Dodokamel2005/EPS-/bac-hardware/README.md

# bac-hardware

Hardware design and manufacturing files for the Build a CubeSat project. Includes ECAD files, BOMs, gerber files, notes and other relevant artifacts.
