Dodokamel2005/EPS-/bac-hardware/eps/DISCLAIMER.md

# Disclaimer

This project contains the design files for an EPS (Electrical Power System) PCB intended for use in a CubeSat. Please note that this hardware has not been tested and is provided "as is" without any guarantees or warranties. By using these files, you acknowledge and agree that:

1. The hardware design has not been tested or validated in any capacity.
2. Any use of this hardware design is at your own risk.
3. The authors and contributors to this project are not liable for any damages, losses, or issues that arise from the use of these design files.
4. You are responsible for thoroughly testing and validating the hardware design before any use in critical applications.

We strongly recommend that you perform extensive testing and validation before using this hardware in any real-world applications, particularly in mission-critical or safety-critical environments.
