Dodokamel2005/EPS-/bac-hardware/adcs/magnetorquer-placeholder-XY/1.5U/bac_Magnetorquer_XY_1.5U_v1r2_EdgeCuts.dxf

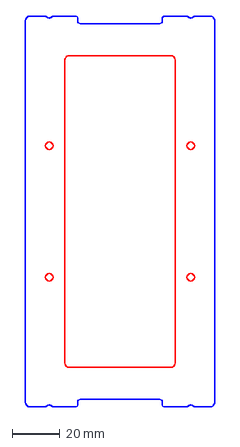
[picture p2: CAD file, 2025-06-12]
bac-hardware/adcs/magnetorquer-placeholder-XY/1.5U/bac_Magnetorquer_XY_1.5U_v1r2_EdgeCuts.dxf
79.2 x 163.4 mm
