Dodokamel2005/EPS-/bac-hardware/adcs/magnetorquer-placeholder-XY/1U/bac_Magnetorquer_XY_1U_v1r2_EdgeCuts.dxf

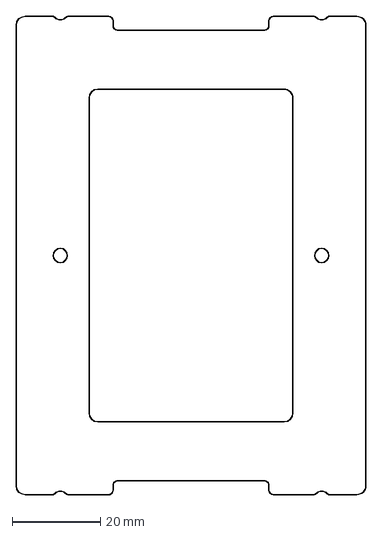
[picture p3: CAD file, 2025-06-12]
bac-hardware/adcs/magnetorquer-placeholder-XY/1U/bac_Magnetorquer_XY_1U_v1r2_EdgeCuts.dxf
79.2 x 108.4 mm
