Dodokamel2005/EPS-/bac-hardware/adcs/magnetorquer-placeholder-XY/2U/bac_Magnetorquer_XY_2U_v1r2_EdgeCuts.dxf

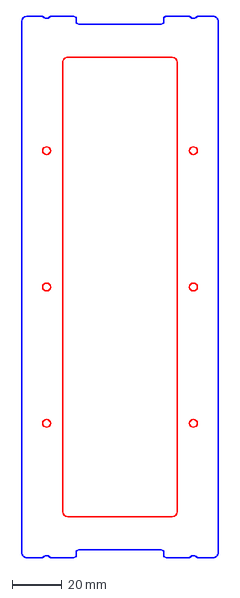
[picture p4: CAD file, 2025-06-12]
bac-hardware/adcs/magnetorquer-placeholder-XY/2U/bac_Magnetorquer_XY_2U_v1r2_EdgeCuts.dxf
79.2 x 218.4 mm
