Dodokamel2005/EPS-/bac-hardware/adcs/magnetorquer-placeholder-XY/3U/bac_Magnetorquer_XY_3U_v1r1_EdgeCuts.dxf

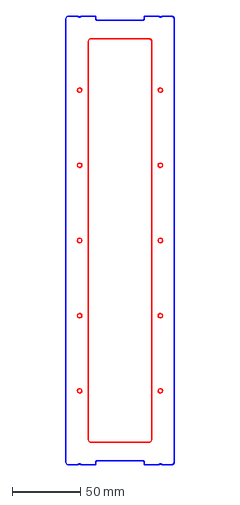
[picture p5: CAD file, 2025-06-12]
bac-hardware/adcs/magnetorquer-placeholder-XY/3U/bac_Magnetorquer_XY_3U_v1r1_EdgeCuts.dxf
79.2 x 328.4 mm
