Dodokamel2005/EPS-/bac-hardware/eps/battery-contact/18650-2s2p/graphics/bac_EPS_Bay_v1r1_Battery_Contact_EdgeCuts.dxf

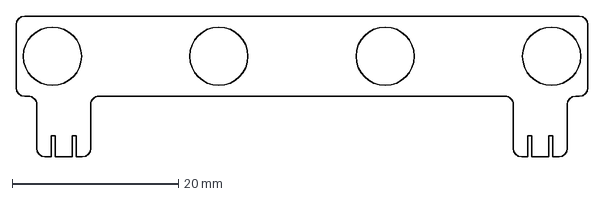
[picture p6: CAD file, 2025-06-12]
bac-hardware/eps/battery-contact/18650-2s2p/graphics/bac_EPS_Bay_v1r1_Battery_Contact_EdgeCuts.dxf
68.7 x 16.9 mm
