Dodokamel2005/EPS-/bac-hardware/eps/eps-main-board/full/design/bac_EPS_Bay_v1r1_EdgeCuts.dxf

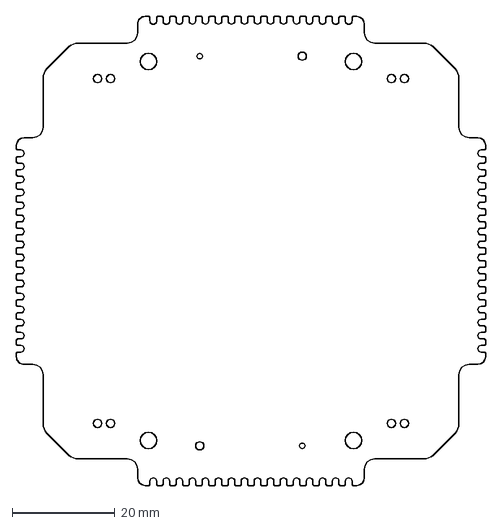
[picture p7: CAD file, 2025-06-12]
bac-hardware/eps/eps-main-board/full/design/bac_EPS_Bay_v1r1_EdgeCuts.dxf
91.5 x 91.5 mm
