Dodokamel2005/EPS-/bac-hardware/mcu/micromod-main-board/dual-function-single-bacbus/graphics/bac_PCB_Rail_Mount_v2r1_Pad_Keepouts.dxf

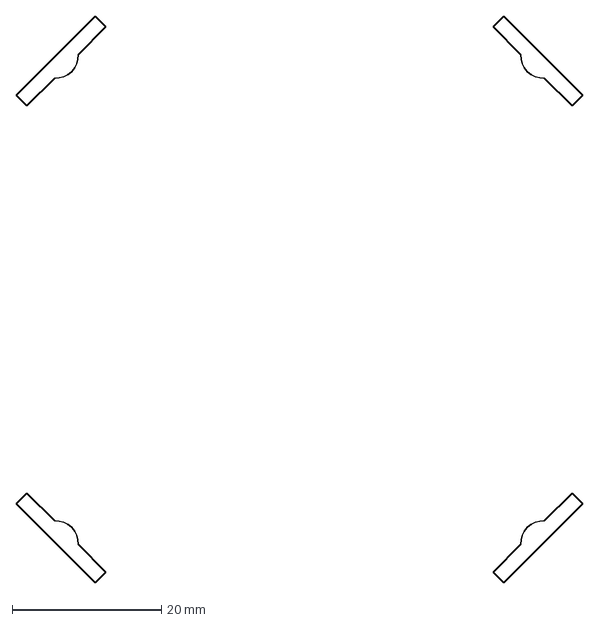
[picture p8: CAD file, 2025-06-12]
bac-hardware/mcu/micromod-main-board/dual-function-single-bacbus/graphics/bac_PCB_Rail_Mount_v2r1_Pad_Keepouts.dxf
76.0 x 76.0 mm
