Dodokamel2005/EPS-/bac-hardware/panel/hatch/design/bac_Panel_Hatch_v1r1_EdgeCuts.dxf

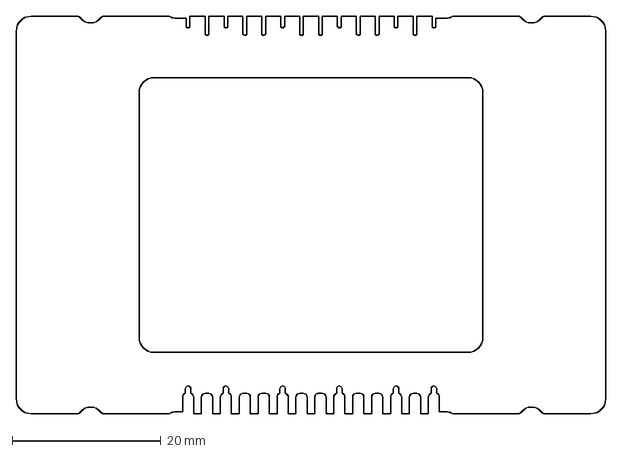
[picture p9: CAD file, 2025-06-12]
bac-hardware/panel/hatch/design/bac_Panel_Hatch_v1r1_EdgeCuts.dxf
79.2 x 53.4 mm
