Dodokamel2005/EPS-/bac-hardware/panel/pv/design/bac_Panel_PV_v1r1_EdgeCuts.dxf

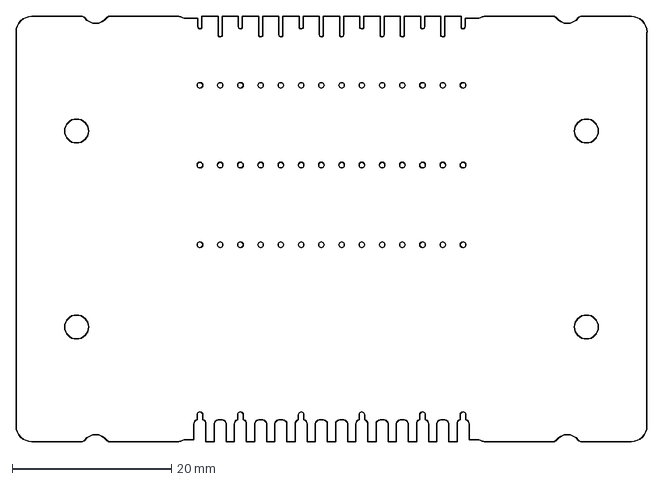
[picture p10: CAD file, 2025-06-12]
bac-hardware/panel/pv/design/bac_Panel_PV_v1r1_EdgeCuts.dxf
79.2 x 53.4 mm
