Dodokamel2005/EPS-/bac-hardware/resources/kicad-libraries/cm5-carrier-v1/3d/piecol-B3U-3000PM-B.step

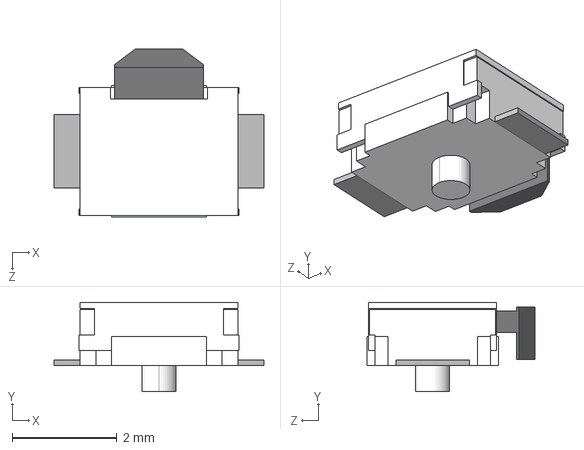
[picture p11: CAD file, 2025-06-12]
bac-hardware/resources/kicad-libraries/cm5-carrier-v1/3d/piecol-B3U-3000PM-B.step
4.00 x 1.70 x 3.20 mm
