Dodokamel2005/EPS-/bac-hardware/resources/kicad-libraries/eps-v1/3d/Cantherm-MF52A1103F3380.step

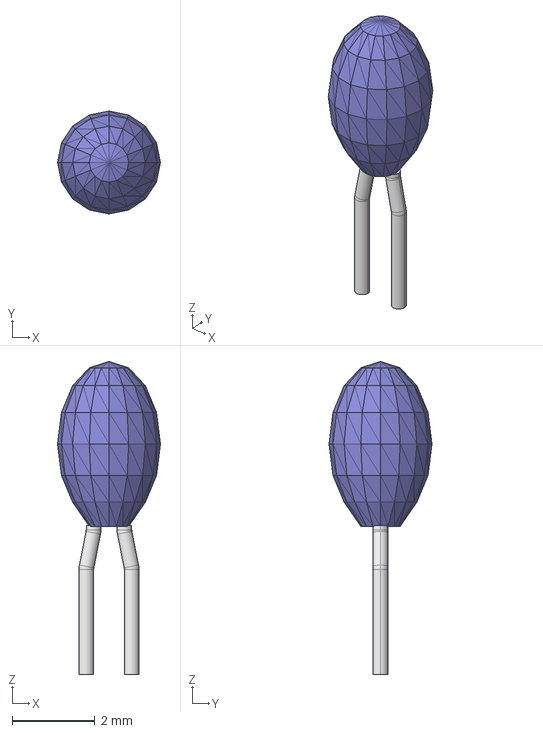
[picture p12: CAD file, 2025-06-12]
bac-hardware/resources/kicad-libraries/eps-v1/3d/Cantherm-MF52A1103F3380.step
2.49 x 2.49 x 7.57 mm
