Dodokamel2005/EPS-/bac-hardware/resources/kicad-libraries/micromod-mainboard-v1/3d/TI-PCA9545APWR.step

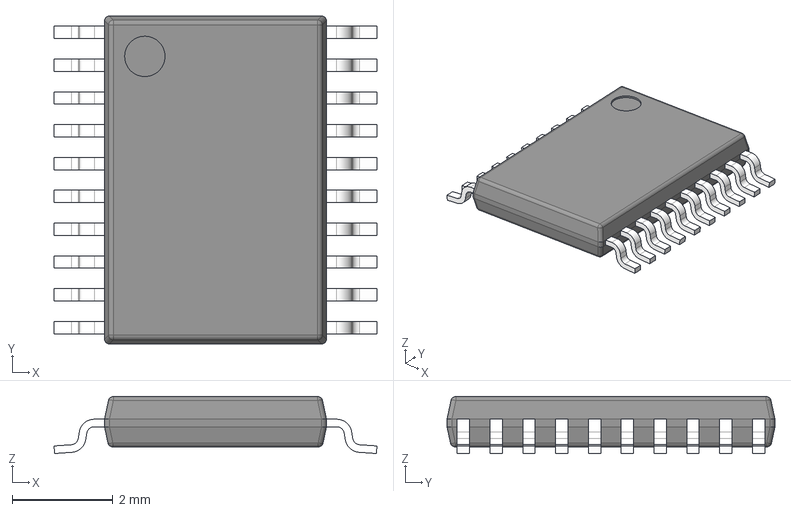
[picture p13: CAD file, 2025-06-12]
bac-hardware/resources/kicad-libraries/micromod-mainboard-v1/3d/TI-PCA9545APWR.step
6.40 x 6.50 x 1.13 mm
BODY-TSSOP
LEAD-TSSOP x 20
PIN1
