Dodokamel2005/EPS-/bac-hardware/resources/kicad-template/bac_PCB_Rail_Mount_v2r1_Outline.dxf

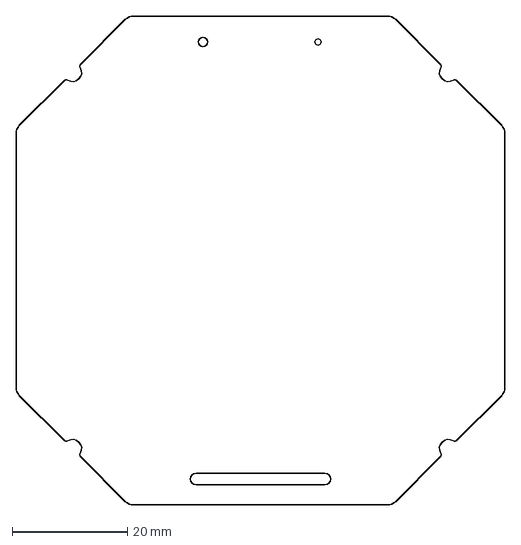
[picture p14: CAD file, 2025-06-12]
bac-hardware/resources/kicad-template/bac_PCB_Rail_Mount_v2r1_Outline.dxf
85.0 x 85.0 mm
