Dodokamel2005/EPS-/bac-hardware/panel/hatch/design/bac_Panel_PV_v1r1_EdgeCuts_pinslots_0.6mm.dxf

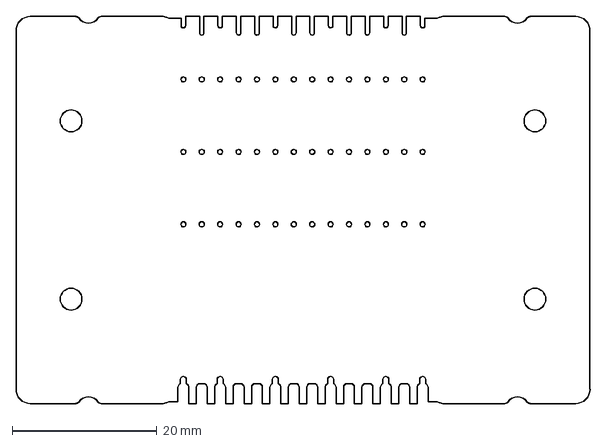
[picture p15: CAD file, 2025-06-12]
bac-hardware/panel/hatch/design/bac_Panel_PV_v1r1_EdgeCuts_pinslots_0.6mm.dxf
79.2 x 53.4 mm
