Dodokamel2005/EPS-/bac-hardware/resources/kicad-libraries/eps-v1/3d/C-2917-100uf-POL.STEP

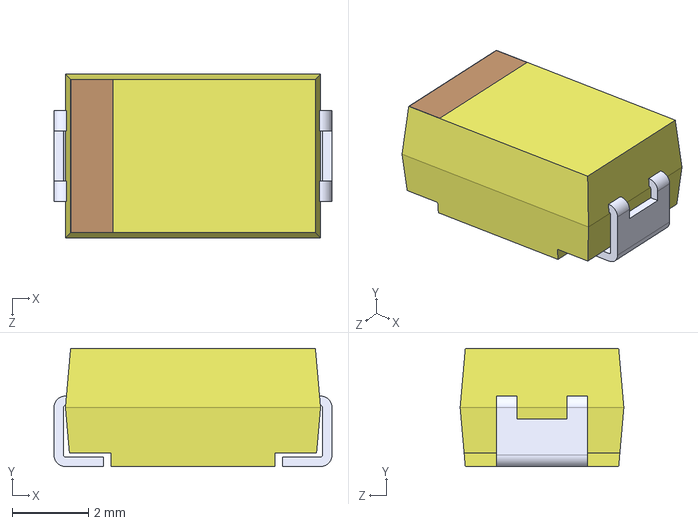
[picture p17: CAD file, 2025-06-12]
bac-hardware/resources/kicad-libraries/eps-v1/3d/C-2917-100uf-POL.STEP
7.30 x 3.10 x 4.30 mm
