Dodokamel2005/EPS-/bac-hardware/resources/kicad-libraries/micromod-mainboard-v1/3d/KEY-2899.step

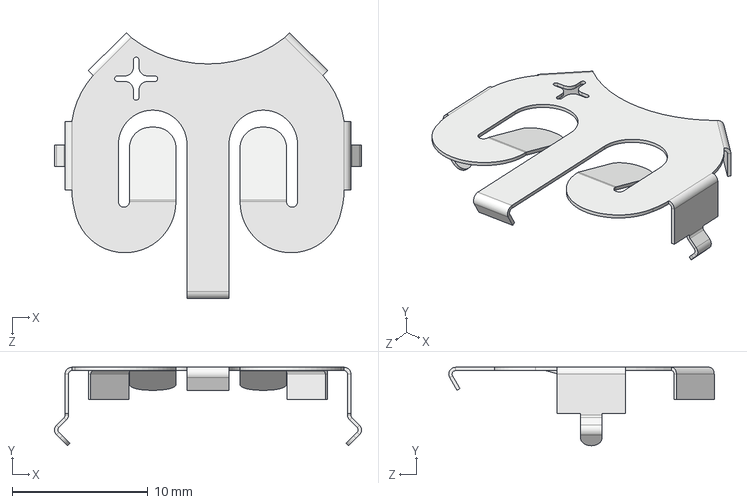
[picture p18: CAD file, 2025-06-12]
bac-hardware/resources/kicad-libraries/micromod-mainboard-v1/3d/KEY-2899.step
22.6 x 5.79 x 19.6 mm
