Dodokamel2005/EPS-/bac-hardware/resources/kicad-libraries/cm5-carrier-v1/3d/piecol-471511051.step

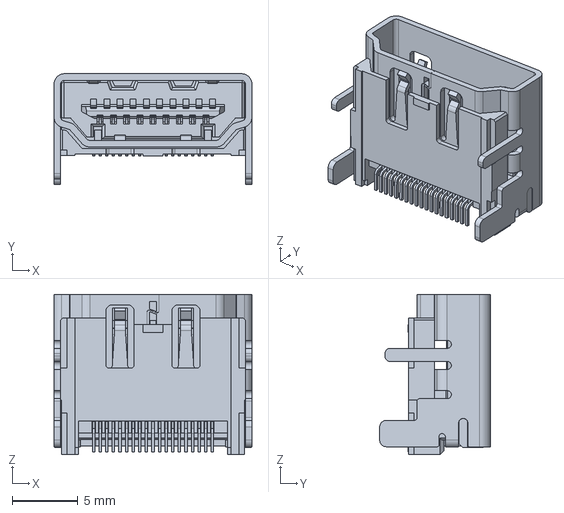
[picture p19: CAD file, 2025-06-12]
bac-hardware/resources/kicad-libraries/cm5-carrier-v1/3d/piecol-471511051.step
15.0 x 8.38 x 12.2 mm
