Dodokamel2005/EPS-/bac-hardware/resources/kicad-libraries/eps-v1/3d/VIS-SIPQ32434BDN-T1E3.step

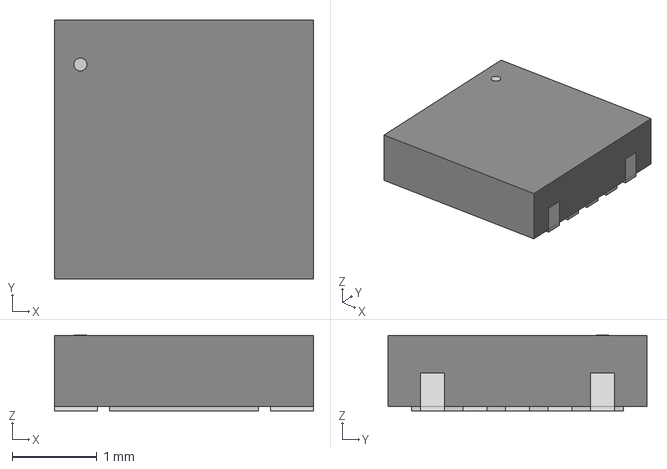
[picture p20: CAD file, 2025-06-12]
bac-hardware/resources/kicad-libraries/eps-v1/3d/VIS-SIPQ32434BDN-T1E3.step
3.05 x 3.05 x 0.892 mm
