Dodokamel2005/EPS-/bac-hardware/resources/kicad-libraries/micromod-mainboard-v1/3d/TI-TS5A3359DCUR.step

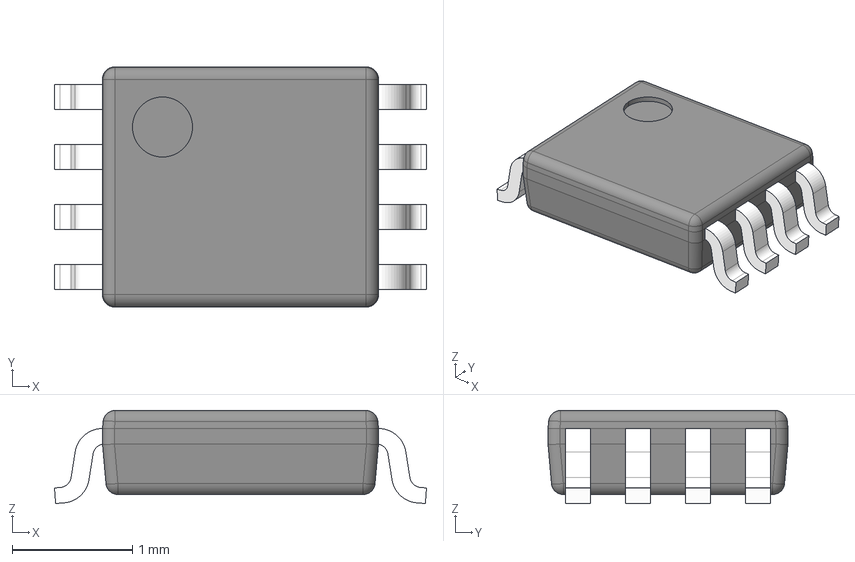
[picture p21: CAD file, 2025-06-12]
bac-hardware/resources/kicad-libraries/micromod-mainboard-v1/3d/TI-TS5A3359DCUR.step
3.10 x 2.00 x 0.775 mm
BODY-VSSOP
LEAD-VSSOP x 8
