Dodokamel2005/EPS-/bac-hardware/resources/kicad-libraries/cm5-carrier-v1/3d/piecol-BM04B-SRSS-TB.step

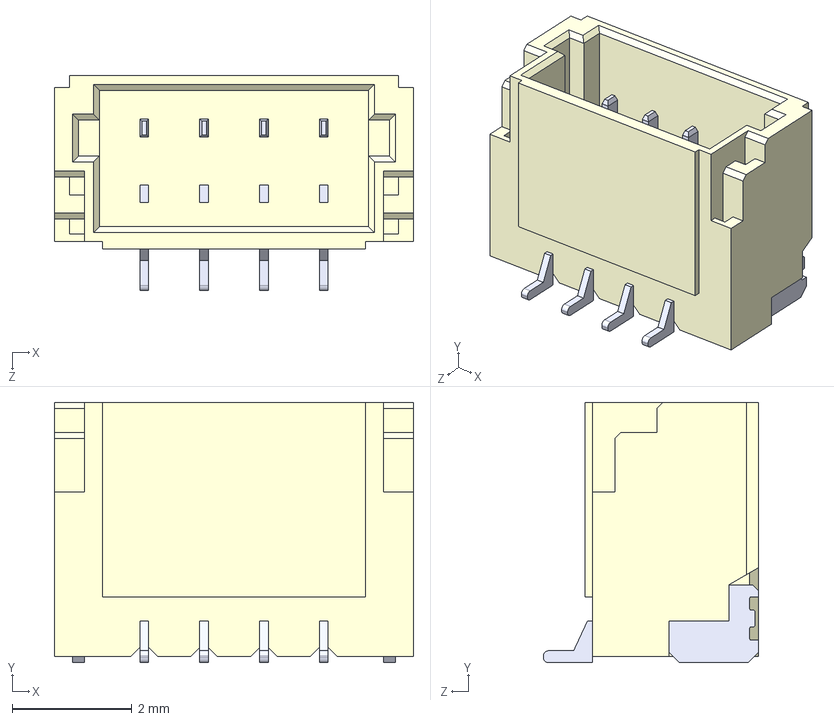
[picture p22: CAD file, 2025-06-12]
bac-hardware/resources/kicad-libraries/cm5-carrier-v1/3d/piecol-BM04B-SRSS-TB.step
6.00 x 4.35 x 3.60 mm
