Dodokamel2005/EPS-/bac-hardware/resources/kicad-libraries/eps-v1/3d/TI-ADS1015IRUGR.stp

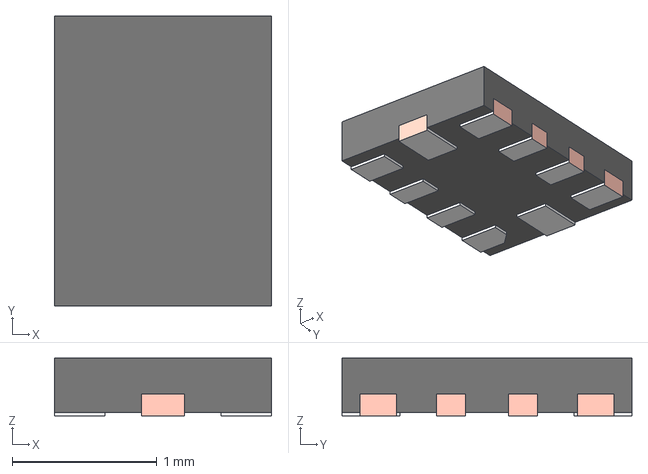
[picture p23: CAD file, 2025-06-12]
bac-hardware/resources/kicad-libraries/eps-v1/3d/TI-ADS1015IRUGR.stp
1.50 x 2.00 x 0.4 mm
FRAME_RUG0010A
BODY_RUG0010A
