Dodokamel2005/EPS-/bac-hardware/resources/kicad-libraries/micromod-mainboard-v1/3d/CEVA-BNO086.step

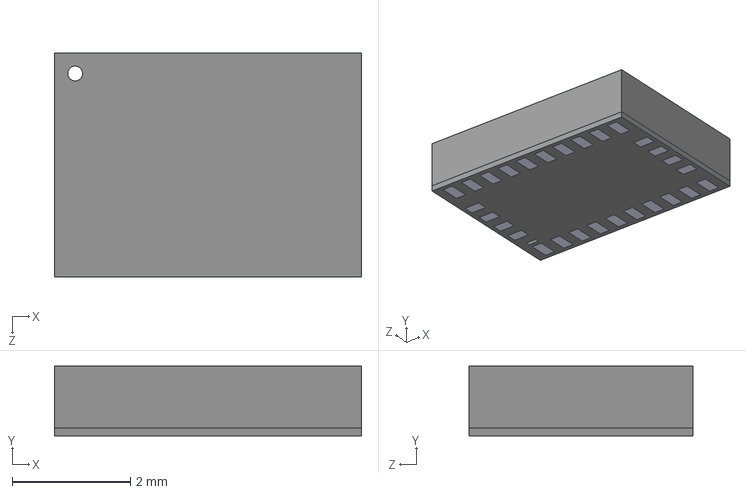
[picture p24: CAD file, 2025-06-12]
bac-hardware/resources/kicad-libraries/micromod-mainboard-v1/3d/CEVA-BNO086.step
5.20 x 1.18 x 3.80 mm
