Dodokamel2005/EPS-/bac-hardware/resources/kicad-libraries/cm5-carrier-v1/3d/piecol-TRJG0926HENL .step

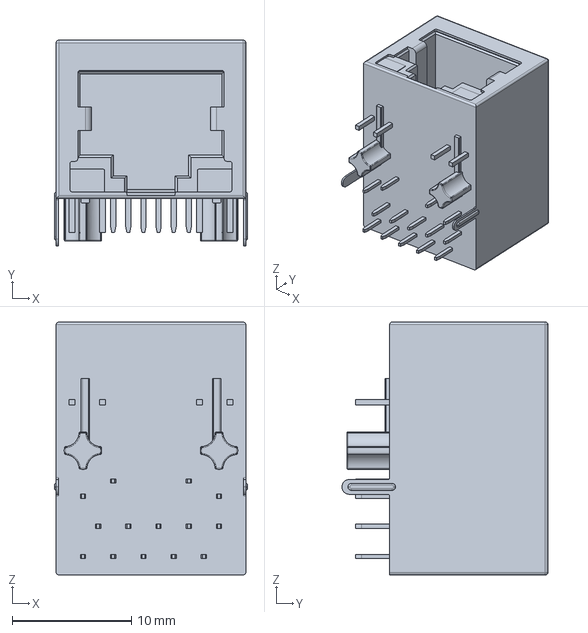
[picture p25: CAD file, 2025-06-12]
bac-hardware/resources/kicad-libraries/cm5-carrier-v1/3d/piecol-TRJG0926HENL .step
16.2 x 17.3 x 21.2 mm
