Dodokamel2005/EPS-/bac-hardware/resources/kicad-libraries/eps-v1/3d/TI-TPSM5D1806RDBR.step

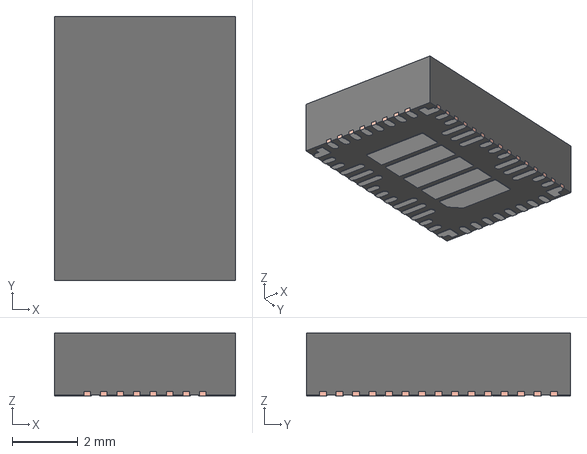
[picture p26: CAD file, 2025-06-12]
bac-hardware/resources/kicad-libraries/eps-v1/3d/TI-TPSM5D1806RDBR.step
5.50 x 8.00 x 1.90 mm
FRAME
MOLD
