Dodokamel2005/EPS-/bac-hardware/resources/kicad-libraries/micromod-mainboard-v1/3d/TI-TCAL9538PWR.step

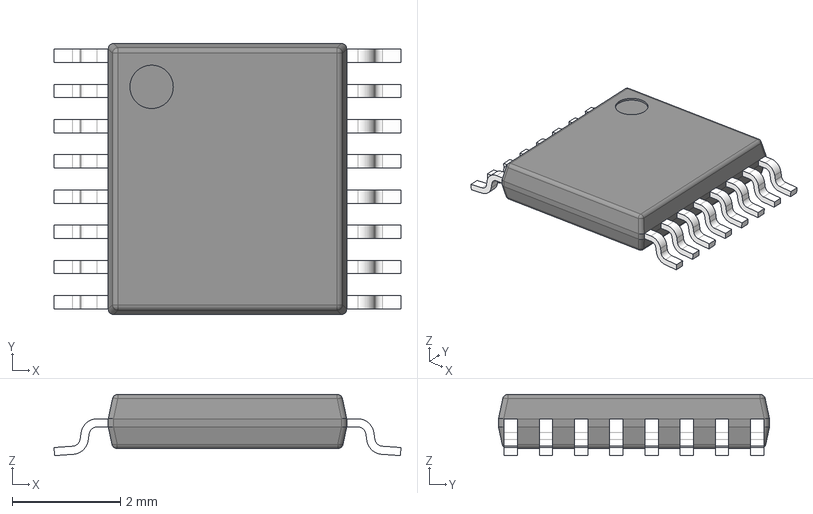
[picture p27: CAD file, 2025-06-12]
bac-hardware/resources/kicad-libraries/micromod-mainboard-v1/3d/TI-TCAL9538PWR.step
6.40 x 5.00 x 1.13 mm
BODY-TSSOP
LEAD-TSSOP x 16
PIN1
