Dodokamel2005/EPS-/bac-hardware/resources/kicad-libraries/cm5-carrier-v1/3d/piecol-WE-RJ45LAN-7498111120AR-(rev1).step

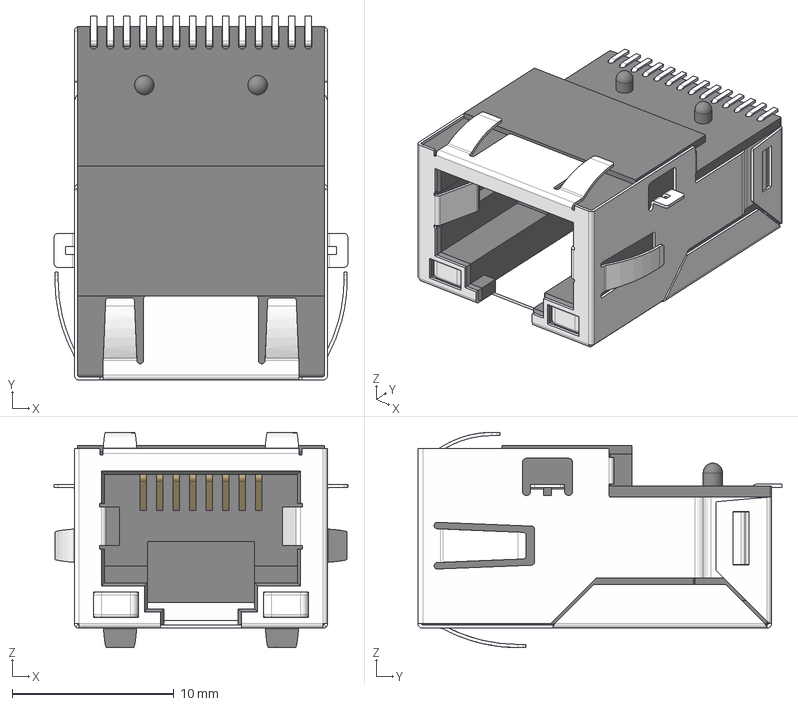
[picture p28: CAD file, 2025-06-12]
bac-hardware/resources/kicad-libraries/cm5-carrier-v1/3d/piecol-WE-RJ45LAN-7498111120AR-(rev1).step
18.1 x 22.5 x 13.3 mm
Shielding
Insulator x 3
