Dodokamel2005/EPS-/bac-hardware/resources/kicad-libraries/eps-v1/3d/TI-LM73100RPWR.stp

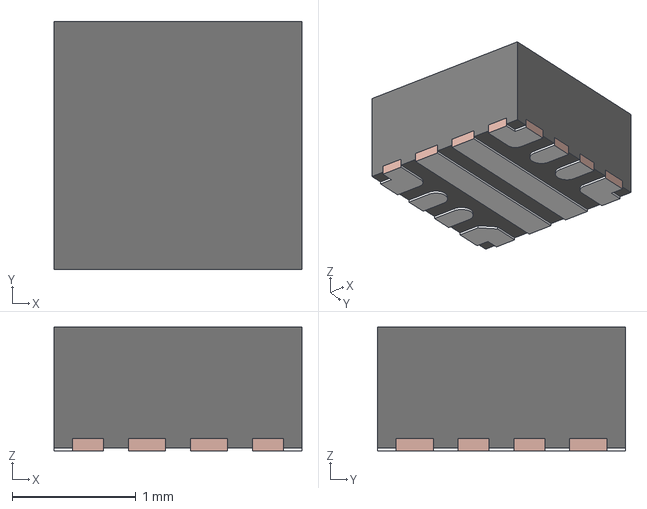
[picture p29: CAD file, 2025-06-12]
bac-hardware/resources/kicad-libraries/eps-v1/3d/TI-LM73100RPWR.stp
2.00 x 2.00 x 1.00 mm
FRAME
MOLD
