Dodokamel2005/EPS-/bac-hardware/resources/kicad-libraries/micromod-mainboard-v1/3d/WE-150080SG54050.step

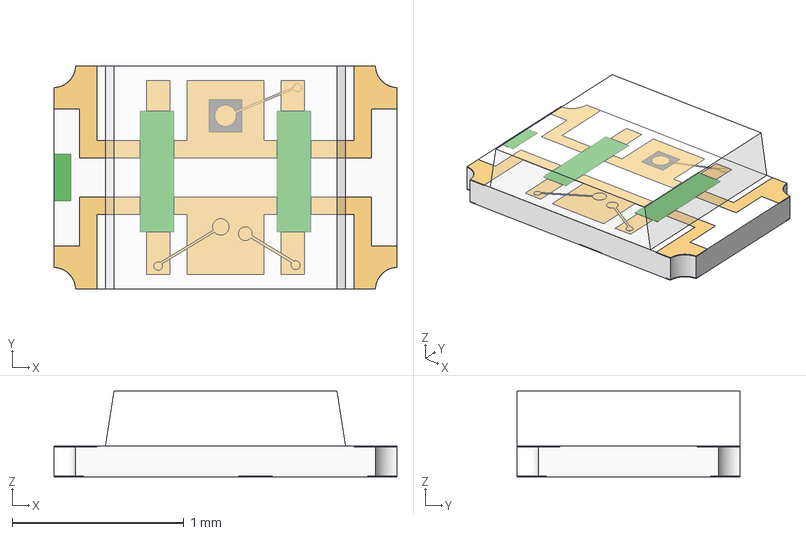
[picture p30: CAD file, 2025-06-12]
bac-hardware/resources/kicad-libraries/micromod-mainboard-v1/3d/WE-150080SG54050.step
2.00 x 1.30 x 0.501 mm
Pins
Dome
