Dodokamel2005/EPS-/bac-hardware/resources/kicad-libraries/cm5-carrier-v1/3d/piecol-3x4x2-tact-button.step

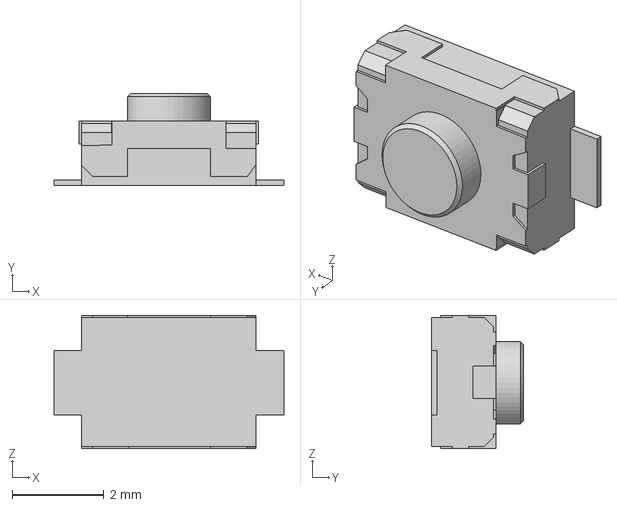
[picture p31: CAD file, 2025-06-12]
bac-hardware/resources/kicad-libraries/cm5-carrier-v1/3d/piecol-3x4x2-tact-button.step
5.00 x 2.00 x 2.90 mm
