Dodokamel2005/EPS-/bac-hardware/resources/kicad-libraries/eps-v1/3d/TI-TPS3842.step

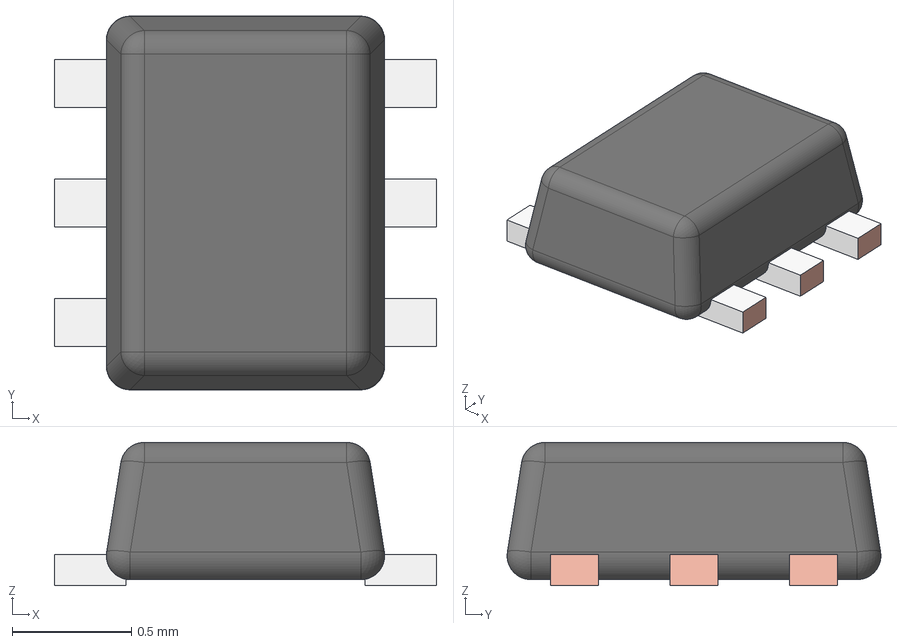
[picture p32: CAD file, 2025-06-12]
bac-hardware/resources/kicad-libraries/eps-v1/3d/TI-TPS3842.step
1.60 x 1.57 x 0.6 mm
FRAME-DRL0006A
BODY-SOT
PIN1-ID
