Dodokamel2005/EPS-/bac-hardware/resources/kicad-libraries/micromod-mainboard-v1/3d/ST-STG3856QTR.step

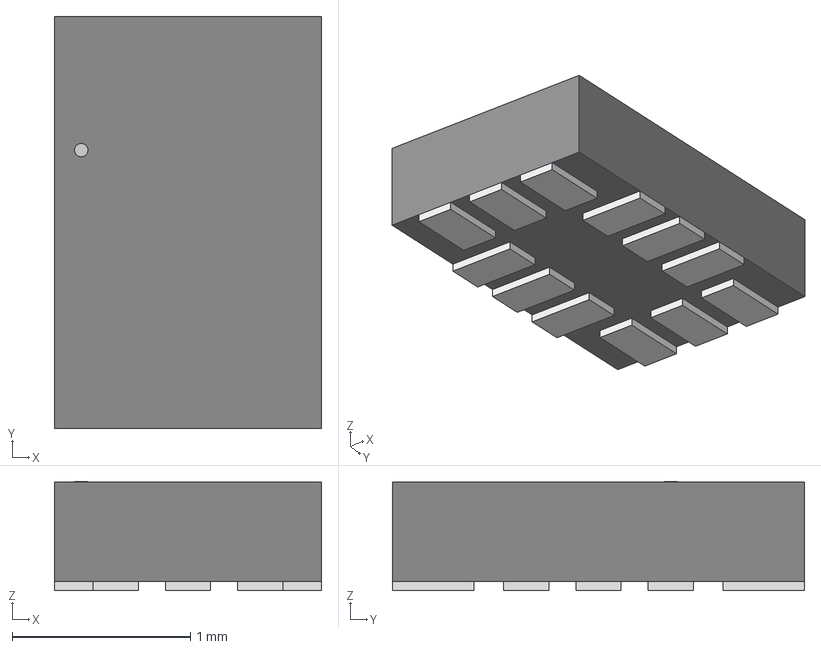
[picture p33: CAD file, 2025-06-12]
bac-hardware/resources/kicad-libraries/micromod-mainboard-v1/3d/ST-STG3856QTR.step
1.50 x 2.31 x 0.612 mm
