Dodokamel2005/EPS-/bac-hardware/resources/kicad-libraries/cm5-carrier-v1/3d/piecol-FH12-22S-0.5SH.step

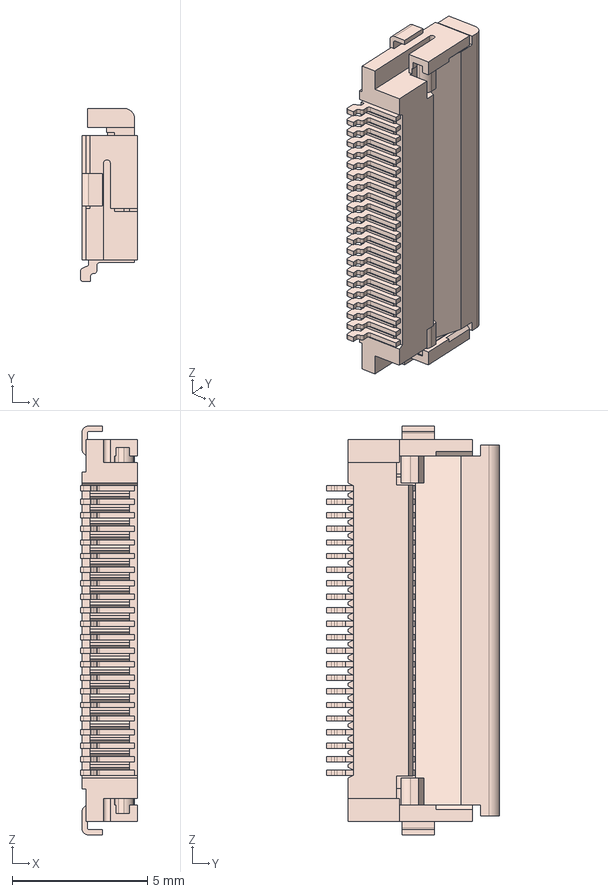
[picture p34: CAD file, 2025-06-12]
bac-hardware/resources/kicad-libraries/cm5-carrier-v1/3d/piecol-FH12-22S-0.5SH.step
2.10 x 6.40 x 15.1 mm
