Dodokamel2005/EPS-/bac-hardware/resources/kicad-libraries/eps-v1/3d/TI-TCAL9539RTWR.stp

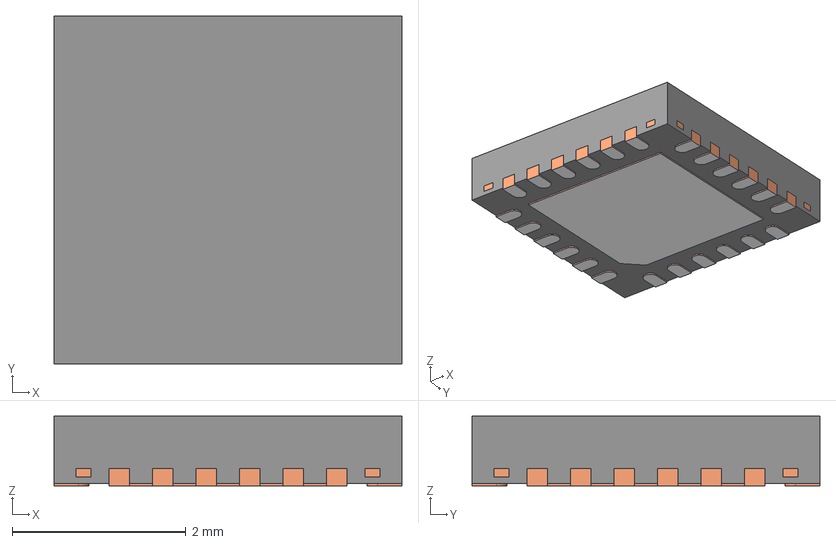
[picture p35: CAD file, 2025-06-12]
bac-hardware/resources/kicad-libraries/eps-v1/3d/TI-TCAL9539RTWR.stp
4.00 x 4.00 x 0.8 mm
BODY-QFN
FRAME-RTW0024H
PIN1-ID
