Dodokamel2005/EPS-/bac-hardware/resources/kicad-libraries/micromod-mainboard-v1/3d/SIT-SIT5000AI-2E-33N0.step

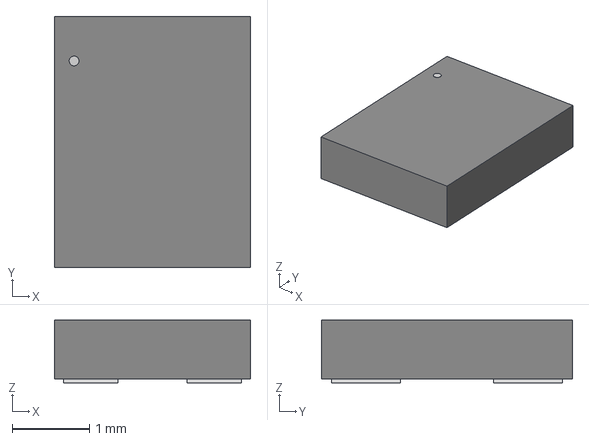
[picture p36: CAD file, 2025-06-12]
bac-hardware/resources/kicad-libraries/micromod-mainboard-v1/3d/SIT-SIT5000AI-2E-33N0.step
2.54 x 3.25 x 0.815 mm
