Dodokamel2005/EPS-/bac-hardware/resources/kicad-libraries/eps-v1/3d/NXP-PCT2075TP,147.step

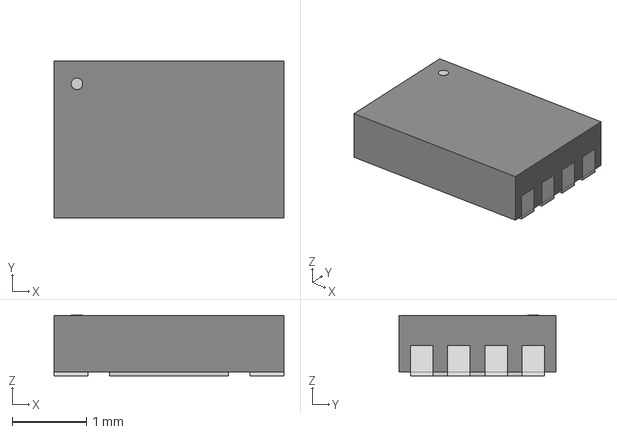
[picture p38: CAD file, 2025-06-12]
bac-hardware/resources/kicad-libraries/eps-v1/3d/NXP-PCT2075TP,147.step
3.10 x 2.11 x 0.815 mm
