Dodokamel2005/EPS-/bac-hardware/resources/kicad-libraries/micromod-mainboard-v1/3d/FU-MB85RS256B.step

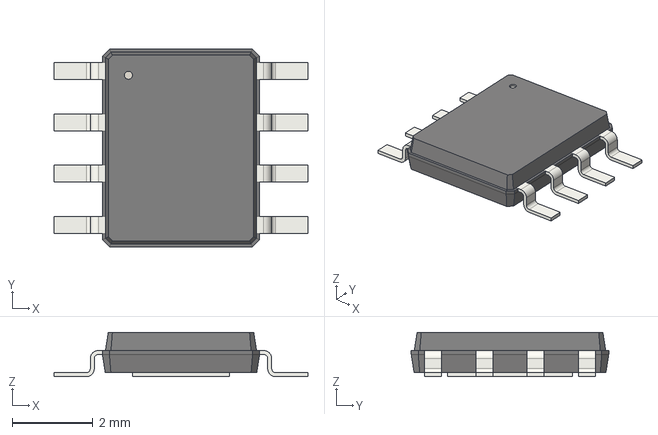
[picture p39: CAD file, 2025-06-12]
bac-hardware/resources/kicad-libraries/micromod-mainboard-v1/3d/FU-MB85RS256B.step
6.30 x 4.90 x 1.10 mm
