Dodokamel2005/EPS-/bac-hardware/resources/kicad-libraries/cm5-carrier-v1/3d/piecol-10164227-1001a1rlf.step

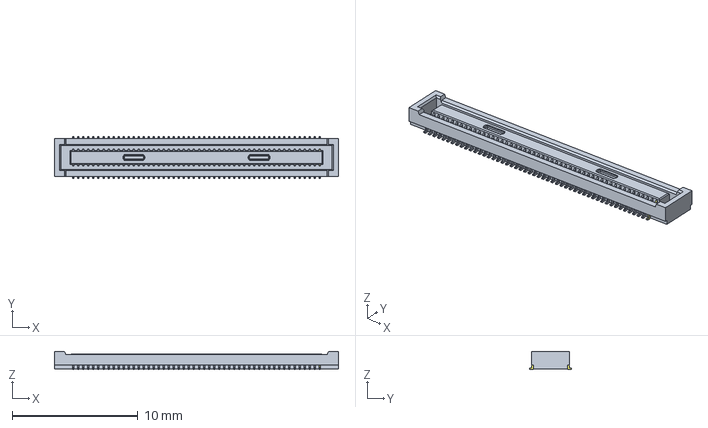
[picture p40: CAD file, 2025-06-12]
bac-hardware/resources/kicad-libraries/cm5-carrier-v1/3d/piecol-10164227-1001a1rlf.step
22.6 x 3.38 x 1.45 mm
