Dodokamel2005/EPS-/bac-hardware/resources/kicad-libraries/eps-v1/3d/TI-ADS7138QRTERQ1.stp

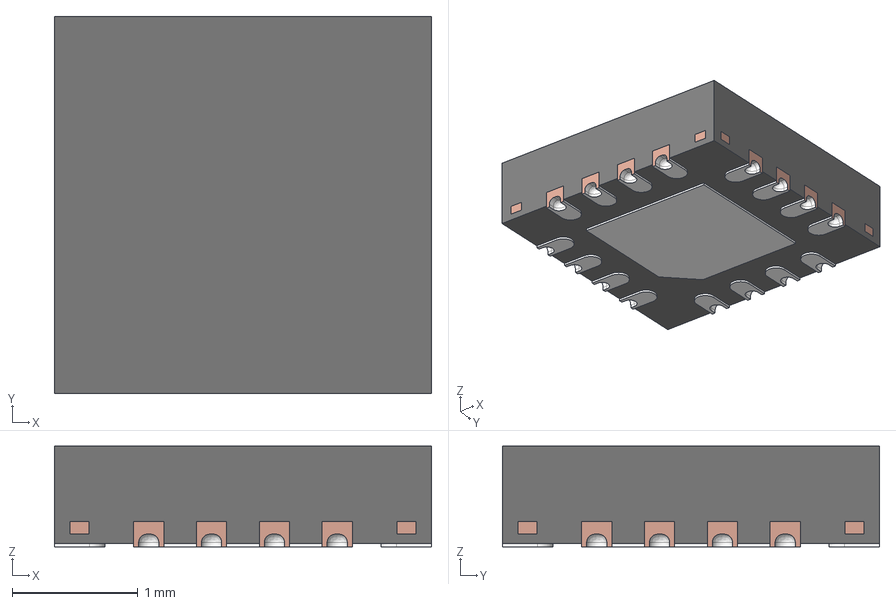
[picture p41: CAD file, 2025-06-12]
bac-hardware/resources/kicad-libraries/eps-v1/3d/TI-ADS7138QRTERQ1.stp
3.00 x 3.00 x 0.8 mm
BODY-QFN
FRAME-RTE0016K
PIN1-ID
