Dodokamel2005/EPS-/bac-hardware/resources/kicad-libraries/micromod-mainboard-v1/3d/MT-MCP251863T-H-SS.step

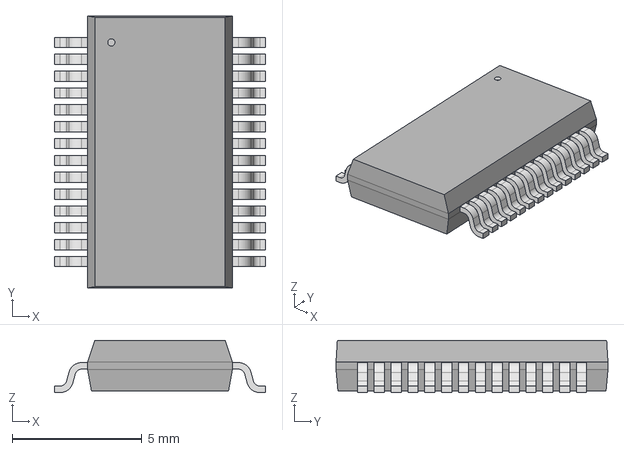
[picture p42: CAD file, 2025-06-12]
bac-hardware/resources/kicad-libraries/micromod-mainboard-v1/3d/MT-MCP251863T-H-SS.step
8.15 x 10.5 x 2.01 mm
