Dodokamel2005/EPS-/bac-hardware/resources/kicad-libraries/cm5-carrier-v1/3d/piecol-BM6B-SRSS-TB.step

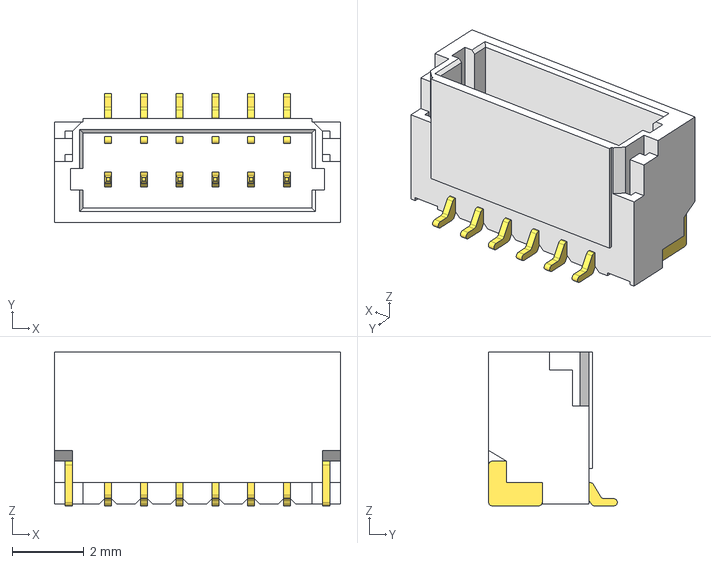
[picture p43: CAD file, 2025-06-12]
bac-hardware/resources/kicad-libraries/cm5-carrier-v1/3d/piecol-BM6B-SRSS-TB.step
8.00 x 3.60 x 4.30 mm
