Dodokamel2005/EPS-/bac-hardware/resources/kicad-libraries/eps-v1/3d/ADI-LTM4675IY.step

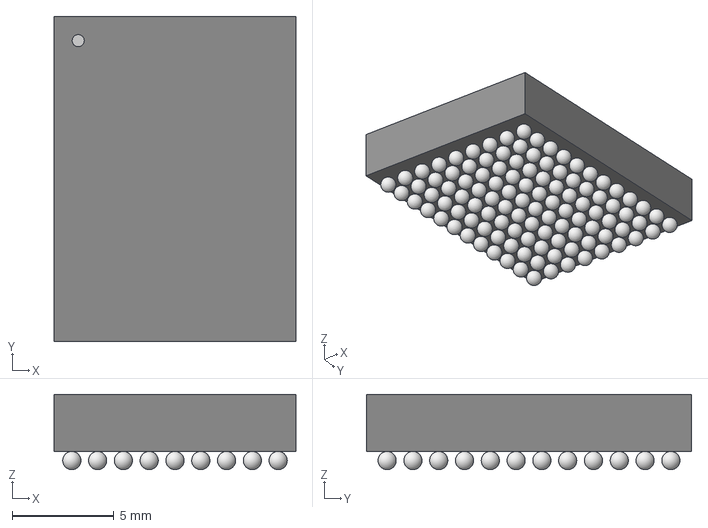
[picture p44: CAD file, 2025-06-12]
bac-hardware/resources/kicad-libraries/eps-v1/3d/ADI-LTM4675IY.step
11.9 x 16.0 x 3.71 mm
