Dodokamel2005/EPS-/bac-hardware/resources/kicad-libraries/micromod-mainboard-v1/3d/JAE-DX07S016JA1R1500.step

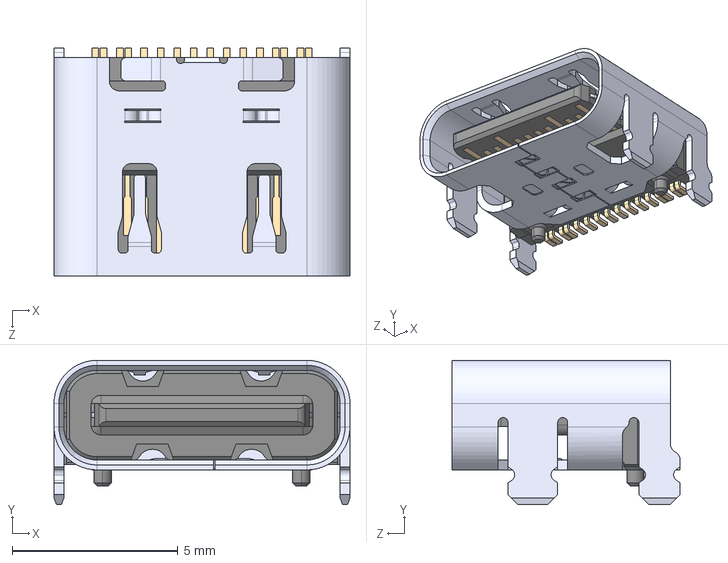
[picture p45: CAD file, 2025-06-12]
bac-hardware/resources/kicad-libraries/micromod-mainboard-v1/3d/JAE-DX07S016JA1R1500.step
8.94 x 4.36 x 6.90 mm
