Dodokamel2005/EPS-/bac-hardware/resources/kicad-libraries/cm5-carrier-v1/3d/piecol-SHTC3-TR-10KS.step

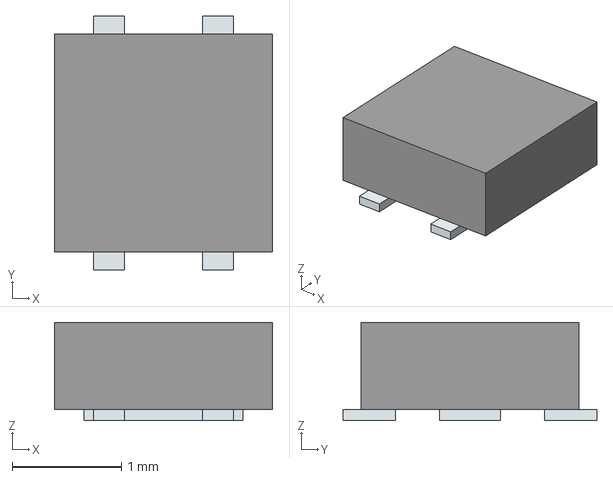
[picture p46: CAD file, 2025-06-12]
bac-hardware/resources/kicad-libraries/cm5-carrier-v1/3d/piecol-SHTC3-TR-10KS.step
2.00 x 2.33 x 0.9 mm
Pins
