Dodokamel2005/EPS-/bac-hardware/resources/kicad-libraries/eps-v1/3d/ADI-LT3045HMSE.step

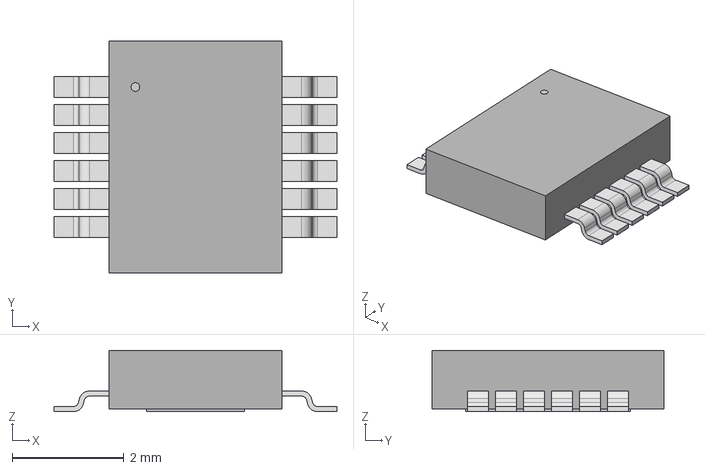
[picture p47: CAD file, 2025-06-12]
bac-hardware/resources/kicad-libraries/eps-v1/3d/ADI-LT3045HMSE.step
5.05 x 4.14 x 1.09 mm
