Dodokamel2005/EPS-/bac-hardware/resources/kicad-libraries/micromod-mainboard-v1/3d/TI-TPS2116DRL.stp

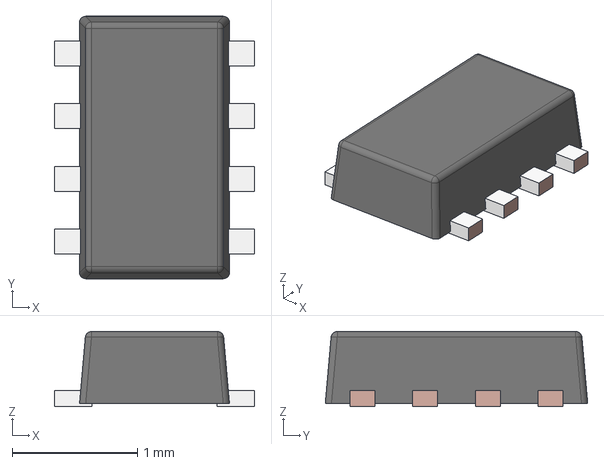
[picture p48: CAD file, 2025-06-12]
bac-hardware/resources/kicad-libraries/micromod-mainboard-v1/3d/TI-TPS2116DRL.stp
1.60 x 2.10 x 0.6 mm
FRAME-DRL0008A
BODY-SOT
