Dodokamel2005/EPS-/bac-hardware/resources/kicad-libraries/eps-v1/3d/TI-ADS1015IDGSR.step

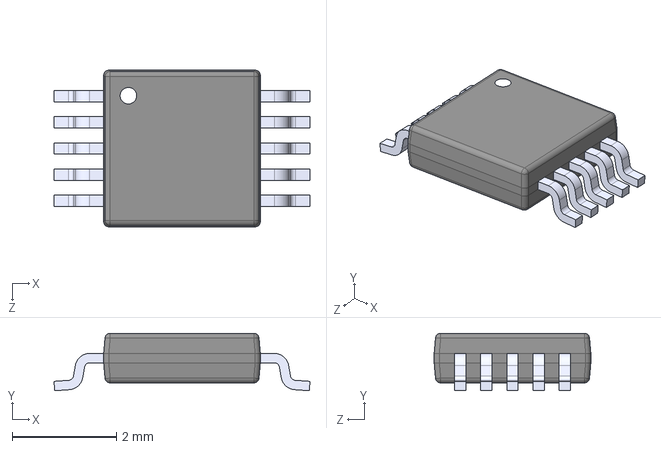
[picture p50: CAD file, 2025-06-12]
bac-hardware/resources/kicad-libraries/eps-v1/3d/TI-ADS1015IDGSR.step
4.90 x 1.10 x 3.00 mm
