Dodokamel2005/EPS-/bac-hardware/resources/kicad-libraries/micromod-mainboard-v1/3d/WE-9774025243R.step

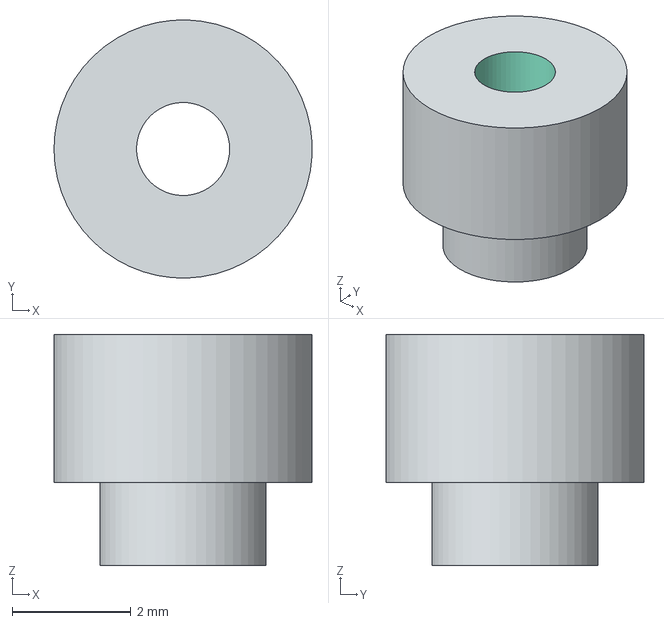
[picture p51: CAD file, 2025-06-12]
bac-hardware/resources/kicad-libraries/micromod-mainboard-v1/3d/WE-9774025243R.step
4.35 x 4.35 x 3.90 mm
