Dodokamel2005/EPS-/bac-hardware/resources/kicad-libraries/cm5-carrier-v1/3d/piecol-MTSSD03-67MSW337.step

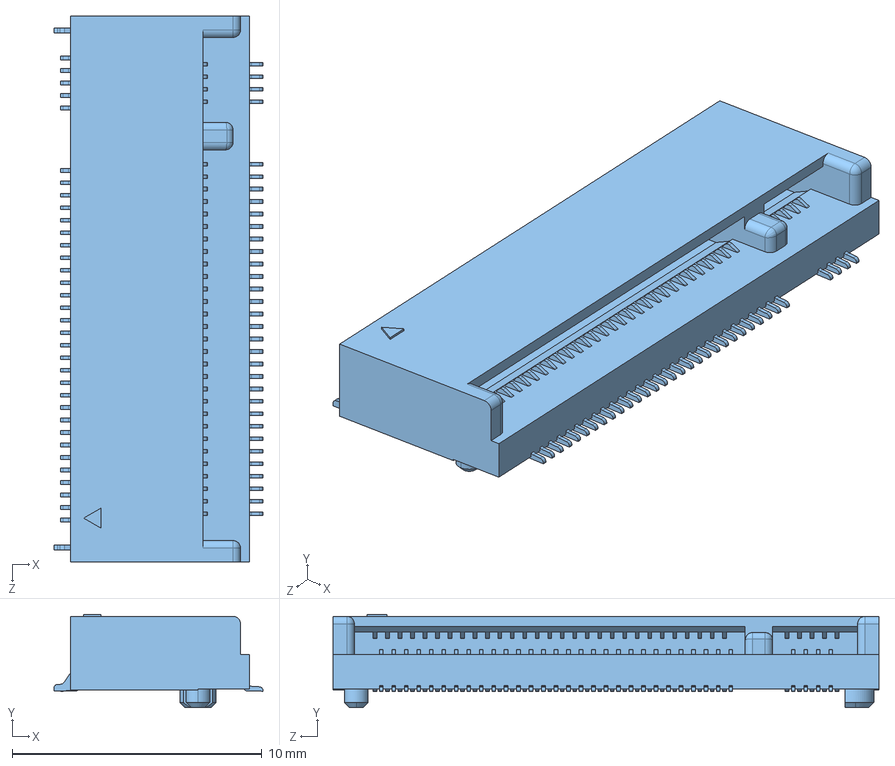
[picture p52: CAD file, 2025-06-12]
bac-hardware/resources/kicad-libraries/cm5-carrier-v1/3d/piecol-MTSSD03-67MSW337.step
8.37 x 3.73 x 21.9 mm
