Dodokamel2005/EPS-/bac-hardware/resources/kicad-libraries/eps-v1/3d/INF-BTS50005-1LUA.stp

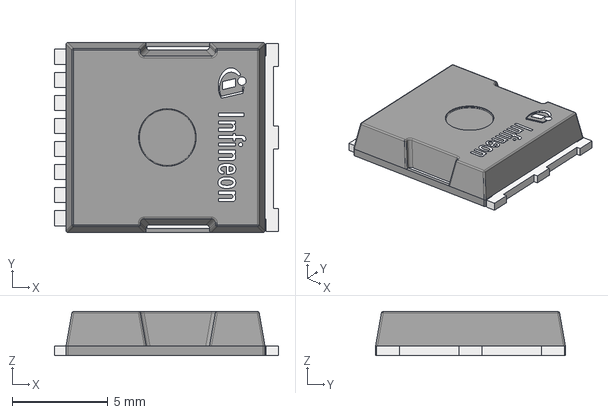
[picture p53: CAD file, 2025-06-12]
bac-hardware/resources/kicad-libraries/eps-v1/3d/INF-BTS50005-1LUA.stp
11.7 x 9.90 x 2.31 mm
