Dodokamel2005/EPS-/bac-hardware/resources/kicad-libraries/micromod-mainboard-v1/3d/TI-PCA9545ARGYR.step

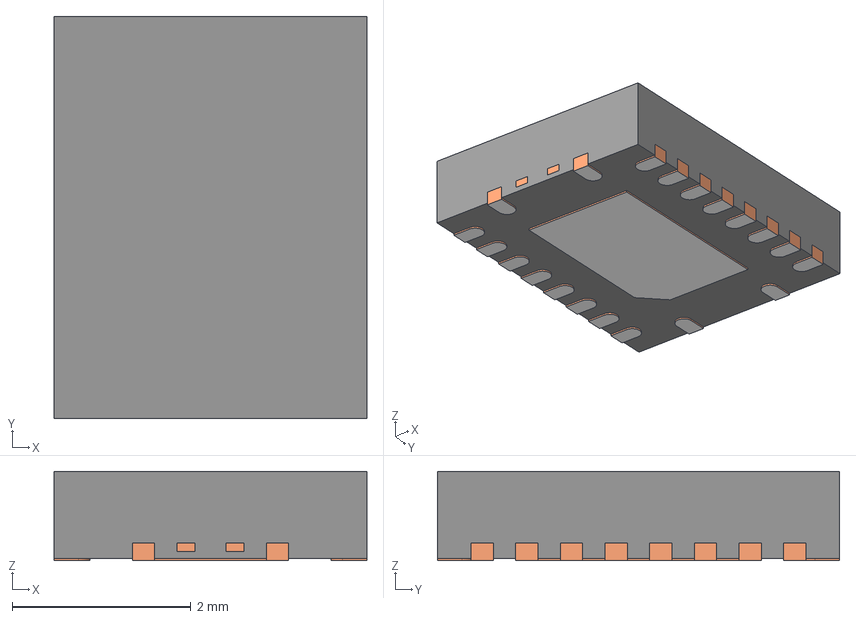
[picture p54: CAD file, 2025-06-12]
bac-hardware/resources/kicad-libraries/micromod-mainboard-v1/3d/TI-PCA9545ARGYR.step
3.50 x 4.50 x 1.00 mm
BODY-QFN
FRAME-RGY0020A
PIN1-ID
