Dodokamel2005/EPS-/bac-hardware/resources/kicad-libraries/cm5-carrier-v1/3d/Molex-0533984004.step

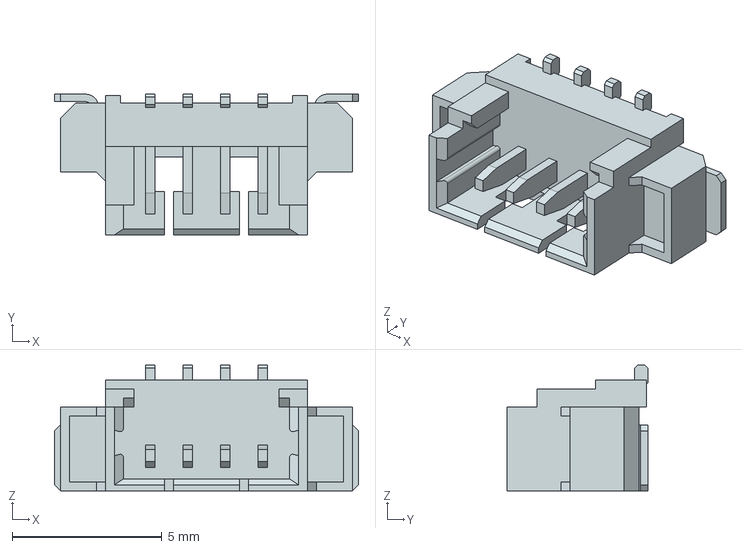
[picture p55: CAD file, 2025-06-12]
bac-hardware/resources/kicad-libraries/cm5-carrier-v1/3d/Molex-0533984004.step
10.2 x 4.70 x 4.20 mm
