Dodokamel2005/EPS-/bac-hardware/resources/kicad-libraries/eps-v1/3d/ADI-LTM8062AEV.STEP

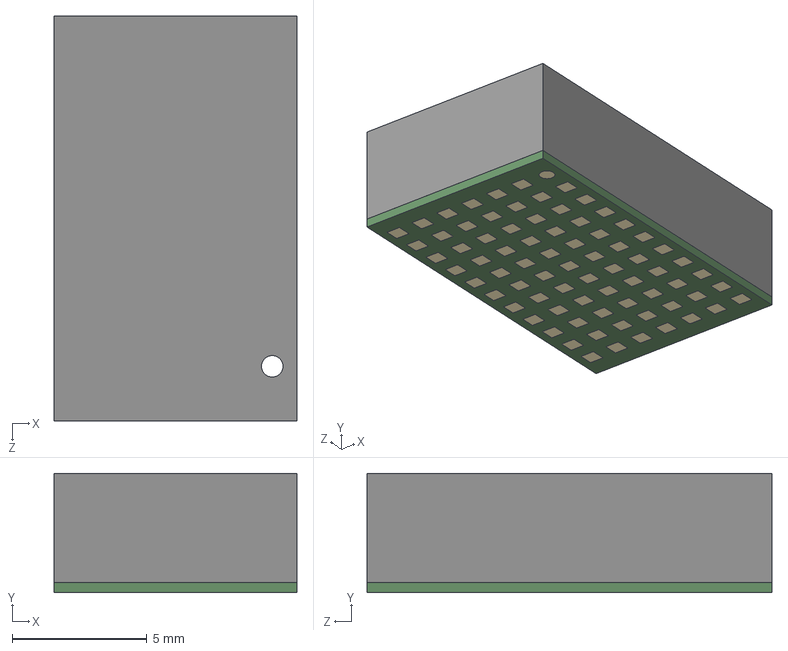
[picture p56: CAD file, 2025-06-12]
bac-hardware/resources/kicad-libraries/eps-v1/3d/ADI-LTM8062AEV.STEP
9.00 x 4.42 x 15.0 mm
