Dodokamel2005/EPS-/bac-hardware/resources/kicad-libraries/micromod-mainboard-v1/3d/WE-78614025360.step

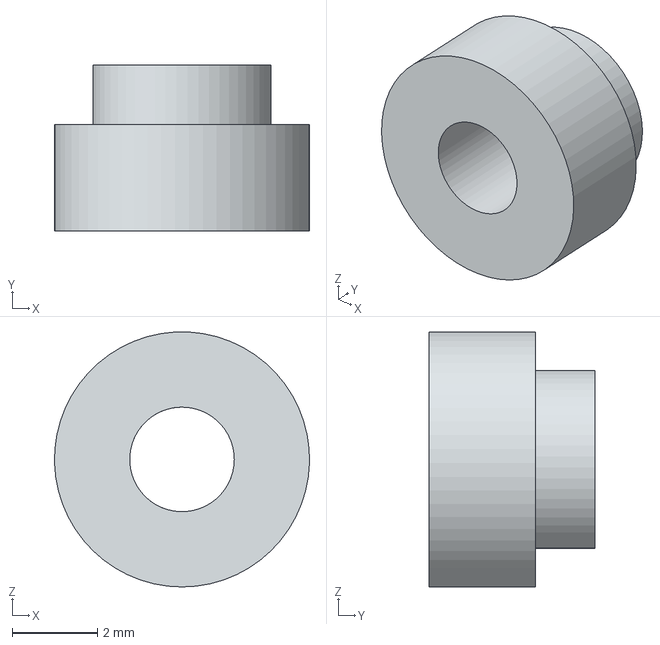
[picture p57: CAD file, 2025-06-12]
bac-hardware/resources/kicad-libraries/micromod-mainboard-v1/3d/WE-78614025360.step
6.00 x 3.90 x 6.00 mm
