Dodokamel2005/EPS-/bac-hardware/resources/kicad-libraries/cm5-carrier-v1/3d/piecol-SRP5030CC.step

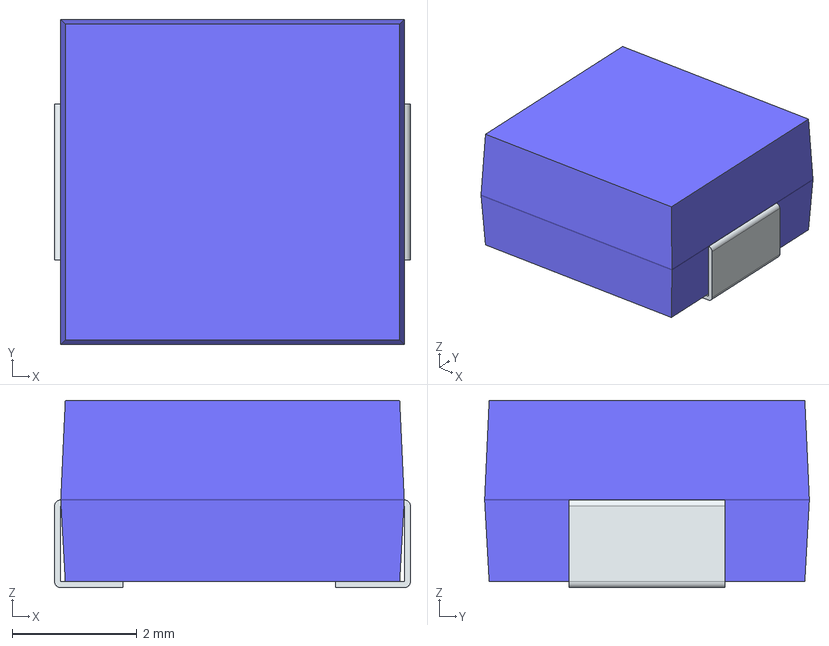
[picture p58: CAD file, 2025-06-12]
bac-hardware/resources/kicad-libraries/cm5-carrier-v1/3d/piecol-SRP5030CC.step
5.70 x 5.20 x 3.00 mm
FilletPin1
FilletPin2
