Dodokamel2005/EPS-/bac-hardware/resources/kicad-libraries/eps-v1/3d/AL-ACS37612LLUATR-010B3.step

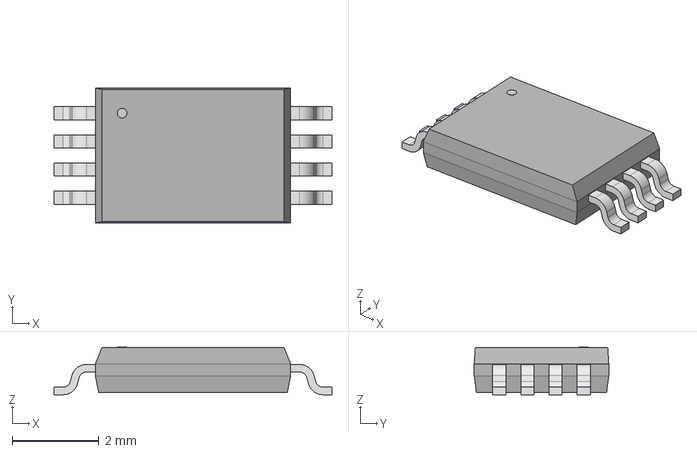
[picture p59: CAD file, 2025-06-12]
bac-hardware/resources/kicad-libraries/eps-v1/3d/AL-ACS37612LLUATR-010B3.step
6.40 x 3.10 x 1.09 mm
