Dodokamel2005/EPS-/bac-hardware/resources/kicad-libraries/micromod-mainboard-v1/3d/bac-C-1411.step

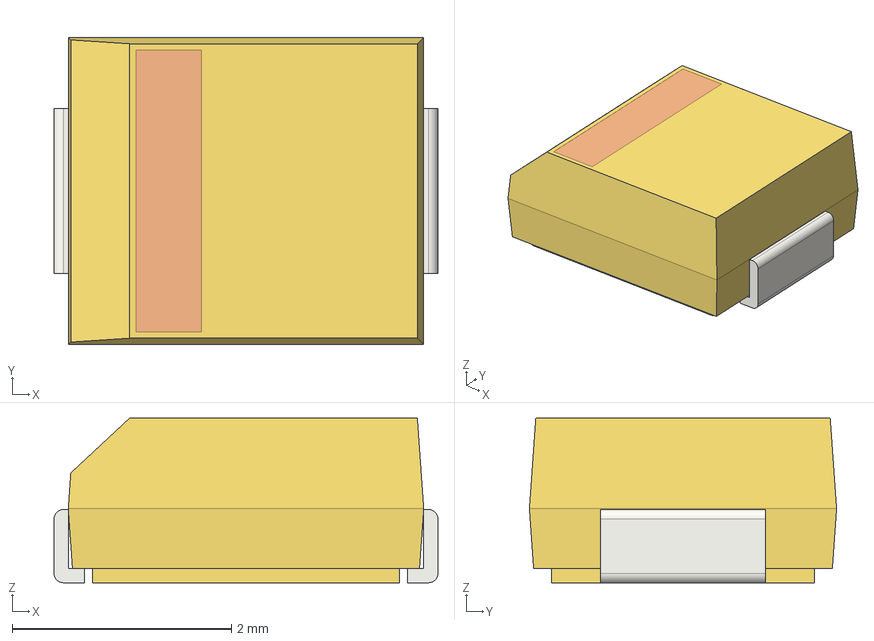
[picture p60: CAD file, 2025-06-12]
bac-hardware/resources/kicad-libraries/micromod-mainboard-v1/3d/bac-C-1411.step
3.50 x 2.80 x 1.50 mm
