Dodokamel2005/EPS-/bac-hardware/resources/kicad-libraries/eps-v1/3d/AMP-MDT350M01001VT.step

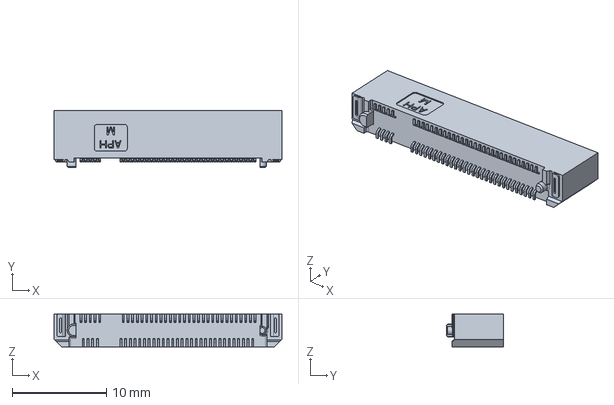
[picture p61: CAD file, 2025-06-12]
bac-hardware/resources/kicad-libraries/eps-v1/3d/AMP-MDT350M01001VT.step
24.2 x 6.10 x 3.50 mm
