Dodokamel2005/EPS-/bac-hardware/resources/kicad-libraries/micromod-mainboard-v1/3d/MT-MCP251863T-H-9PX.step

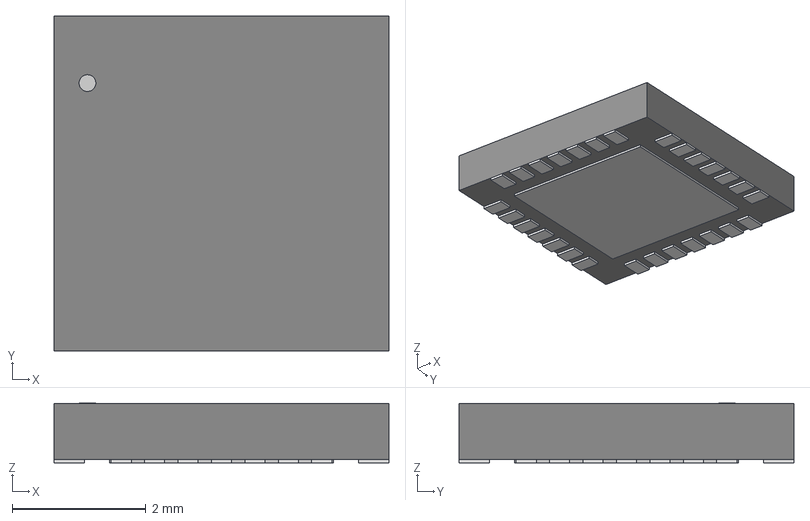
[picture p62: CAD file, 2025-06-12]
bac-hardware/resources/kicad-libraries/micromod-mainboard-v1/3d/MT-MCP251863T-H-9PX.step
5.00 x 5.00 x 0.892 mm
