Dodokamel2005/EPS-/bac-hardware/resources/kicad-libraries/eps-v1/3d/TI-TPS1HB08AQPWPRQ1.step

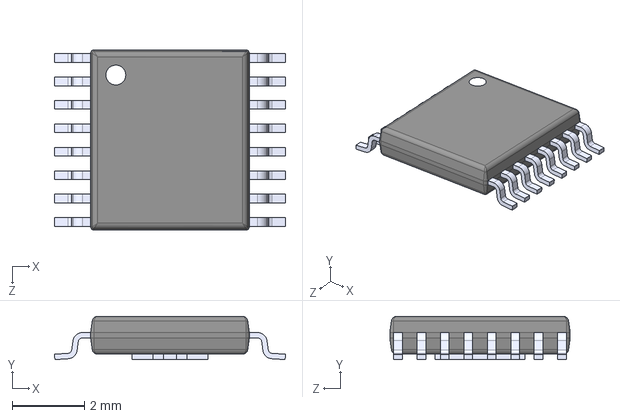
[picture p63: CAD file, 2025-06-12]
bac-hardware/resources/kicad-libraries/eps-v1/3d/TI-TPS1HB08AQPWPRQ1.step
6.40 x 1.20 x 5.00 mm
