Dodokamel2005/EPS-/bac-hardware/resources/kicad-libraries/micromod-mainboard-v1/3d/TI-TCAL9538RSVR.step

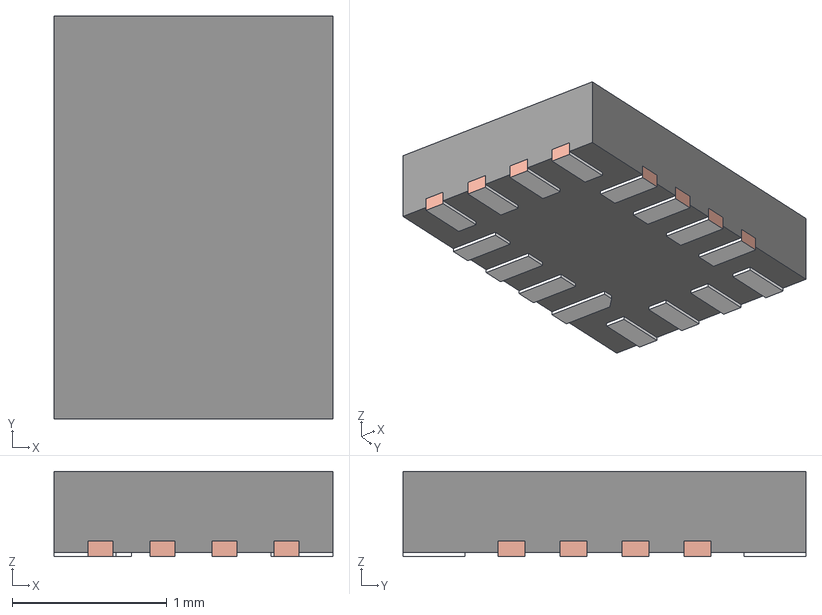
[picture p64: CAD file, 2025-06-12]
bac-hardware/resources/kicad-libraries/micromod-mainboard-v1/3d/TI-TCAL9538RSVR.step
1.80 x 2.60 x 0.55 mm
BODY-SON1
FRAME-RSV0016A
