Dodokamel2005/EPS-/bac-hardware/eps/battery-contact/18650-2s2p/kicad8/bac-eps-battery-contact-18650-2s2p-v1.kicad_pcb

## KiCad design bac-hardware/eps/battery-contact/18650-2s2p/kicad8/bac-eps-battery-contact-18650-2s2p-v1.kicad_pcb (2025-06-12)

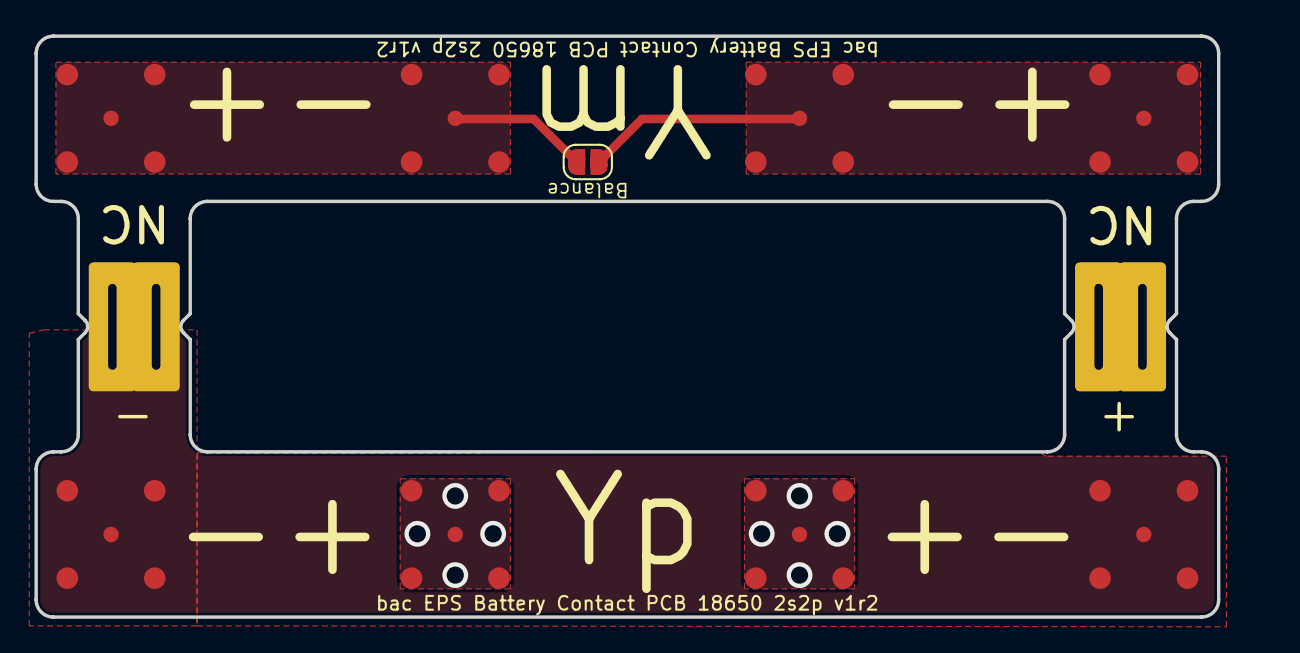
[picture p65: board bac-eps-battery-contact-18650-2s2p-v1.kicad_pcb from above]

Board: 2 copper layers, 71.4 x 33.8 mm, 11 parts (0 on the bottom side), 4 nets.

Parts:
J1, J2: EPS_Conn; bac-eps-v1-battery-contact-pin-panelized
J5, J6, J7, J8, J9, J10, J11, J12: Contact_Dome; Snaptron-FB07
JP1: SolderJumper_2_Open; SolderJumper-2_P1.3mm_Open_RoundedPad1.0x1.5mm

Connections:
+BATT: J2.1, J6.1, J7.1
-BATT: J1.1, J5.1, J8.1
/BAL1: J9.1, J10.1, JP1.1 (A)
/BAL2: J11.1, J12.1, JP1.2 (B)
