Dodokamel2005/EPS-/bac-hardware/eps/eps-main-board/full/design/bac-eps-botch-v1.kicad_pcb

## KiCad design bac-hardware/eps/eps-main-board/full/design/bac-eps-botch-v1.kicad_pcb (2025-06-12)

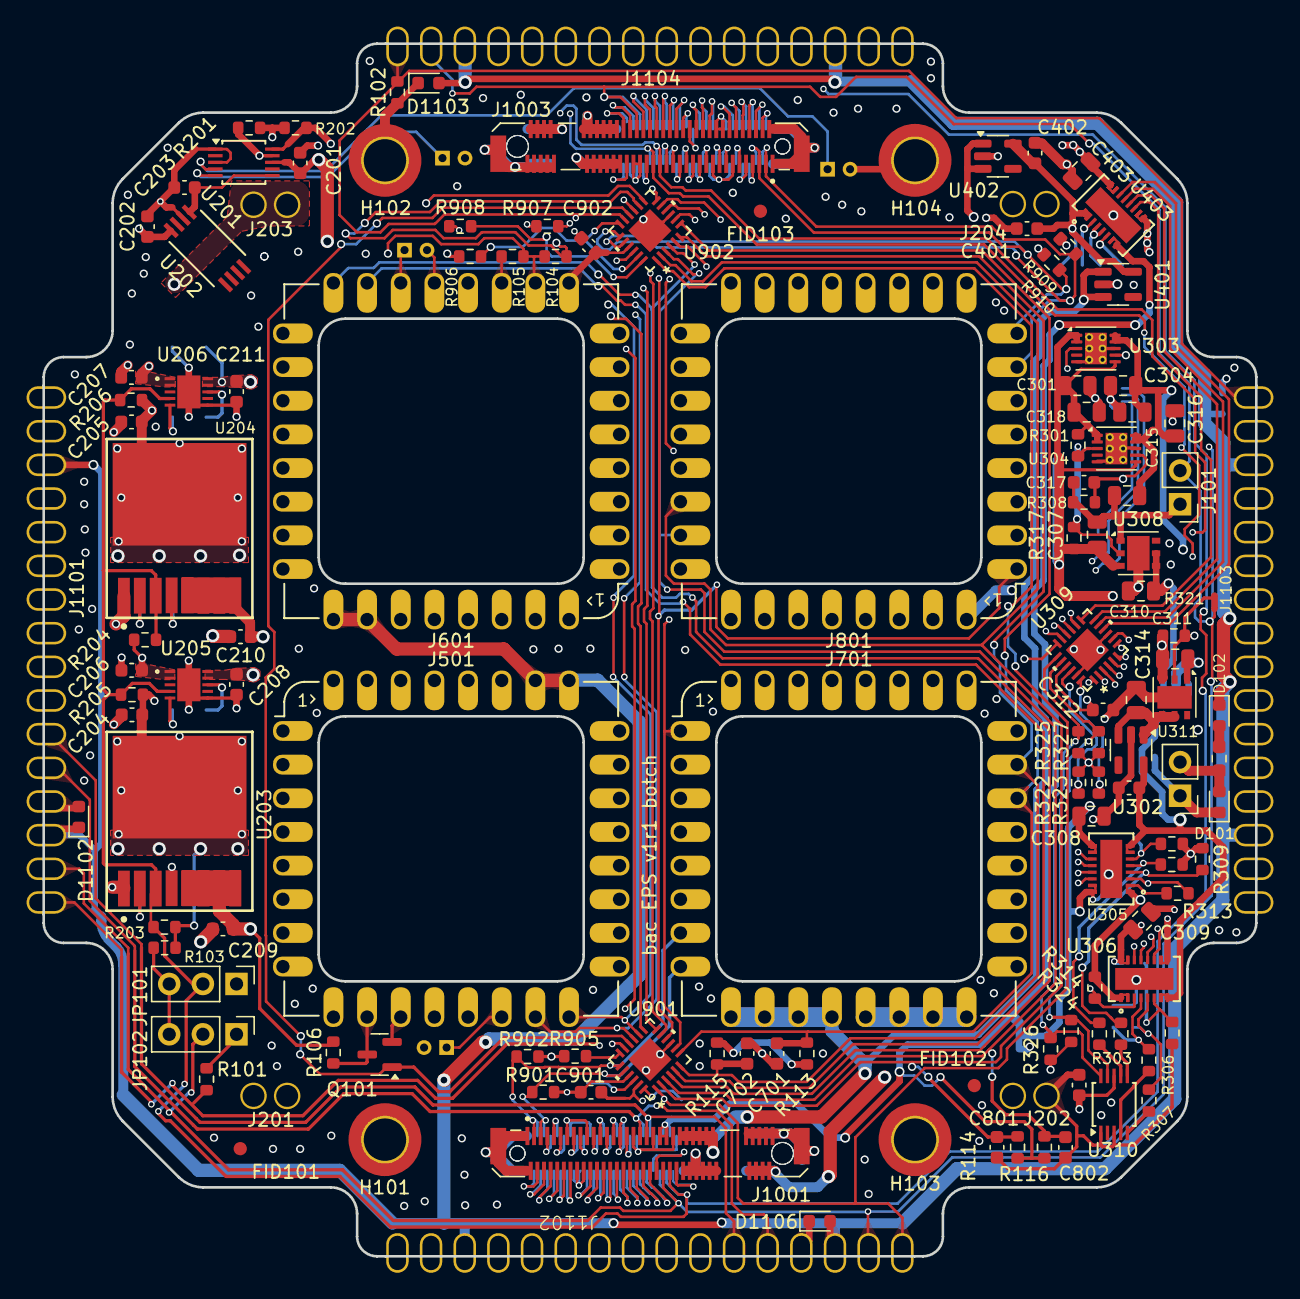
[picture p66: board bac-eps-botch-v1.kicad_pcb from above]

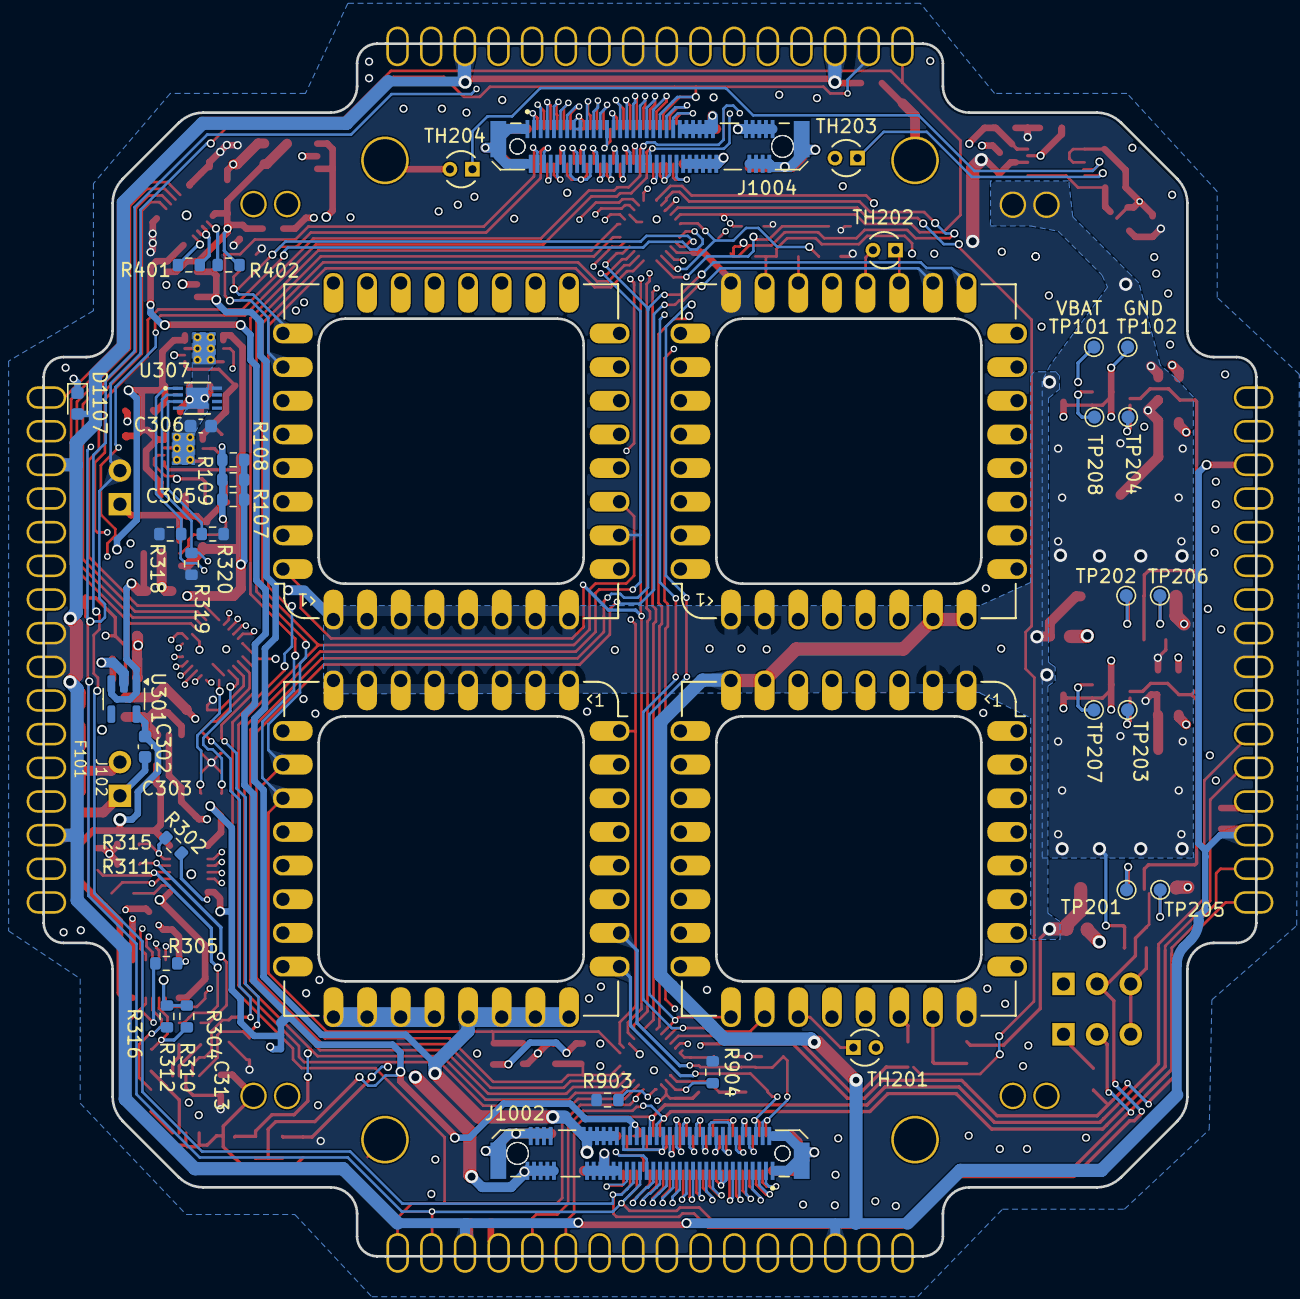
[picture p67: board bac-eps-botch-v1.kicad_pcb from below]

Board: 4 copper layers, 91.5 x 91.5 mm, 174 parts (36 on the bottom side), 157 nets.

Parts:
C201, C202, C203, C204, C205, C206, C207, C208, C209, C210, C211, C302, C303, C306, C312, C313, C317, C401, C402, C701, C702, C801, C802, C901, C902: 1u; C_0603_1608Metric
C301, C304, C305, C307, C308, C309, C310, C311, C314, C315, C316, C318, C403: 10u; C_0805_2012Metric
D101, D1102, D1103, D1106, D1107: PGB1010603MR; D_0603_1608Metric
D102: NSR20F40NXT5G; D_0603_1608Metric
F101: 0438006.WRA; R_0603_1608Metric_Pad0.98x0.95mm_HandSolder
FID101, FID102, FID103: Fiducial; Fiducial_1mm_Mask2mm
H101, H102, H103, H104: MountingHole_Pad; MountingHole_3.2mm_M3_ISO14580_Pad_TopOnly
J101, J102: Conn_01x02; PinHeader_1x02_P2.54mm_Vertical
J201, J202, J203, J204: Conn_01x02_Pin; Mill-Max-0630-0-15-15-30-27-10-0-PN-1x02-P2.54
J501, J601, J701, J801: bac-eps-v1-module-landing-pad
J1001, J1002: AMP MDT350M01001VT; AMP-MDT350M01001VT
J1003, J1004: BMP MDT350M01001VT; AMP-MDT350M01001VT
J1101, J1102, J1103, J1104: Panel Connector 1x16; Mill-Max-0630-0-15-15-30-27-10-0-SE-1x16-P2.54
JP101, JP102: Jumper_3_Open; PinHeader_1x03_P2.54mm_Vertical
NT101, NT301, NT302, NT401, NT402: NetTie_2; NetTie-2_SMD_Pad0.5mm
NT303, NT304: NetTie_3_Tee; NetTie-3_SMD_Pad0.5mm
Q101: DMN62D0U-7; SOT-23
R101, R102, R105, R107, R108, R109, R113, R114, R115, R116, R203, R204, R205, R206, R301, R302, R303, R304, R306, R307, R313, R314, R315, R316, R317, R321, R401, R402: 100k; R_0603_1608Metric
R103, R201, R202, R318, R319, R320, R322, R323, R324, R325, R326, R327, R901, R902, R903, R904, R905, R906, R907, R908, R909, R910: 10k; R_0603_1608Metric
R104, R106, R305: 47k; R_0603_1608Metric
R308: 16k; R_0603_1608Metric
R309, R310, R311, R312: 2k; R_0603_1608Metric
TH201, TH202, TH203, TH204: NTC 10k; Cantherm-MF52A1103F3380
TP101, TP102, TP201, TP202, TP203, TP204, TP205, TP206, TP207, TP208: TestPoint; TestPoint_Pad_D1.0mm
U201, U310: ADS1015IRUGR; TSSOP-10_3x3mm_P0.5mm
U202: ACS37612LLUATR-015B5; AL-ACS37612LLUATR-010B3
U203, U204: BTS50005-1LUA; INF-BTS50005-1LUA
U205, U206: SIPQ32434BDN-T1E3; VIS-SIPQ32434BDN-T1E3
U301, U302, U401, U402: MAX40200AUK; SOT-23-5
U303, U304: LT3045MPDD; ADI-LT3045MPDD
U305, U306, U403: LTC4415EDHC; ADI-LTC4415EDHC
U307: PCT2075TP; NXP-PCT2075TP,147
U308, U311: LDO40LPU33RY
U309, U901, U902: TCAL9539RTWR; TI-TCAL9539RTWR

Connections:
+3V3_OR: C201.2, C202.2, C306.2, C312.2, C313.2, C403.1, C901.2, C902.2, J501.24, J601.24, J1101.8, J1101.9, J1102.8, J1102.9, J1103.8, J1103.9, J1104.8, J1104.9, NT401.1, NT402.2, R201.1, R202.1, R318.1, R319.1, R320.1, R322.1, R323.1, R324.1, R325.1, R326.1, R327.1, R901.1, R902.1, R903.1, R904.1, R905.1, R906.1, R907.1, R908.1, R909.1, R910.1, U201.8 (VDD), U202.4 (VCC), U307.8 (VCC), U309.21 (VCC), U310.8 (VDD), U901.21 (VCC), U902.21 (VCC)
+12V: D101.2 (A2), F101.1, J102.2
+BATT: C204.2, C205.2, C206.2, C207.2, J203.1, J203.2, R103.1, R203.2, R204.2, R205.2, R206.2, U203.EPAD (VS), U204.EPAD (VS), U205.1 (VIN), U205.2 (VIN), U206.1 (VIN), U206.2 (VIN)
/+3V3_AUX/EN_SYS: J1001.41, J1001.43, J1002.42, J1002.44, J1003.41, J1003.43, J1004.42, J1004.44, NT303.3, R113.1, R114.1, R115.1, R116.1, U403.7 (IN2), U403.8 (IN2)
/+3V3_MAIN_A: J701.21, J701.22, J701.23, J701.24, J1001.47, J1001.49, J1001.51, J1001.53, J1001.55, J1001.57, J1002.48, J1002.50, J1002.52, J1002.54, J1002.56, J1002.58, U401.1 (VDD), U401.3 (EN)
/+3V3_MAIN_B: J801.21, J801.22, J801.23, J801.24, J1003.47, J1003.49, J1003.51, J1003.53, J1003.55, J1003.57, J1004.48, J1004.50, J1004.52, J1004.54, J1004.56, J1004.58, U402.1 (VDD), U402.3 (EN)
/+5V_MAIN_A: J701.17, J701.18, J701.19, J701.20, J1001.68, J1001.70, J1001.72, J1001.74, J1002.67, J1002.69, J1002.71, J1002.73, J1002.75
/+5V_MAIN_B: J801.17, J801.18, J801.19, J801.20, J1003.68, J1003.70, J1003.72, J1003.74, J1004.67, J1004.69, J1004.71, J1004.73, J1004.75
/BAT_NTC_A: J501.19, TH201.1
/BAT_NTC_B: J601.19, TH202.1
/BCHG_A_OVR: Q101.1 (G), U901.16, U902.16
/BCHG_A_~CHRG: J501.18, U901.15, U902.15
/BCHG_A_~FAULT: J501.17, R104.2, U901.14, U902.14
/BCHG_B_OVR: J601.23, R104.1, R105.2, U901.13, U902.13
/BCHG_B_~CHRG: J601.18, U901.5, U902.5
/BCHG_B_~FAULT: J601.17, U901.4, U902.4
/Battery Charger Module A/EN: J501.23, Q101.3 (D), R106.1
/Battery Pack/IMON: C203.2, U201.6 (AIN2), U202.1 (VOUT)
/Battery Pack/NTC_3: TH203.1, U201.5 (AIN1)
/Battery Pack/NTC_4: TH204.1, U201.4 (AIN0)
/DEPLOY_1: J1001.44, J1002.43, J1003.44, J1004.43, JP101.2 (C), R203.1, R204.1, R205.1, R206.1, U203.3 (EN), U204.3 (EN), U205.4 (EN/UVLO), U206.4 (EN/UVLO)
/DEPLOY_2/RBF: J101.2, J1001.42, J1002.41, J1003.42, J1004.41, J1101.2, J1102.2, J1103.2, J1104.2, JP102.2 (C), NT101.1
/EN_LDO: NT101.2, R107.1, R108.1, R109.1, R301.2, R317.1, R321.1, U303.3 (EN/UV), U304.3 (EN/UV), U308.2 (EN), U311.2 (EN)
/EPS Power Path/OR_OUT_1: NT401.2, U403.15 (OUT1), U403.16 (OUT1)
/EPS Power Path/OR_OUT_2: NT402.1, U403.9 (OUT2), U403.10 (OUT2)
/EPS_OVR_AUX: R401.2, U403.6 (~EN2), U901.12, U902.12
/EPS_OVR_MAIN: R402.1, U403.3 (EN1), U901.11, U902.11
/I2C Expanders/I2C_INT_A: R904.2, U901.22 (*INT)
/I2C Expanders/I2C_INT_B: R907.2, U902.22 (*INT)
/I2C Expanders/I2C_RST_A: R903.2, U901.24 (*RESET)
/I2C Expanders/I2C_RST_B: R908.2, U902.24 (*RESET)
/LDOs/+3V3_LDO_1: NT304.3, R313.2, R314.2, U305.1 (IN1), U305.2 (IN1), U306.1 (IN1), U306.2 (IN1)
/LDOs/+3V3_LDO_1A: C304.1, C315.1, NT304.1, U303.9 (OUTS), U303.10 (OUT)
/LDOs/+3V3_LDO_1B: C305.1, C316.1, NT304.2, U304.9 (OUTS), U304.10 (OUT)
/LDOs/+3V3_LDO_2: C310.1, U301.1 (VDD), U301.3 (EN), U308.4 (VOUT), U308.5 (SENSE)
/LDOs/+3V3_LDO_3: C314.1, U302.1 (VDD), U302.3 (EN), U311.4 (VOUT), U311.5 (SENSE)
/LDOs/I2C_INT: R322.2, U309.22 (*INT)
/LDOs/I2C_RST: R323.2, U309.24 (*RESET)
/LDOs/OR_A_EN_1: R313.1, U305.3 (EN1), U309.15
/LDOs/OR_A_IMON_1: R303.1, U310.6 (AIN2)
/LDOs/OR_A_IMON_2: R304.1, U310.7 (AIN3)
/LDOs/OR_A_OUT_1: NT302.2, R302.1, U305.15 (OUT1), U305.16 (OUT1)
/LDOs/OR_A_OUT_2: C308.1, NT302.1, NT303.2, U305.9 (OUT2), U305.10 (OUT2)
/LDOs/OR_A_STAT_1: U305.14 (~STAT1), U309.4
/LDOs/OR_A_STAT_2: U305.12 (~WARN2), U309.2
/LDOs/OR_A_WARN_1: U305.13 (~WARN1), U309.3
/LDOs/OR_A_WARN_2: U305.11 (~STAT2), U309.1
/LDOs/OR_A_~EN_2: R302.2, R315.2, U305.6 (~EN2), U309.14
/LDOs/OR_B_EN_1: R314.1, U306.3 (EN1), U309.17
/LDOs/OR_B_IMON_1: R306.1, U310.4 (AIN0)
/LDOs/OR_B_IMON_2: R307.1, U310.5 (AIN1)
/LDOs/OR_B_OUT_1: NT301.2, R305.1, U306.15 (OUT1), U306.16 (OUT1)
/LDOs/OR_B_OUT_2: C309.1, NT301.1, NT303.1, U306.9 (OUT2), U306.10 (OUT2)
/LDOs/OR_B_STAT_1: U306.14 (~STAT1), U309.8
/LDOs/OR_B_STAT_2: U306.12 (~WARN2), U309.6
/LDOs/OR_B_WARN_1: U306.13 (~WARN1), U309.7
/LDOs/OR_B_WARN_2: U306.11 (~STAT2), U309.5
/LDOs/OR_B_~EN_2: R305.2, R316.2, U306.6 (~EN2), U309.16
/MAMOD_A_CAN_1_N: J1001.17, J1002.18
/MAMOD_A_CAN_1_P: J1001.15, J1002.16
/MAMOD_A_I2C_1_SCL: J701.26, J1001.3, J1002.4, R319.2, R325.2, R326.2, R902.2, U307.2 (SCL), U309.19 (SCL), U310.10 (SCL), U901.19 (SCL)
/MAMOD_A_I2C_1_SDA: J701.25, J1001.5, J1002.6, R318.2, R324.2, R327.2, R901.2, U307.1 (SDA), U309.20 (SDA), U310.9 (SDA), U901.20 (SDA)
/MAMOD_A_I2C_2_SCL: J1001.35, J1002.36, J1101.5, J1102.5
/MAMOD_A_I2C_2_SDA: J1001.37, J1002.38, J1101.6, J1102.6
/MAMOD_B_CAN_1_N: J1003.17, J1004.18
/MAMOD_B_CAN_1_P: J1003.15, J1004.16
/MAMOD_B_I2C_1_SCL: J801.26, J1003.3, J1004.4, R202.2, R909.2, U201.10 (SCL), U902.19 (SCL)
/MAMOD_B_I2C_1_SDA: J801.25, J1003.5, J1004.6, R201.2, R910.2, U201.9 (SDA), U902.20 (SDA)
/MAMOD_B_I2C_2_SCL: J1003.35, J1004.36, J1103.5, J1104.5
/MAMOD_B_I2C_2_SDA: J1003.37, J1004.38, J1103.6, J1104.6
/MacroMod Connectors/3A: J1001.4, J1002.3
/MacroMod Connectors/3B: J1003.4, J1004.3
/MacroMod Connectors/5A: J1001.6, J1002.5
/MacroMod Connectors/5B: J1003.6, J1004.5
/MacroMod Connectors/7A: J1001.8, J1002.7
/MacroMod Connectors/7B: J1003.8, J1004.7
/MacroMod Connectors/9A: J1001.10, J1002.9
/MacroMod Connectors/9B: J1003.10, J1004.9
/MacroMod Connectors/10A: J1001.9, J1002.10
/MacroMod Connectors/10B: J1003.9, J1004.10
/MacroMod Connectors/11A: J1001.12, J1002.11
/MacroMod Connectors/11B: J1003.12, J1004.11
/MacroMod Connectors/12A: J1001.11, J1002.12
/MacroMod Connectors/12B: J1003.11, J1004.12
/MacroMod Connectors/13A: J1001.14, J1002.13
/MacroMod Connectors/13B: J1003.14, J1004.13
/MacroMod Connectors/19A: J1001.20, J1002.19
/MacroMod Connectors/19B: J1003.20, J1004.19
/MacroMod Connectors/21A: J1001.22, J1002.21
/MacroMod Connectors/21B: J1003.22, J1004.21
/MacroMod Connectors/22A: J1001.21, J1002.22
/MacroMod Connectors/22B: J1003.21, J1004.22
/MacroMod Connectors/23A: J1001.24, J1002.23
/MacroMod Connectors/23B: J1003.24, J1004.23
/MacroMod Connectors/24A: J1001.23, J1002.24
/MacroMod Connectors/24B: J1003.23, J1004.24
/MacroMod Connectors/25A: J1001.26, J1002.25
/MacroMod Connectors/25B: J1003.26, J1004.25
/MacroMod Connectors/26A: J1001.25, J1002.26
/MacroMod Connectors/26B: J1003.25, J1004.26
/MacroMod Connectors/27A: J1001.28, J1002.27
/MacroMod Connectors/27B: J1003.28, J1004.27
/MacroMod Connectors/28A: J1001.27, J1002.28
/MacroMod Connectors/28B: J1003.27, J1004.28
/MacroMod Connectors/29A: J1001.30, J1002.29
/MacroMod Connectors/29B: J1003.30, J1004.29
/MacroMod Connectors/30A: J1001.29, J1002.30
/MacroMod Connectors/30B: J1003.29, J1004.30
/MacroMod Connectors/31A: J1001.32, J1002.31
/MacroMod Connectors/31B: J1003.32, J1004.31
/MacroMod Connectors/32A: J1001.31, J1002.32
/MacroMod Connectors/32B: J1003.31, J1004.32
/MacroMod Connectors/33A: J1001.34, J1002.33
/MacroMod Connectors/33B: J1003.34, J1004.33
/MacroMod Connectors/35A: J1001.36, J1002.35
/MacroMod Connectors/35B: J1003.36, J1004.35
/MacroMod Connectors/37A: J1001.38, J1002.37
/MacroMod Connectors/37B: J1003.38, J1004.37
/MacroMod Connectors/39A: J1001.40, J1002.39
/MacroMod Connectors/39B: J1003.40, J1004.39
/MacroMod Connectors/45A: J1001.46, J1002.45
/MacroMod Connectors/45B: J1003.46, J1004.45
/PANEL_m_EN: J1101.1, J1102.1, R101.2, U901.1, U902.1
/PANEL_p_EN: J1103.1, J1104.1, R102.2, U901.17, U902.17
/REG_A_OVR_1: C702.2, J701.10, R115.2, U901.6, U902.6
/REG_A_OVR_2: C701.2, J701.11, R113.2, U901.7, U902.7
/REG_A_~FAULT: J701.32, U901.8, U902.8
/REG_B_OVR_1: C802.2, J801.10, R116.2, U901.3, U902.3
/REG_B_OVR_2: C801.2, J801.11, R114.2, U901.2, U902.2
/REG_B_~FAULT: J801.32, U901.10, U902.10
/VBAT: C208.2, C209.2, C210.2, C211.2, C301.1, C307.1, C311.1, C318.1, J501.1, J501.2, J601.1, J601.2, J701.1, J701.2, J701.3, J701.4, J701.5, J701.6, J701.7, J701.8, J801.1, J801.2, J801.3, J801.4, J801.5, J801.6, J801.7, J801.8, R106.2, R107.2, R108.2, R109.2, R301.1, R317.2, R321.2, TP101.1, U203.5 (OUT), U203.6 (OUT), U203.7 (OUT), U203.8 (OUT), U204.5 (OUT), U204.6 (OUT), U204.7 (OUT), U204.8 (OUT), U205.9 (VOUT), U205.10 (VOUT), U206.9 (VOUT), U206.10 (VOUT), U303.1 (IN), U303.2 (IN), U303.6 (PGFB), U304.1 (IN), U304.2 (IN), U304.6 (PGFB), U308.3 (VIN), U311.3 (VIN)
/VPV: D102.1 (K), D1102.1 (A1), D1103.2 (A2), D1106.2 (A2), D1107.2 (A2), J501.7, J501.8, J601.7, J601.8, J1101.3, J1101.14, J1102.3, J1102.14, J1103.3, J1103.14, J1104.3, J1104.14
GND: C201.1, C202.1, C203.1, C204.1, C205.1, C206.1, C207.1, C208.1, C209.1, C210.1, C211.1, C301.2, C302.1, C303.1, C304.2, C305.2, C306.1, C307.2, C308.2, C309.2, C310.2, C311.2, C312.1, C313.1, C314.2, C315.2, C316.2, C317.1, C318.2, C401.1, C402.1, C403.2, C701.1, C702.1, C801.1, C802.1, C901.1, C902.1, D101.1 (A1), D1102.2 (A2), D1103.1 (A1), D1106.1 (A1), D1107.1 (A1), H101.1, H102.1, H103.1, H104.1, J101.1, J102.1, J201.1, J201.2, J202.1, J202.2, J204.1, J204.2, J501.3, J501.4, J501.5, J501.6, J501.9, J501.10, J501.11, J501.12, J501.13, J501.14, J501.15, J501.16, J501.20, J501.21, J501.22, J501.25, J501.26, J501.27, J501.28, J501.29, J501.30, J501.31, J501.32, J601.3, J601.4, J601.5, J601.6, J601.9, J601.10, J601.11, J601.12, J601.13, J601.14, J601.15, J601.16, J601.20, J601.21, J601.22, J601.25, J601.26, J601.27, J601.28, J601.29, J601.30, J601.31, J601.32, J701.12, J701.13, J701.14, J701.15, J701.16, J701.27, J701.28, J701.29, J801.12, J801.13, J801.14, J801.15, J801.16, J801.27, J801.28, J801.29, J1001.1, J1001.2, J1001.7, J1001.13, J1001.16, J1001.18, J1001.19, J1001.33, J1001.39, J1001.45, J1001.48, J1001.50, J1001.52, J1001.54, J1001.56, J1001.58, J1001.67, J1001.69, J1001.71, J1001.73, J1001.75, J1001.S1 (SHIELD), J1001.S2 (SHIELD__1), J1002.1, J1002.2, J1002.8, J1002.14, J1002.15, J1002.17, J1002.20, J1002.34, J1002.40, J1002.46, J1002.47, J1002.49, J1002.51, J1002.53, J1002.55, J1002.57, J1002.68, J1002.70, J1002.72, J1002.74, J1002.S1 (SHIELD), J1002.S2 (SHIELD__1), J1003.1, J1003.2, J1003.7, J1003.13, J1003.16, J1003.18, J1003.19, J1003.33, J1003.39, J1003.45, J1003.48, J1003.50, J1003.52, J1003.54, J1003.56, J1003.58, J1003.67, J1003.69, J1003.71, J1003.73, J1003.75, J1003.S1 (SHIELD), J1003.S2 (SHIELD__1), J1004.1, J1004.2, J1004.8, J1004.14, J1004.15, J1004.17, J1004.20, J1004.34, J1004.40, J1004.46, J1004.47, J1004.49, J1004.51, J1004.53, J1004.55, J1004.57, J1004.68, J1004.70, J1004.72, J1004.74, J1004.S1 (SHIELD), J1004.S2 (SHIELD__1), J1101.4, J1101.7, J1101.10, J1101.13, J1102.4, J1102.7, J1102.10, J1102.13, J1103.4, J1103.7, J1103.10, J1103.13, J1104.4, J1104.7, J1104.10, J1104.13, JP101.1 (A), JP102.1 (A), Q101.2 (S), R101.1, R102.1, R105.1, R308.2, R309.1, R310.1, R311.1, R312.1, R315.1, R316.1, R401.1, TH201.2, TH202.2, TH203.2, TH204.2, TP102.1, U201.1 (ADDR), U201.3 (GND), U202.2 (GND), U203.1 (GND), U204.1 (GND), U205.6 (GND), U205.11 (GND), U206.6 (GND), U206.11 (GND), U301.2 (GND), U302.2 (GND), U303.5 (ILIM), U303.8 (GND), U303.11 (EPAD), U304.5 (ILIM), U304.8 (GND), U304.11 (EPAD), U305.17 (GND), U306.17 (GND), U307.4 (GND), U307.9 (EPAD), U308.1 (GND), U308.7 (EPAD), U309.9 (GND), U309.18 (A0), U309.23 (A1), U309.25 (EPAD), U310.1 (ADDR), U310.3 (GND), U311.1 (GND), U311.7 (EPAD), U401.2 (GND), U402.2 (GND), U403.4 (CLIM1), U403.5 (CLIM2), U403.17 (GND), U901.9 (GND), U901.23 (A1), U901.25 (EPAD), U902.9 (GND), U902.25 (EPAD)
unnamed: D102.2 (A), F101.2
unnamed: JP101.3 (B), JP102.3 (B), R103.2
unnamed: TP205.1, U203.2 (DIAG)
unnamed: TP201.1, U203.4 (DIAG_EN)
unnamed: TP206.1, U204.2 (DIAG)
unnamed: TP202.1, U204.4 (DIAG_EN)
unnamed: TP203.1, U205.5 (ILIM/IMON)
unnamed: TP207.1, U205.8 (PGD)
unnamed: TP204.1, U206.5 (ILIM/IMON)
unnamed: TP208.1, U206.8 (PGD)
unnamed: C302.2, C303.2, U301.5 (OUT), U302.5 (OUT), U305.7 (IN2), U305.8 (IN2), U306.7 (IN2), U306.8 (IN2)
unnamed: C317.2, R308.1, U303.7 (SET), U304.7 (SET)
unnamed: R303.2, R309.2, U305.4 (CLIM1)
unnamed: R304.2, R311.2, U305.5 (CLIM2)
unnamed: R306.2, R310.2, U306.4 (CLIM1)
unnamed: R307.2, R312.2, U306.5 (CLIM2)
unnamed: R320.2, U307.3 (OS)
unnamed: C401.2, C402.2, R402.2, U401.5 (OUT), U402.5 (OUT), U403.1 (IN1), U403.2 (IN1)
unnamed: R905.2, U901.18 (A0)
unnamed: R906.2, U902.18 (A0), U902.23 (A1)
OR_C_STAT_1: U309.10, U403.14 (~STAT1)
OR_C_STAT_2: U309.12, U403.12 (~WARN2)
OR_C_WARN_1: U309.11, U403.13 (~WARN1)
OR_C_WARN_2: U309.13, U403.11 (~STAT2)
