Dodokamel2005/EPS-/bac-hardware/eps/eps-main-board/minimal/design/bac-eps-main-board-minimal-v1.kicad_pcb

## KiCad design bac-hardware/eps/eps-main-board/minimal/design/bac-eps-main-board-minimal-v1.kicad_pcb (2025-06-12)

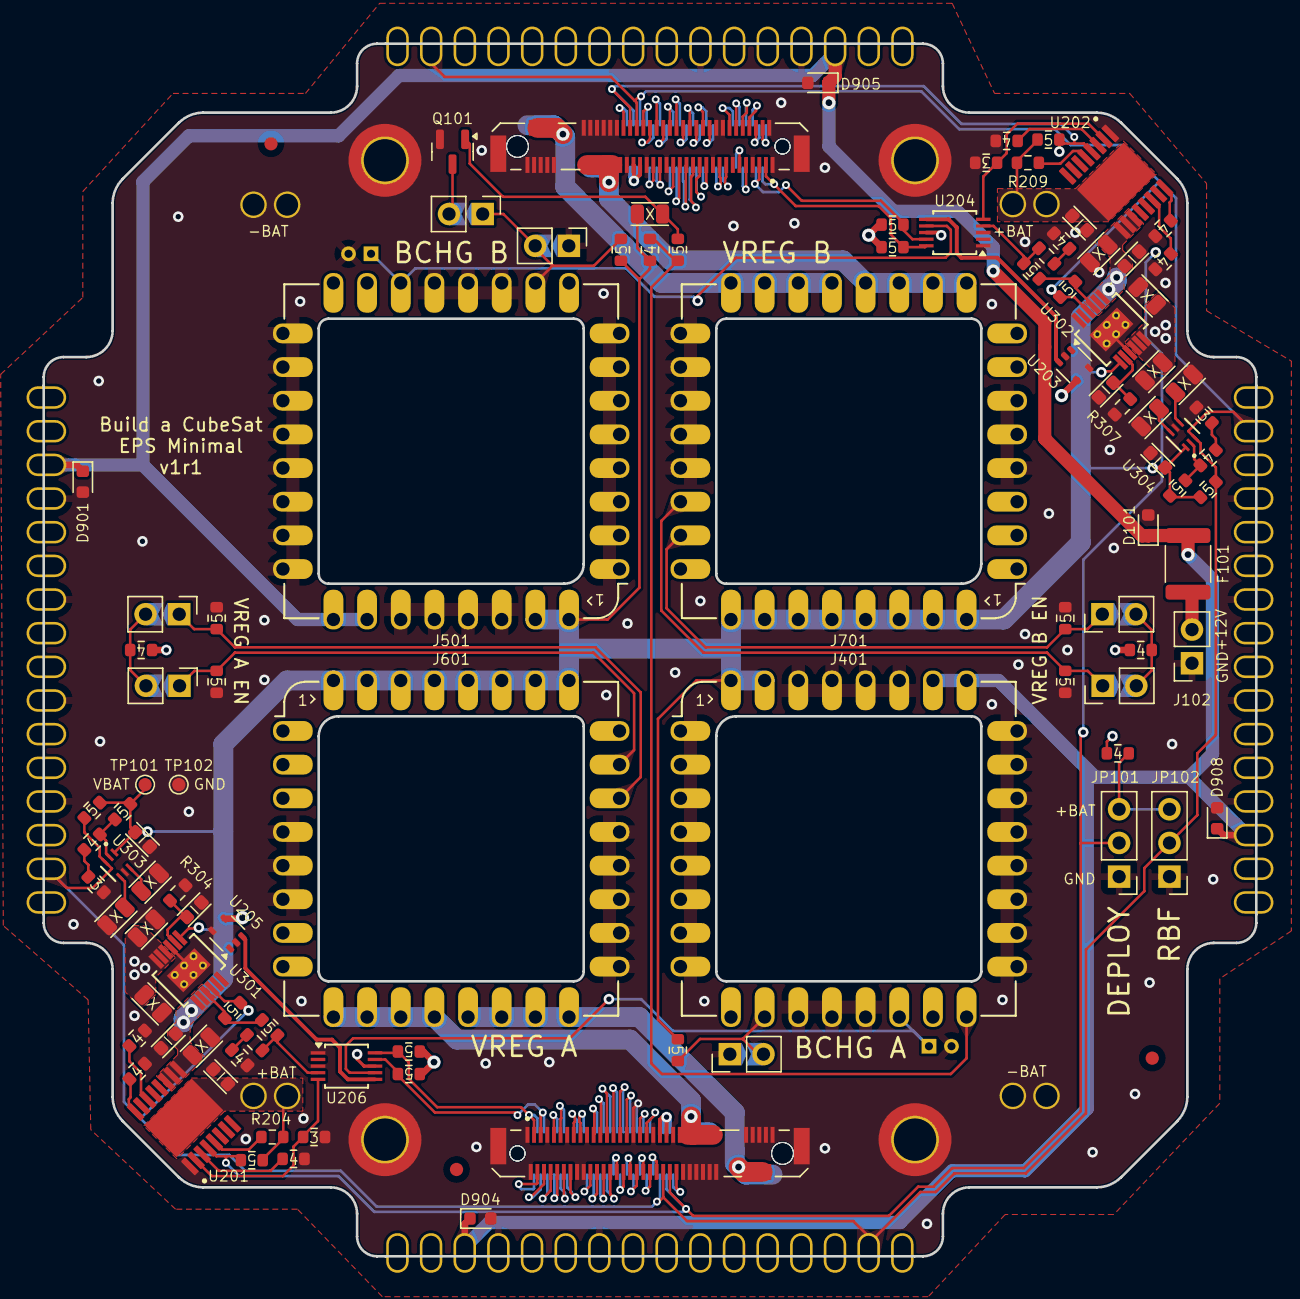
[picture p68: board bac-eps-main-board-minimal-v1.kicad_pcb from above]

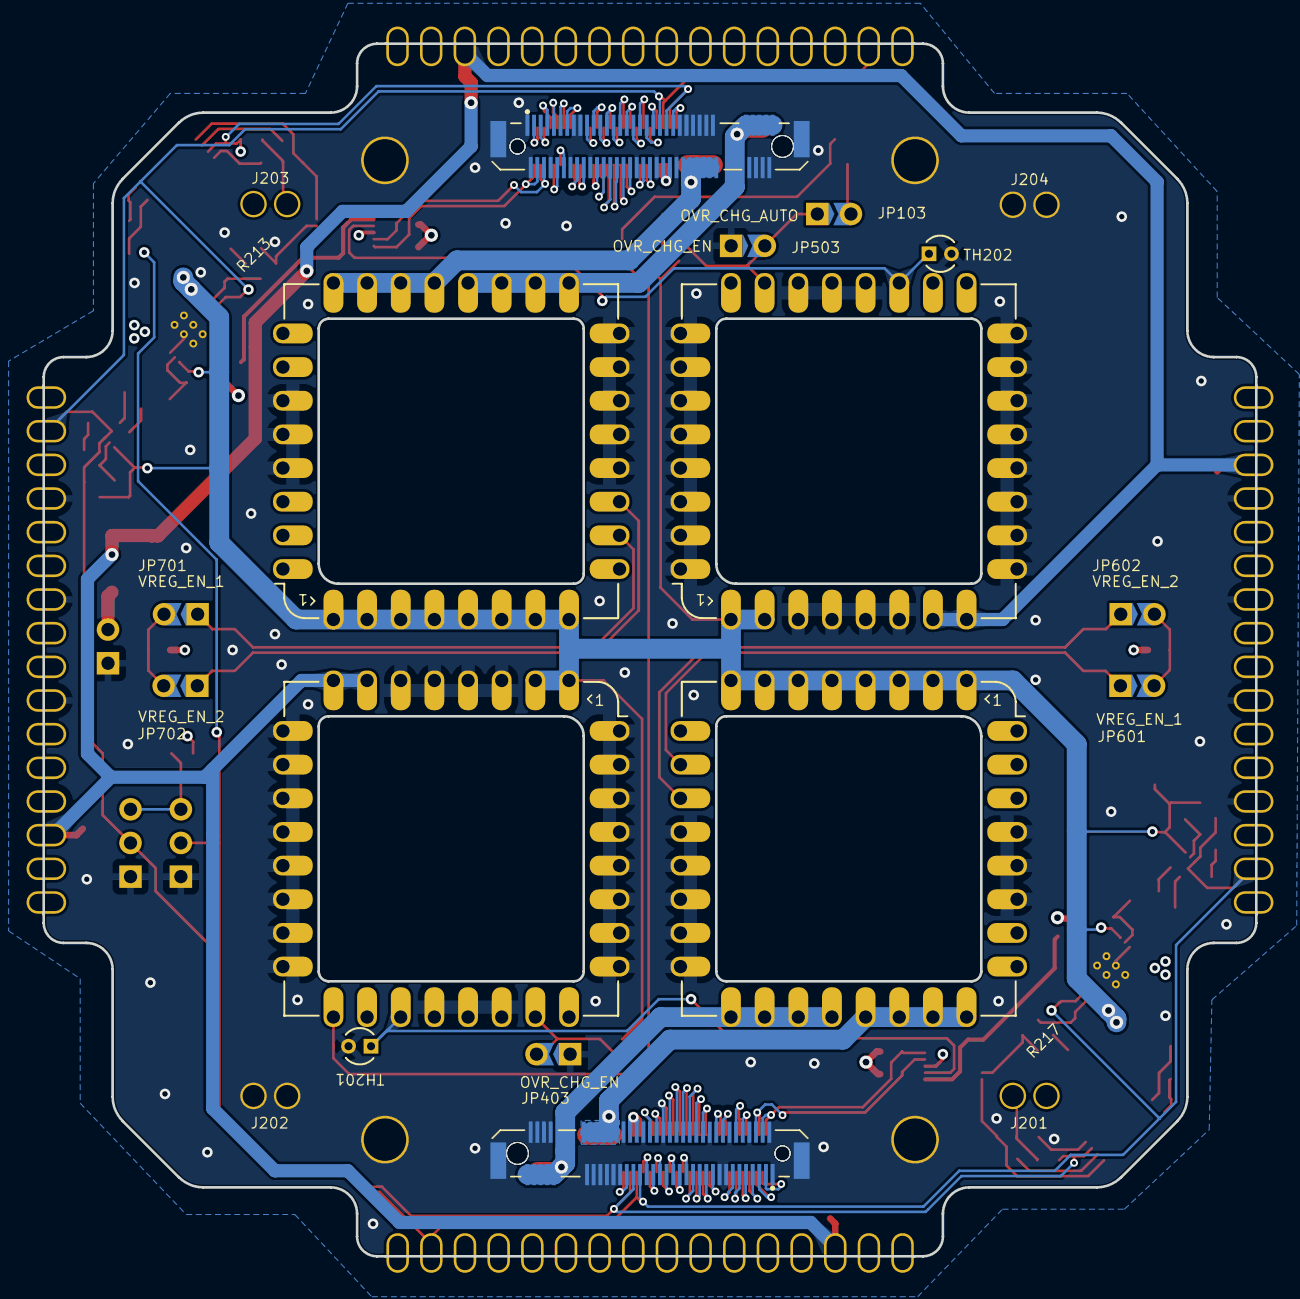
[picture p69: board bac-eps-main-board-minimal-v1.kicad_pcb from below]

Board: 4 copper layers, 91.5 x 91.5 mm, 118 parts (8 on the bottom side), 116 nets.

Parts:
C101, C301, C302, C303, C304, C305, C306, C310, C311, C313, C314: 10u; bac-C-0805-10u
C201, C202, C203, C204, C307, C308, C309, C312: 1u; bac-C-0603-1u
D101, D901, D904, D905, D908: TI ESD751; D_0603_1608Metric
F101: 1812L300/24SLER; Fuse_1812_4532Metric
FID101, FID102, FID103: Fiducial; Fiducial_1mm_Mask2mm
H101, H102, H103, H104: M3; MountingHole_3.2mm_M3_ISO14580_Pad_TopOnly
J102: Conn_01x02; PinSocket_1x02_P2.54mm_Vertical
J201, J202, J203, J204: Conn_01x02_Pin; bac-Mill-Max-0630-0-15-15-30-27-10-0-PN-1x02-P2.54
J401, J501, J601, J701: bac-eps-v1-module-landing-pad
J801: AMP MDT350M01001VT; bac-M.2-Key-M-bacBus-Connector-ReflowSolder
J802: AMP MDT350M01001VT; bac-M.2-Key-M-bacBus-Connector-DragSolder
J803: BMP MDT350M01001VT; bac-M.2-Key-M-bacBus-Connector-ReflowSolder
J804: BMP MDT350M01001VT; bac-M.2-Key-M-bacBus-Connector-DragSolder
J901, J902, J903, J904: Panel Connector 1x16; bac-Mill-Max-0630-0-15-15-30-27-10-0-SE-1x16-P2.54
JP101, JP102: Jumper_3_Open; PinHeader_1x03_P2.54mm_Vertical
JP103: OVR_CHG_AUTO; bac-CombinedJumper-2_P2.54mm_Open_THT
JP403, JP503: OVR_CHG_EN; bac-CombinedJumper-2_P2.54mm_Open_THT
JP601, JP701: VREG_EN_1; bac-CombinedJumper-2_P2.54mm_Open_THT
JP602, JP702: VREG_EN_2; bac-CombinedJumper-2_P2.54mm_Open_THT
Q101: DMN62D0U-7; SOT-23
R102, R104, R112, R211, R212, R215, R218, R219, R220, R221, R222, R301, R302, R303, R305, R309, R310, R601, R602, R701, R702: 100k; bac-R-0603-100k
R103, R105, R106, R107, R201, R202, R203, R206, R207, R208, R214, R216, R306, R311: 10k; bac-R-0603-10k
R204, R209, R213, R217: 16k; R_0603_1608Metric
R205, R210: 3.3k; bac-R-0603-1k
R304, R307: 33.2k; R_0603_1608Metric
R308, R312: 1k; bac-R-0603-1k
TH201, TH202: NTC 10k; Cantherm-MF52A1103F3380
TP101, TP102: TestPoint; TestPoint_Pad_D1.0mm
U201, U202: TI TPS1HB08AQPWPRQ1; TI-TPS1HB08AQPWPRQ1
U203, U205: TMP235A2DCKR; SOT-353_SC-70-5
U204, U206: ADS1115IDGS; TSSOP-10_3x3mm_P0.5mm
U301, U302: ADI LT3045HMSE; ADI-LT3045HMSE
U303, U304: TPS3842A650DRLRQ1; TI-TPS3842

Connections:
+3V3: C302.1, C303.1, C305.1, C306.1, J401.24, J501.24, J601.9, J701.9, J801.41, J801.43, J802.42, J802.44, J803.41, J803.43, J804.42, J804.44, J901.8, J901.9, J902.8, J902.9, J903.8, J903.9, J904.8, J904.9, R106.1, R107.1, R219.1, R220.1, R221.1, R222.1, U203.4 (V_{DD}), U204.8 (VDD), U205.4 (V_{DD}), U206.8 (VDD), U301.10 (OUTS), U301.11 (OUT), U301.12 (OUT), U302.10 (OUTS), U302.11 (OUT), U302.12 (OUT)
+12V: F101.2, J102.2
+BAT: C201.2, C202.2, J201.1, J201.2, J203.1, J203.2, R103.1, R204.2, R209.2, R211.1, R212.1, U201.17 (VBB), U202.17 (VBB)
/+3V3_MAIN_A: J601.21, J601.22, J601.23, J601.24, J801.47, J801.49, J801.51, J801.53, J801.55, J801.57, J802.48, J802.50, J802.52, J802.54, J802.56, J802.58
/+3V3_MAIN_B: J701.21, J701.22, J701.23, J701.24, J803.47, J803.49, J803.51, J803.53, J803.55, J803.57, J804.48, J804.50, J804.52, J804.54, J804.56, J804.58
/+5V_MAIN_A: J601.17, J601.18, J601.19, J601.20, J801.68, J801.70, J801.72, J801.74, J802.67, J802.69, J802.71, J802.73, J802.75
/+5V_MAIN_B: J701.17, J701.18, J701.19, J701.20, J803.68, J803.70, J803.72, J803.74, J804.67, J804.69, J804.71, J804.73, J804.75
/BACBUS_A_CAN_1_N: J801.15, J802.16
/BACBUS_A_CAN_1_P: J801.17, J802.18
/BACBUS_A_I2C_1_SCL: J801.3, J802.4, R219.2, U206.10 (SCL)
/BACBUS_A_I2C_1_SDA: J801.5, J802.6, R220.2, U206.9 (SDA)
/BACBUS_B_CAN_1_N: J803.15, J804.16
/BACBUS_B_CAN_1_P: J803.17, J804.18
/BACBUS_B_I2C_1_SCL: J803.3, J804.4, R221.2, U204.10 (SCL)
/BACBUS_B_I2C_1_SDA: J803.5, J804.6, R222.2, U204.9 (SDA)
/BAT_NTC_A: J401.19, TH201.1, U206.7 (AIN3)
/BAT_NTC_B: J501.19, TH202.1, U204.7 (AIN3)
/BCHG_A_FAULT: JP103.2 (B), Q101.3 (D)
/Battery Charger Module A/EN: J401.23, JP403.2 (B), R104.2
/Battery Charger Module A/~FAULT: J401.17, R105.2, R112.1
/Battery Charger Module B/EN: J501.23, JP103.1 (A), JP503.2 (B), R102.2
/Battery Pack/VSNS_1: R205.1, U201.2 (SNS), U206.5 (AIN1)
/Battery Pack/VSNS_2: R210.1, U202.2 (SNS), U204.5 (AIN1)
/DEPLOY_1: J801.44, J802.43, J803.44, J804.43, JP101.2 (C), R211.2, R212.2, U201.4 (EN), U202.4 (EN)
/DEPLOY_2/RBF: J801.42, J802.41, J803.42, J804.41, J901.2, J902.2, J903.2, J904.2, JP102.2 (C), R301.1, R302.1, R303.2, R309.2, U301.4 (EN/UB), U302.4 (EN/UB), U303.3 (~RESET), U304.3 (~RESET)
/LDOs/UV_SNS_1: R305.1, R306.2, U303.2 (SENSE)
/LDOs/UV_SNS_2: R310.1, R311.2, U304.2 (SENSE)
/VBAT: C101.1, C203.2, C204.2, C301.1, C304.1, C307.1, C312.1, J401.1, J401.2, J501.1, J501.2, J601.1, J601.2, J601.3, J601.4, J601.5, J601.6, J601.7, J601.8, J701.1, J701.2, J701.3, J701.4, J701.5, J701.6, J701.7, J701.8, R102.1, R104.1, R105.1, R215.1, R218.1, R301.2, R302.2, R303.1, R305.2, R309.1, R310.2, TP101.1, U201.9 (VOUT), U201.10 (VOUT), U201.11 (VOUT), U202.9 (VOUT), U202.10 (VOUT), U202.11 (VOUT), U301.1 (IN), U301.2 (IN), U301.3 (IN), U301.7 (PGFB), U302.1 (IN), U302.2 (IN), U302.3 (IN), U302.7 (PGFB), U303.1 (VDD), U304.1 (VDD)
/VPV: D101.1 (K), D901.1 (K), D904.1 (K), D905.1 (K), D908.1 (K), F101.1, J401.7, J401.8, J501.7, J501.8, J901.14, J902.14, J903.14, J904.14
/Voltage Regulator Module A/EN_1: JP601.2 (B), JP602.2 (B), R106.2
/Voltage Regulator Module B/EN_1: JP701.2 (B), JP702.2 (B), R107.2
/bacBus Connectors/3A: J801.4, J802.3
/bacBus Connectors/3B: J803.4, J804.3
/bacBus Connectors/5A: J801.6, J802.5
/bacBus Connectors/5B: J803.6, J804.5
/bacBus Connectors/7A: J801.8, J802.7
/bacBus Connectors/7B: J803.8, J804.7
/bacBus Connectors/9A: J801.10, J802.9
/bacBus Connectors/9B: J803.10, J804.9
/bacBus Connectors/10A: J801.9, J802.10
/bacBus Connectors/10B: J803.9, J804.10
/bacBus Connectors/11A: J801.12, J802.11
/bacBus Connectors/11B: J803.12, J804.11
/bacBus Connectors/12A: J801.11, J802.12
/bacBus Connectors/12B: J803.11, J804.12
/bacBus Connectors/13A: J801.14, J802.13
/bacBus Connectors/13B: J803.14, J804.13
/bacBus Connectors/19A: J801.20, J802.19
/bacBus Connectors/19B: J803.20, J804.19
/bacBus Connectors/21A: J801.22, J802.21
/bacBus Connectors/21B: J803.22, J804.21
/bacBus Connectors/22A: J801.21, J802.22
/bacBus Connectors/22B: J803.21, J804.22
/bacBus Connectors/23A: J801.24, J802.23
/bacBus Connectors/23B: J803.24, J804.23
/bacBus Connectors/24A: J801.23, J802.24
/bacBus Connectors/24B: J803.23, J804.24
/bacBus Connectors/25A: J801.26, J802.25
/bacBus Connectors/25B: J803.26, J804.25
/bacBus Connectors/26A: J801.25, J802.26
/bacBus Connectors/26B: J803.25, J804.26
/bacBus Connectors/27A: J801.28, J802.27
/bacBus Connectors/27B: J803.28, J804.27
/bacBus Connectors/28A: J801.27, J802.28
/bacBus Connectors/28B: J803.27, J804.28
/bacBus Connectors/29A: J801.30, J802.29
/bacBus Connectors/29B: J803.30, J804.29
/bacBus Connectors/30A: J801.29, J802.30
/bacBus Connectors/30B: J803.29, J804.30
/bacBus Connectors/31A: J801.32, J802.31
/bacBus Connectors/31B: J803.32, J804.31
/bacBus Connectors/32A: J801.31, J802.32
/bacBus Connectors/32B: J803.31, J804.32
/bacBus Connectors/33A: J801.34, J802.33
/bacBus Connectors/33B: J803.34, J804.33
/bacBus Connectors/35A: J801.36, J802.35
/bacBus Connectors/35B: J803.36, J804.35
/bacBus Connectors/36A: J801.35, J802.36
/bacBus Connectors/36B: J803.35, J804.36
/bacBus Connectors/37A: J801.38, J802.37
/bacBus Connectors/37B: J803.38, J804.37
/bacBus Connectors/38A: J801.37, J802.38
/bacBus Connectors/38B: J803.37, J804.38
/bacBus Connectors/39A: J801.40, J802.39
/bacBus Connectors/39B: J803.40, J804.39
/bacBus Connectors/45A: J801.46, J802.45
/bacBus Connectors/45B: J803.46, J804.45
GND: C201.1, C202.1, C203.1, C204.1, C301.2, C302.2, C303.2, C304.2, C305.2, C306.2, C307.2, C308.1, C309.1, C310.2, C311.2, C312.2, C313.2, C314.2, D101.2 (A), D901.2 (A), D904.2 (A), D905.2 (A), D908.2 (A), H101.1, H102.1, H103.1, H104.1, J102.1, J202.1, J202.2, J204.1, J204.2, J401.3, J401.4, J401.5, J401.6, J401.9, J401.10, J401.11, J401.12, J401.13, J401.14, J401.15, J401.16, J401.20, J401.21, J401.22, J401.25, J401.26, J401.27, J401.28, J401.29, J401.30, J401.31, J401.32, J501.3, J501.4, J501.5, J501.6, J501.9, J501.10, J501.11, J501.12, J501.13, J501.14, J501.15, J501.16, J501.20, J501.21, J501.22, J501.25, J501.26, J501.27, J501.28, J501.29, J501.30, J501.31, J501.32, J601.12, J601.13, J601.14, J601.15, J601.16, J601.27, J601.28, J601.29, J701.12, J701.13, J701.14, J701.15, J701.16, J701.27, J701.28, J701.29, J801.1, J801.2, J801.7, J801.13, J801.16, J801.18, J801.19, J801.33, J801.39, J801.45, J801.48, J801.50, J801.52, J801.54, J801.56, J801.58, J801.67, J801.69, J801.71, J801.73, J801.75, J801.S1 (SHIELD), J801.S2 (SHIELD__1), J802.1, J802.2, J802.8, J802.14, J802.15, J802.17, J802.20, J802.34, J802.40, J802.46, J802.47, J802.49, J802.51, J802.53, J802.55, J802.57, J802.68, J802.70, J802.72, J802.74, J802.S1 (SHIELD), J802.S2 (SHIELD__1), J803.1, J803.2, J803.7, J803.13, J803.16, J803.18, J803.19, J803.33, J803.39, J803.45, J803.48, J803.50, J803.52, J803.54, J803.56, J803.58, J803.67, J803.69, J803.71, J803.73, J803.75, J803.S1 (SHIELD), J803.S2 (SHIELD__1), J804.1, J804.2, J804.8, J804.14, J804.15, J804.17, J804.20, J804.34, J804.40, J804.46, J804.47, J804.49, J804.51, J804.53, J804.55, J804.57, J804.68, J804.70, J804.72, J804.74, J804.S1 (SHIELD), J804.S2 (SHIELD__1), J901.4, J901.7, J901.10, J901.13, J902.4, J902.7, J902.10, J902.13, J903.4, J903.7, J903.10, J903.13, J904.4, J904.7, J904.10, J904.13, JP101.1 (A), JP102.1 (A), JP403.1 (A), JP503.1 (A), Q101.2 (S), R201.2, R202.2, R203.2, R205.2, R206.2, R207.2, R208.2, R210.2, R214.2, R216.2, R304.2, R307.2, R308.1, R312.1, R601.2, R602.2, R701.2, R702.2, TH201.2, TH202.2, TP102.1, U201.1 (GND), U202.1 (GND), U203.2 (GND), U203.5 (GND), U204.1 (ADDR), U204.3 (GND), U205.2 (GND), U205.5 (GND), U206.1 (ADDR), U206.3 (GND), U301.6 (ILIM), U301.9 (GND), U301.EPAD (GND), U302.6 (ILIM), U302.9 (GND), U302.EPAD (GND), U303.5 (GND), U304.5 (GND)
unnamed: JP101.3 (B), JP102.3 (B), R103.2
unnamed: J601.10, JP601.1 (A), R601.1
unnamed: J601.11, JP602.1 (A), R602.1
unnamed: J701.10, JP701.1 (A), R701.1
unnamed: J701.11, JP702.1 (A), R702.1
unnamed: C101.2, Q101.1 (G), R112.2
unnamed: R213.2, R214.1
unnamed: R216.1, R217.2
unnamed: R306.1, R308.2
unnamed: R311.1, R312.2
unnamed: R203.1, U201.16 (DIA_EN)
unnamed: R204.1, U201.5 (ILIM)
unnamed: R201.1, U201.3 (LATCH)
unnamed: R202.1, U201.14 (SEL1)
unnamed: R208.1, U202.16 (DIA_EN)
unnamed: R209.1, U202.5 (ILIM)
unnamed: R206.1, U202.3 (LATCH)
unnamed: R207.1, U202.14 (SEL1)
unnamed: U203.3 (V_{OUT}), U204.6 (AIN2)
unnamed: R213.1, R215.2, U204.4 (AIN0)
unnamed: U205.3 (V_{OUT}), U206.6 (AIN2)
unnamed: R217.1, R218.2, U206.4 (AIN0)
unnamed: C308.2, R304.1, U301.8 (SET)
unnamed: C309.2, R307.1, U302.8 (SET)
unnamed: C311.1, U303.6 (CTR)
unnamed: C310.1, U303.4 (CTS)
unnamed: C314.1, U304.6 (CTR)
unnamed: C313.1, U304.4 (CTS)
