Dodokamel2005/EPS-/Battery charge controlller/Battery charge controlller.kicad_pcb

## KiCad design Battery charge controlller/Battery charge controlller.kicad_pcb (2025-06-12)

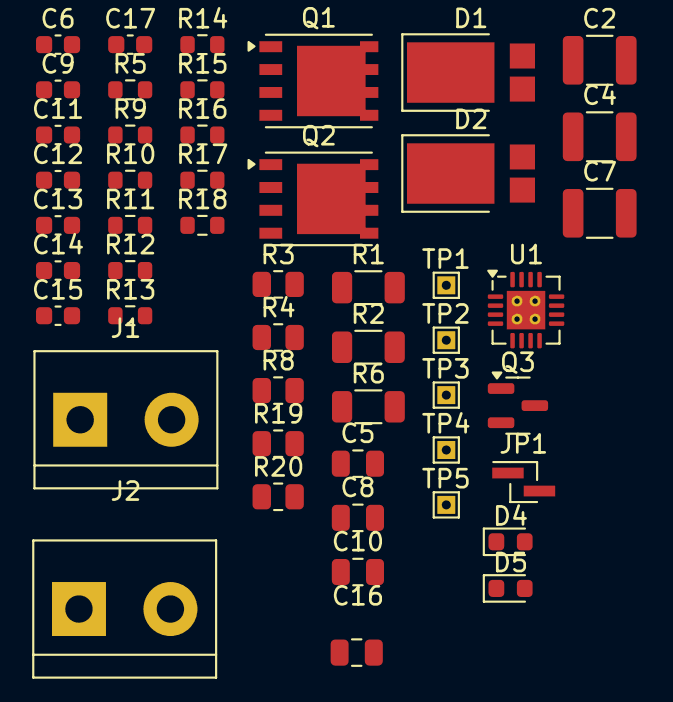
[picture p70: board Battery charge controlller.kicad_pcb from above]

Board: 2 copper layers, 50 parts (0 on the bottom side), 26 nets, no tracks yet.

Parts:
C2, C7: 10u; C_1210_3225Metric
C4: 2.2u; C_1210_3225Metric
C5, C8, C10, C16: 1u; C_0805_2012Metric
C6, C11, C12, C14: 0.1u; C_0603_1608Metric
C9, C13: 1u; C_0603_1608Metric
C15, C17: 22p; C_0603_1608Metric
D1: PDS1040; D_PowerDI-5
D2: MBR0530; D_PowerDI-5
D4, D5: LED; D_0603_1608Metric
J1: 14V; TerminalBlock_bornier-2_P5.08mm
J2: Conn_01x03; TerminalBlock_bornier-2_P5.08mm
JP1: Conn_01x03; PinHeader_1x02_P1.00mm_Vertical_SMD_Pin1Left
Q1, Q2: Si7336ADP; PowerPAK_SO-8_Single
Q3: 2N7002; SOT-23
R1, R2: 3.9k; R_1206_3216Metric
R3, R4: 10; R_0805_2012Metric
R5: 2.2; R_0603_1608Metric
R6: 0.02; R_1206_3216Metric
R8: 10k; R_0805_2012Metric
R9: 5.23k; R_0603_1608Metric
R10: 0.001; R_0603_1608Metric
R11: 100; R_0603_1608Metric
R12: 30.1k; R_0603_1608Metric
R13: 499k; R_0603_1608Metric
R14: 10k; R_0603_1608Metric
R15: 100k; R_0603_1608Metric
R16: R; R_0603_1608Metric
R17, R18: 10K; R_0603_1608Metric
R19: 499k; R_0805_2012Metric
R20: 36K; R_0805_2012Metric
TP1, TP2, TP4, TP5: TestPoint; TestPoint_THTPad_1.0x1.0mm_Drill0.5mm
TP3: TestPoint_Probe; TestPoint_THTPad_1.0x1.0mm_Drill0.5mm
U1: BQ24650; Texas_RVA_VQFN-16-1EP_3.5x3.5mm_P0.5mm_EP2.14x2.14mm_Therma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

Connections:
GND: C2.2, C4.2, C5.1, C7.2, C8.2, C10.2, C11.2, C12.2, C13.2, C16.2, J1.1, Q2.1 (S), Q2.2 (S), Q2.3 (S), Q3.3 (D), R8.2, R12.2, R14.2, R15.2, R16.2, R20.2, U1.11 (GND)
MPPSET: C17.2, Q3.2 (S), R19.2, R20.1, U1.2 (MPPSET)
unnamed: C4.1, R1.2, R2.2
unnamed: C9.2, R8.1
unnamed: C15.1, R10.2, R13.1, TP4.1
unnamed: C2.1, D1.1 (K), Q1.5 (D), R3.1, R4.1
unnamed: C6.2, D2.1 (K), R5.2
unnamed: D4.2 (A), R18.2
unnamed: D5.2 (A), R17.2
unnamed: JP1.1, R14.1
unnamed: JP1.2, R9.2, R11.1, R12.1
unnamed: Q1.4 (G), TP1.1, U1.15 (HIDRV)
unnamed: C6.1, C9.1, Q1.1 (S), Q1.2 (S), Q1.3 (S), Q2.5 (D), TP3.1, U1.14 (PH)
unnamed: Q2.4 (G), U1.13 (LODRV)
unnamed: R5.1, TP2.1, U1.16 (BTST)
unnamed: C12.1, C14.1, R6.1, U1.10 (SRP)
unnamed: C13.1, R11.2, U1.4 (TS)
unnamed: C5.2, R3.2, R4.2, U1.1 (VCC)
unnamed: C15.2, R13.2, R15.1, U1.8 (VFB)
REGN: C10.1, D2.2 (A), U1.12 (REGN)
STAT1: D4.1 (K), U1.3 (STAT1)
STAT2: D5.1 (K), U1.5 (STAT2)
TERM_EN: R16.1, U1.7 (TERM_EN)
V-BATT: C7.1, C8.1, C11.1, C14.2, R6.2, R10.1, TP5.1, U1.9 (SRN)
VIN: C17.1, D1.2 (A), J1.2, R1.1, R2.1, R17.1, R18.1, R19.1
VREF: C16.1, R9.1, U1.6 (VREF)
