Dodokamel2005/EPS-/bac-hardware/panel/pv/design/bac-panel-pv-v1.kicad_pcb

## KiCad design bac-hardware/panel/pv/design/bac-panel-pv-v1.kicad_pcb (2025-06-12)

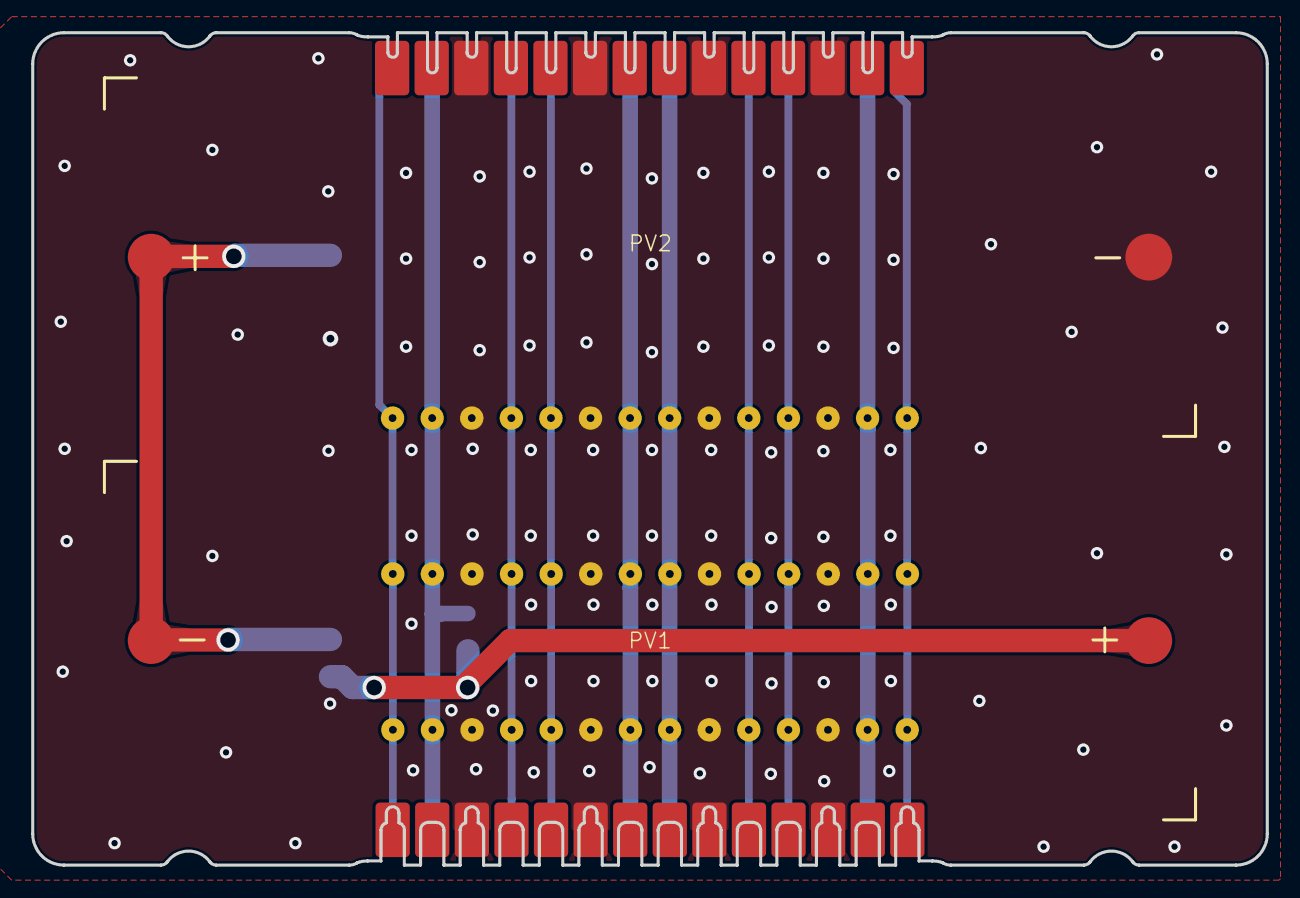
[picture p71: board bac-panel-pv-v1.kicad_pcb from above]

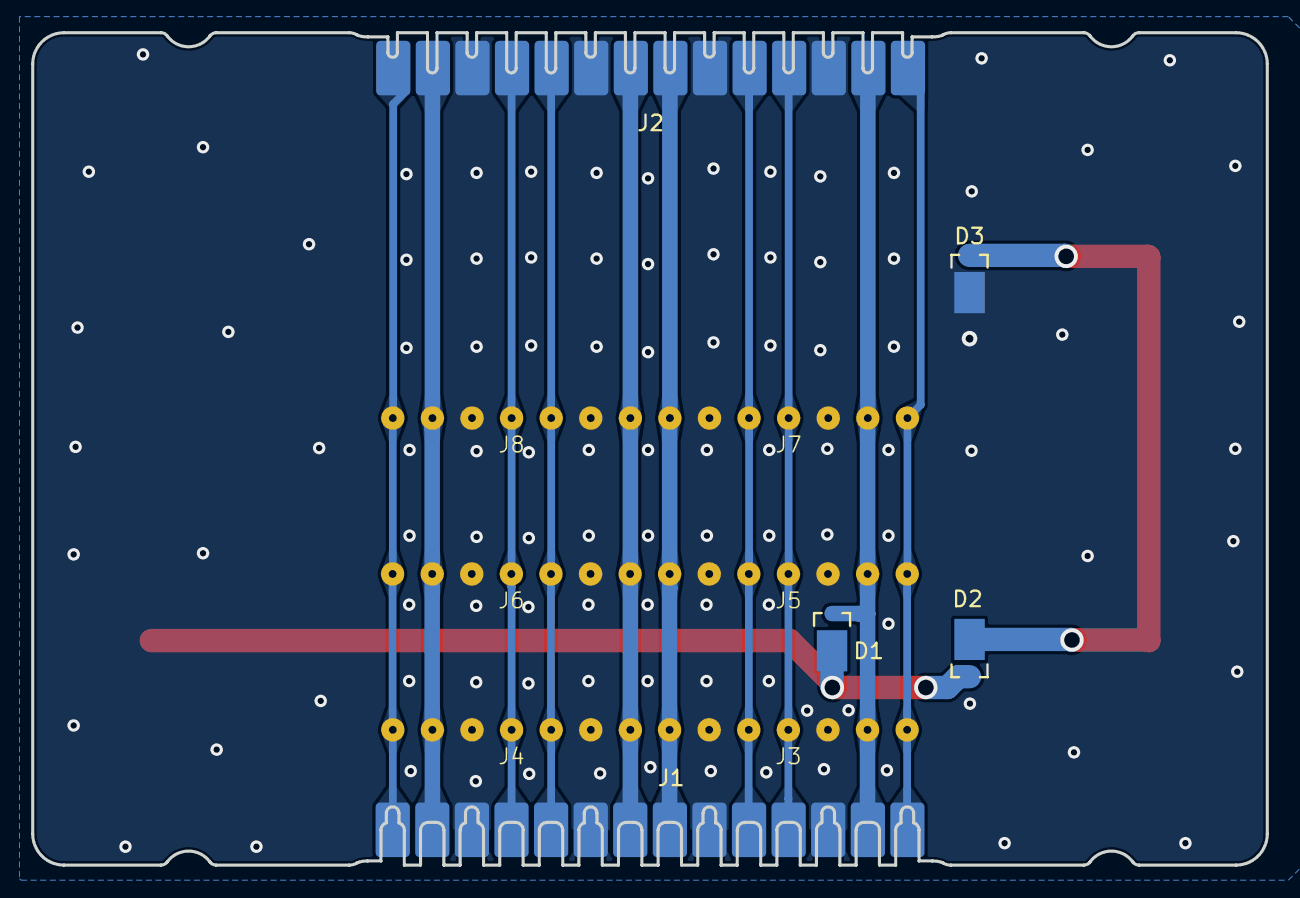
[picture p72: board bac-panel-pv-v1.kicad_pcb from below]

Board: 2 copper layers, 79.2 x 53.4 mm, 13 parts (11 on the bottom side), 13 nets.

Parts:
D1, D2, D3: D_Schottky; STM-STPS1L30MF
J1: Panel Connector 1x16; bac-panel-v1-14P-pad-row-receptacles
J2: Panel Connector 1x16; bac-panel-v1-14P-pad-row-pins
J3, J4, J5, J6, J7, J8: Conn_01x07_Socket; Mill-Max-399-10-107-10-009000
PV1, PV2: Solar_Cell; Anysolar-SM141K10TF

Connections:
/3v3_A: J1.7, J2.7, J3.7, J5.7, J7.7
/3v3_B: J1.8, J2.8, J4.1, J6.1, J8.1
/DEPLOY_2/RBF: J1.1, J2.1, J3.1, J5.1, J7.1
/EN_PANEL_B: J1.14, J2.14, J4.7, J6.7, J8.7
/PANEL_SCL_A: J1.4, J2.4, J3.4, J5.4, J7.4
/PANEL_SCL_B: J1.11, J2.11, J4.4, J6.4, J8.4
/PANEL_SDA_A: J1.5, J2.5, J3.5, J5.5, J7.5
/PANEL_SDA_B: J1.10, J2.10, J4.3, J6.3, J8.3
/VPV_A: D1.1 (K), J1.2, J2.2, J3.2, J5.2, J7.2
/VPV_B: J1.13, J2.13, J4.6, J6.6, J8.6
GND: D3.2 (A), J1.3, J1.6, J1.9, J1.12, J2.3, J2.6, J2.9, J2.12, J3.3, J3.6, J4.2, J4.5, J5.3, J5.6, J6.2, J6.5, J7.3, J7.6, J8.2, J8.5, PV2.2 (-)
unnamed: D1.2 (A), D2.1 (K), PV1.1 (+)
unnamed: D2.2 (A), D3.1 (K), PV1.2 (-), PV2.1 (+)
