Dodokamel2005/EPS-/bac-hardware/eps/battery-charger-module/ltm8062-charger-module/kicad8/bac-eps-ltm8062-charger-module-v1.kicad_pcb

## KiCad design bac-hardware/eps/battery-charger-module/ltm8062-charger-module/kicad8/bac-eps-ltm8062-charger-module-v1.kicad_pcb (2025-06-12)

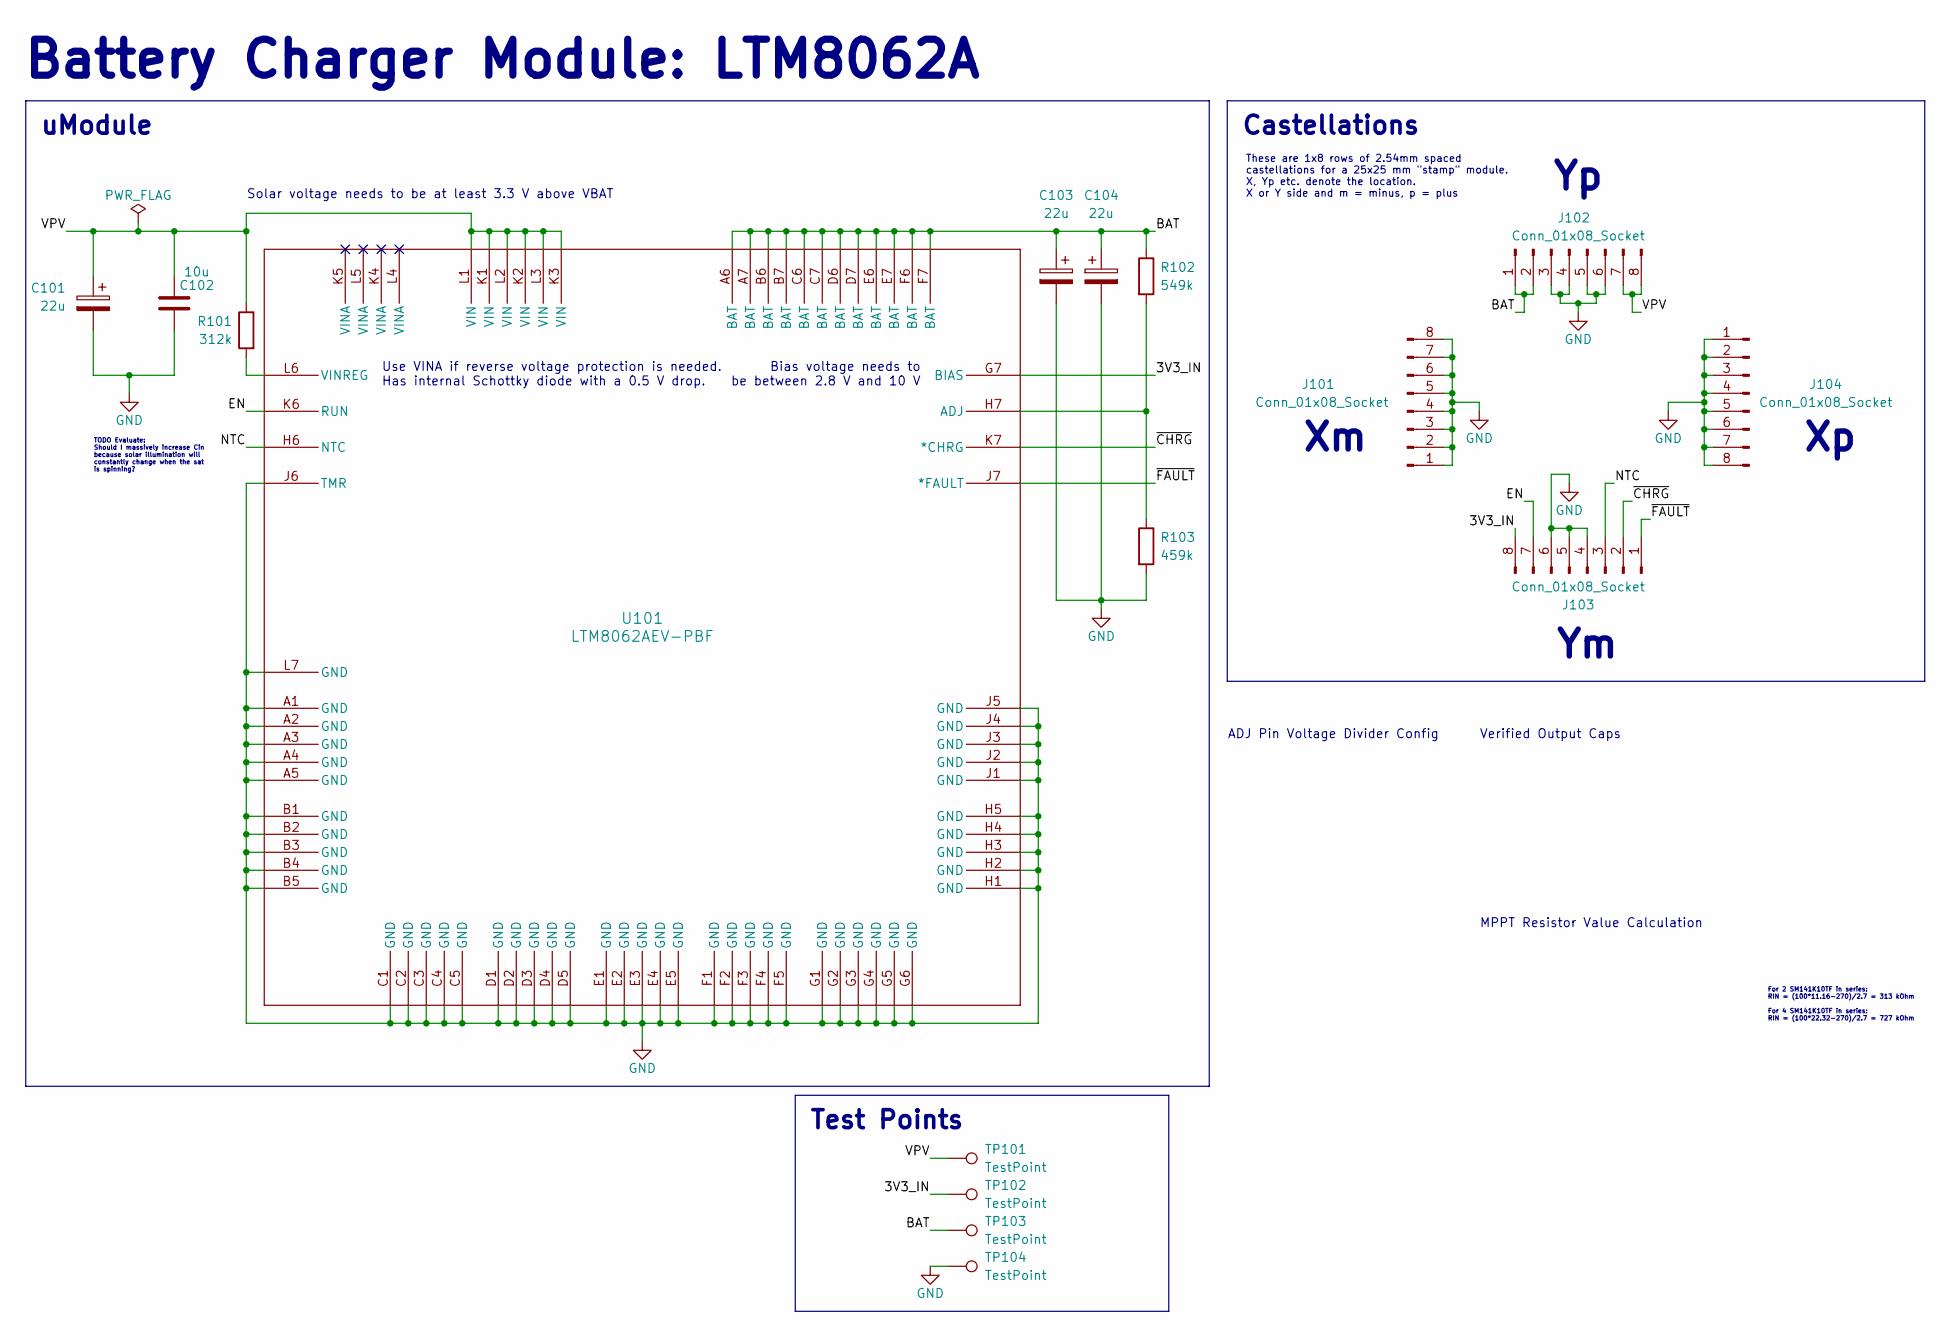
[picture p73: schematic bac-eps-ltm8062-charger-module-v1.kicad_sch, bac EPS LTM8062 Battery Charger Module]

Parts:
C101, C103, C104: 22u; CP_EIA-7343-30_AVX-N; Rated Voltage 25V; Tolerance 20%
C102: 10u; C_0603_1608Metric; Tolerance 10%; Voltage Rating 25 V
J101, J102, J103, J104: Conn_01x08_Socket; bac-eps-v1-module-8P-pad-row
R101: 312k; R_0603_1608Metric; Tolerance 0.5%
R102: 549k; R_0603_1608Metric; Tolerance 0.5%
R103: 459k; R_0603_1608Metric; Tolerance 0.5%
TP101, TP102, TP103, TP104: TestPoint; TestPoint_Pad_D1.0mm
U101: LTM8062AEV-PBF; ADI-LTM8062AEV

Connections:
/3V3_IN: J103.8, TP102.1, U101.G7 (BIAS)
/BAT: C103.1, C104.1, J102.1, J102.2, R102.1, TP103.1, U101.A6 (BAT), U101.A7 (BAT), U101.B6 (BAT), U101.B7 (BAT), U101.C6 (BAT), U101.C7 (BAT), U101.D6 (BAT), U101.D7 (BAT), U101.E6 (BAT), U101.E7 (BAT), U101.F6 (BAT), U101.F7 (BAT)
/EN: J103.7, U101.K6 (RUN)
/NTC: J103.3, U101.H6 (NTC)
/VPV: C101.1, C102.1, J102.7, J102.8, R101.1, TP101.1, U101.K1 (VIN), U101.K2 (VIN), U101.K3 (VIN), U101.L1 (VIN), U101.L2 (VIN), U101.L3 (VIN)
/~CHRG: J103.2, U101.K7 (*CHRG)
/~FAULT: J103.1, U101.J7 (*FAULT)
GND: C101.2, C102.2, C103.2, C104.2, J101.1, J101.2, J101.3, J101.4, J101.5, J101.6, J101.7, J101.8, J102.3, J102.4, J102.5, J102.6, J103.4, J103.5, J103.6, J104.1, J104.2, J104.3, J104.4, J104.5, J104.6, J104.7, J104.8, R103.2, TP104.1, U101.A1 (GND), U101.A2 (GND), U101.A3 (GND), U101.A4 (GND), U101.A5 (GND), U101.B1 (GND), U101.B2 (GND), U101.B3 (GND), U101.B4 (GND), U101.B5 (GND), U101.C1 (GND), U101.C2 (GND), U101.C3 (GND), U101.C4 (GND), U101.C5 (GND), U101.D1 (GND), U101.D2 (GND), U101.D3 (GND), U101.D4 (GND), U101.D5 (GND), U101.E1 (GND), U101.E2 (GND), U101.E3 (GND), U101.E4 (GND), U101.E5 (GND), U101.F1 (GND), U101.F2 (GND), U101.F3 (GND), U101.F4 (GND), U101.F5 (GND), U101.G1 (GND), U101.G2 (GND), U101.G3 (GND), U101.G4 (GND), U101.G5 (GND), U101.G6 (GND), U101.H1 (GND), U101.H2 (GND), U101.H3 (GND), U101.H4 (GND), U101.H5 (GND), U101.J1 (GND), U101.J2 (GND), U101.J3 (GND), U101.J4 (GND), U101.J5 (GND), U101.J6 (TMR), U101.L7 (GND)
unnamed: R102.2, R103.1, U101.H7 (ADJ)
unnamed: R101.2, U101.L6 (VINREG)

Notes on the sheet:
Use VINA if reverse voltage protection is needed. Has internal Schottky diode with a 0.5 V drop.
MPPT Resistor Value Calculation
These are 1x8 rows of 2.54mm spaced castellations for a 25x25 mm "stamp" module. X, Yp etc. denote the location. X or Y side and m = minus, p = plus
Bias voltage needs to be between 2.8 V and 10 V
Solar voltage needs to be at least 3.3 V above VBAT
For 2 SM141K10TF in series: RIN = (100*11.16-270)/2.7 = 313 kOhm For 4 SM141K10TF in series: RIN = (100*22.32-270)/2.7 = 727 kOhm
TODO Evaluate: Should I massively increase Cin because solar illumination will constantly change when the sat is spinning?
Verified Output Caps
ADJ Pin Voltage Divider Config
Battery Charger Module: LTM8062A
Test Points
uModule
Castellations

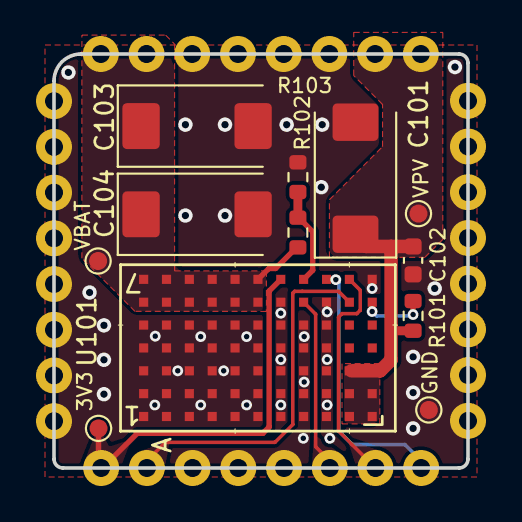
[picture p74: board bac-eps-ltm8062-charger-module-v1.kicad_pcb from above]

Board: 2 copper layers, 23.0 x 23.0 mm, 16 parts (0 on the bottom side), 10 nets.
