Dodokamel2005/EPS-/bac-hardware/eps/voltage-regulator-module/tpsm5d1806-buck-module/design/tpsm5d1806-buck-module.kicad_pcb

## KiCad design bac-hardware/eps/voltage-regulator-module/tpsm5d1806-buck-module/design/tpsm5d1806-buck-module.kicad_pcb (2025-06-12)

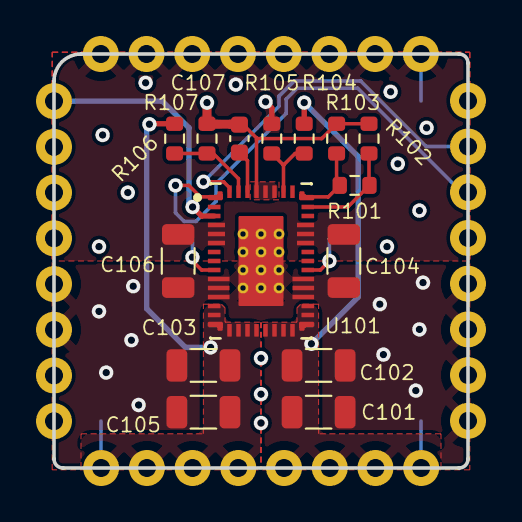
[picture p75: board tpsm5d1806-buck-module.kicad_pcb from above]

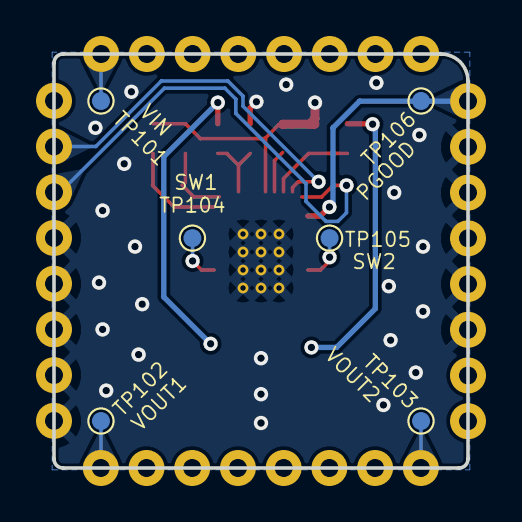
[picture p76: board tpsm5d1806-buck-module.kicad_pcb from below]

Board: 4 copper layers, 23.0 x 23.0 mm, 26 parts (6 on the bottom side), 15 nets.

Parts:
C101, C102, C103, C104, C105, C106: 100u; C_1206_3216Metric
C107: 10u; C_0603_1608Metric
J101, J102, J103, J104: Conn_01x08_Socket; bac-eps-v1-module-8P-pad-row
NT101: NetTie_2; NetTie-2_SMD_Pad0.5mm
R101, R105, R107: 10k; R_0603_1608Metric
R102: 15k4; R_0603_1608Metric
R103: 17k4; R_0603_1608Metric
R104: 56k; R_0603_1608Metric
R106: 90k; R_0603_1608Metric
TP101, TP102, TP103, TP104, TP105, TP106: TestPoint; TestPoint_Pad_D1.0mm
U101: TI TPSM5D1806RDBR; TI-TPSM5D1806RDBR

Connections:
/EN1: J104.2, U101.46 (EN2_ISHARE)
/EN2: J104.3, U101.1 (EN1)
/FB1: R104.1, R105.1, U101.40 (FB1)
/FB2: R106.1, R107.1, U101.45 (FB2_VSHARE)
/MODE1: R101.1, R102.1, U101.37 (MODE1)
/MODE2: R101.2, R103.1, U101.38 (MODE2)
/PGOOD1: J101.8, TP106.1, U101.3 (PGOOD1)
/SW1: TP104.1, U101.30 (SW1)
/SW2: TP105.1, U101.9 (SW2)
/VIN: C104.1, C106.1, J102.1, J102.2, J102.3, J102.4, J102.5, J102.6, J102.7, J102.8, TP101.1, U101.4 (VIN), U101.5 (VIN), U101.6 (VIN), U101.33 (VIN), U101.34 (VIN), U101.35 (VIN)
/VOUT1: C101.1, C102.1, J103.1, J103.2, J103.3, J103.4, R104.2, TP102.1, U101.20 (VOUT1), U101.21 (VOUT1), U101.22 (VOUT1), U101.23 (VOUT1), U101.24 (VOUT1), U101.25 (VOUT1), U101.26 (VOUT1)
/VOUT2: C103.1, C105.1, J103.5, J103.6, J103.7, J103.8, R106.2, TP103.1, U101.13 (VOUT2), U101.14 (VOUT2), U101.15 (VOUT2), U101.16 (VOUT2), U101.17 (VOUT2), U101.18 (VOUT2), U101.19 (VOUT2)
GND: C101.2, C102.2, C103.2, C104.2, C105.2, C106.2, J101.3, J101.4, J101.5, J101.6, J101.7, J104.4, J104.5, J104.6, J104.7, J104.8, NT101.2, R105.2, R107.2, U101.10 (PGND), U101.11 (PGND), U101.12 (PGND), U101.27 (PGND), U101.28 (PGND), U101.29 (PGND), U101.47 (PGND), U101.52 (PGND), U101.53 (PGND), U101.54 (PGND), U101.55 (PGND), U101.56 (PGND), U101.57 (PGND), U101.58 (PGND), U101.59 (PGND), U101.60 (PGND), U101.61 (PGND), U101.62 (PGND), U101.63 (PGND)
GNDA: C107.2, NT101.1, R102.2, R103.2, U101.41 (RS-), U101.42 (AGND), U101.43 (AGND)
unnamed: C107.1, U101.44 (BP5)
