Dodokamel2005/EPS-/bac-hardware/panel/hatch/design/bac-panel-hatch-v1.kicad_pcb

## KiCad design bac-hardware/panel/hatch/design/bac-panel-hatch-v1.kicad_pcb (2025-06-12)

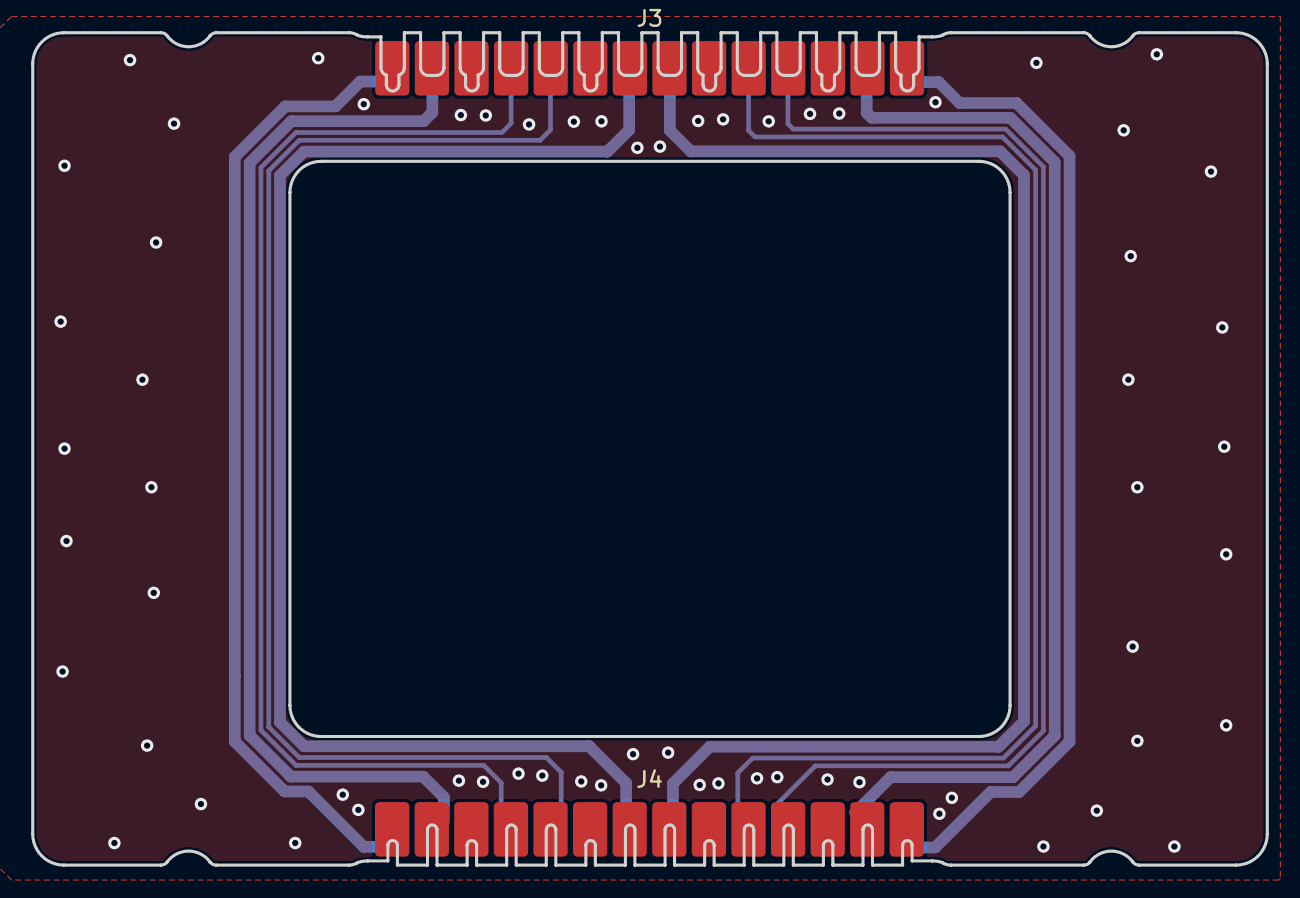
[picture p77: board bac-panel-hatch-v1.kicad_pcb from above]

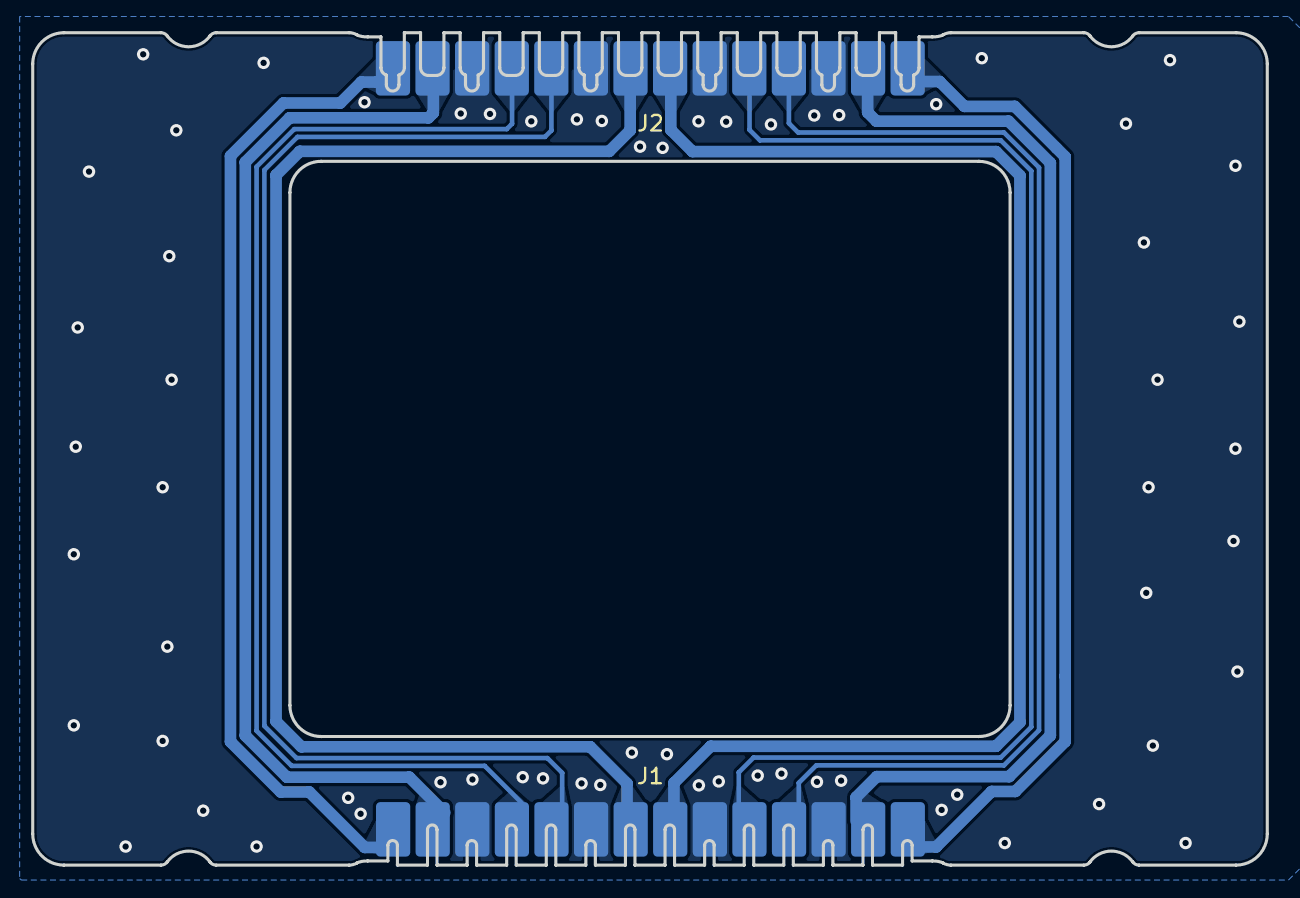
[picture p78: board bac-panel-hatch-v1.kicad_pcb from below]

Board: 2 copper layers, 79.2 x 53.4 mm, 4 parts (2 on the bottom side), 11 nets.

Parts:
J1, J2, J3, J4: Panel Connector 1x16; bac-panel-v1-14P-pad-row

Connections:
/3v3_A: J1.7, J2.7
/3v3_B: J1.8, J2.8
/DEPLOY_2/RBF: J1.1, J2.1
/EN_PANEL_B: J1.14, J2.14
/PANEL_SCL_A: J1.4, J2.4
/PANEL_SCL_B: J1.11, J2.11
/PANEL_SDA_A: J1.5, J2.5
/PANEL_SDA_B: J1.10, J2.10
/VPV_A: J1.2, J2.2
/VPV_B: J1.13, J2.13
GND: J1.3, J1.6, J1.9, J1.12, J2.3, J2.6, J2.9, J2.12
