Dodokamel2005/EPS-/bac-hardware/eps/voltage-regulator-module/ltm4675-buck-module/design/ltm4675-buck-module.kicad_pcb

## KiCad design bac-hardware/eps/voltage-regulator-module/ltm4675-buck-module/design/ltm4675-buck-module.kicad_pcb (2025-06-12)

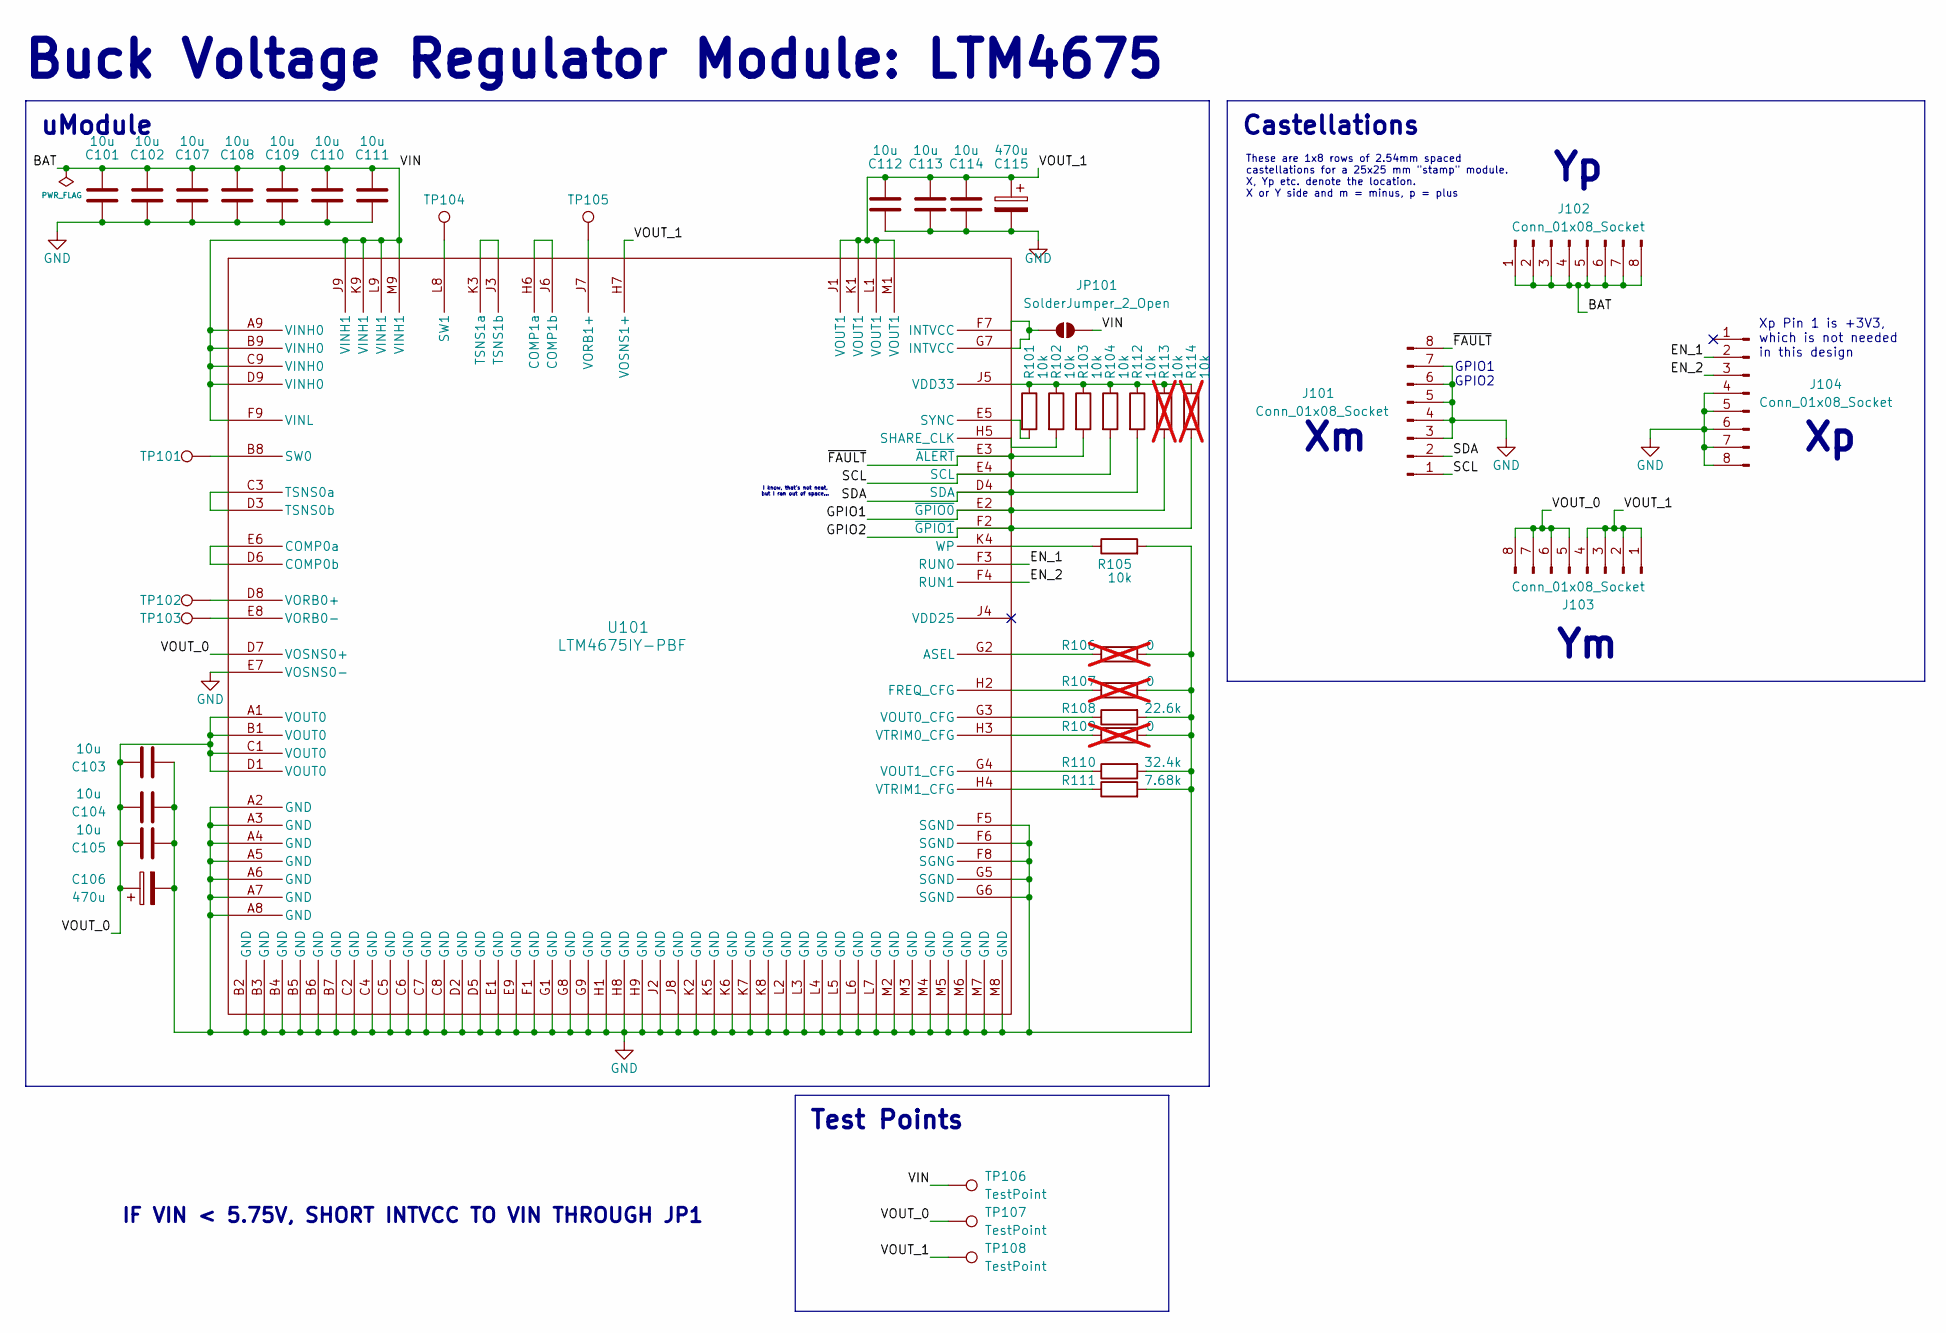
[picture p79: schematic ltm4675-buck-module.kicad_sch, EPS LTM4675 Buck Module(5V)]

Parts:
C101, C102, C103, C104, C105, C107, C108, C109, C110, C111, C112, C113, C114: 10u; C_0603_1608Metric; Tolerance 10%; Voltage Rating 25 V
C106, C115: 470u; CP_EIA-7343-15_Kemet-W; Tolerance 20%; Voltage Rating 6.3 V
J101, J102, J103, J104: Conn_01x08_Socket; bac-eps-v1-module-8P-pad-row
JP101: SolderJumper_2_Open; SolderJumper-2_P1.3mm_Open_TrianglePad1.0x1.5mm
R101, R102, R103, R104, R105, R112: 10k; R_0603_1608Metric
R106, R107, R109: 0; R_0603_1608Metric; Tolerance 1%; not fitted
R108: 22.6k; R_0603_1608Metric; Tolerance 1%
R110: 32.4k; R_0603_1608Metric; Tolerance 1%
R111: 7.68k; R_0603_1608Metric; Tolerance 1%
R113, R114: 10k; R_0201_0603Metric; not fitted
TP101, TP102, TP103, TP104, TP105, TP106, TP107, TP108: TestPoint; TestPoint_Pad_D1.0mm
U101: LTM4675IY-PBF; ADI-LTM4675IY

Connections:
/BAT: C101.1, C102.1, C107.1, C108.1, C109.1, C110.1, C111.1, J102.1, J102.2, J102.3, J102.4, J102.5, J102.6, J102.7, J102.8, JP101.2 (B), TP106.1, U101.A9 (VINH0), U101.B9 (VINH0), U101.C9 (VINH0), U101.D9 (VINH0), U101.F9 (VINL), U101.J9 (VINH1), U101.K9 (VINH1), U101.L9 (VINH1), U101.M9 (VINH1)
/EN_1: J104.2, U101.F3 (RUN0)
/EN_2: J104.3, U101.F4 (RUN1)
/GPIO1: R113.2, U101.E2 (~GPIO0)
/GPIO2: R114.2, U101.F2 (~GPIO1)
/SCL: J101.1, R104.2, U101.E4 (SCL)
/SDA: J101.2, R112.2, U101.D4 (SDA)
/VOUT_0: C103.1, C104.1, C105.1, C106.1, J103.5, J103.6, J103.7, J103.8, TP107.1, U101.A1 (VOUT0), U101.B1 (VOUT0), U101.C1 (VOUT0), U101.D1 (VOUT0), U101.D7 (VOSNS0+)
/VOUT_1: C112.1, C113.1, C114.1, C115.1, J103.1, J103.2, J103.3, J103.4, TP108.1, U101.H7 (VOSNS1+), U101.J1 (VOUT1), U101.K1 (VOUT1), U101.L1 (VOUT1), U101.M1 (VOUT1)
/~FAULT: J101.8, R103.2, U101.E3 (~ALERT)
GND: C101.2, C102.2, C103.2, C104.2, C105.2, C106.2, C107.2, C108.2, C109.2, C110.2, C111.2, C112.2, C113.2, C114.2, C115.2, J101.3, J101.4, J101.5, J101.6, J101.7, J104.4, J104.5, J104.6, J104.7, J104.8, R105.2, R106.2, R107.2, R108.2, R109.2, R110.2, R111.2, U101.A2 (GND), U101.A3 (GND), U101.A4 (GND), U101.A5 (GND), U101.A6 (GND), U101.A7 (GND), U101.A8 (GND), U101.B2 (GND), U101.B3 (GND), U101.B4 (GND), U101.B5 (GND), U101.B6 (GND), U101.B7 (GND), U101.C2 (GND), U101.C4 (GND), U101.C5 (GND), U101.C6 (GND), U101.C7 (GND), U101.C8 (GND), U101.D2 (GND), U101.D5 (GND), U101.E1 (GND), U101.E7 (VOSNS0-), U101.E9 (GND), U101.F1 (GND), U101.F5 (SGND), U101.F6 (SGND), U101.F8 (SGNG), U101.G1 (GND), U101.G5 (SGND), U101.G6 (SGND), U101.G8 (GND), U101.G9 (GND), U101.H1 (GND), U101.H8 (GND), U101.H9 (GND), U101.J2 (GND), U101.J8 (GND), U101.K2 (GND), U101.K5 (GND), U101.K6 (GND), U101.K7 (GND), U101.K8 (GND), U101.L2 (GND), U101.L3 (GND), U101.L4 (GND), U101.L5 (GND), U101.L6 (GND), U101.L7 (GND), U101.M2 (GND), U101.M3 (GND), U101.M4 (GND), U101.M5 (GND), U101.M6 (GND), U101.M7 (GND), U101.M8 (GND)
unnamed: JP101.1 (A), U101.F7 (INTVCC), U101.G7 (INTVCC)
unnamed: R106.1, U101.G2 (ASEL)
unnamed: U101.D6 (COMP0b), U101.E6 (COMP0a)
unnamed: U101.H6 (COMP1a), U101.J6 (COMP1b)
unnamed: R107.1, U101.H2 (FREQ_CFG)
unnamed: R102.2, U101.H5 (SHARE_CLK)
unnamed: TP101.1, U101.B8 (SW0)
unnamed: TP104.1, U101.L8 (SW1)
unnamed: R101.2, U101.E5 (SYNC)
unnamed: U101.C3 (TSNS0a), U101.D3 (TSNS0b)
unnamed: U101.J3 (TSNS1b), U101.K3 (TSNS1a)
unnamed: R101.1, R102.1, R103.1, R104.1, R112.1, R113.1, R114.1, U101.J5 (VDD33)
unnamed: TP102.1, U101.D8 (VORB0+)
unnamed: TP103.1, U101.E8 (VORB0-)
unnamed: TP105.1, U101.J7 (VORB1+)
unnamed: R108.1, U101.G3 (VOUT0_CFG)
unnamed: R110.1, U101.G4 (VOUT1_CFG)
unnamed: R109.1, U101.H3 (VTRIM0_CFG)
unnamed: R111.1, U101.H4 (VTRIM1_CFG)
unnamed: R105.1, U101.K4 (WP)

Notes on the sheet:
These are 1x8 rows of 2.54mm spaced castellations for a 25x25 mm "stamp" module. X, Yp etc. denote the location. X or Y side and m = minus, p = plus
I know, that's not neat, but I ran out of space...
IF VIN < 5.75V, SHORT INTVCC TO VIN THROUGH JP1
Xp Pin 1 is +3V3, which is not needed in this design
GPIO1 GPIO2
Buck Voltage Regulator Module: LTM4675
Test Points
uModule
Castellations

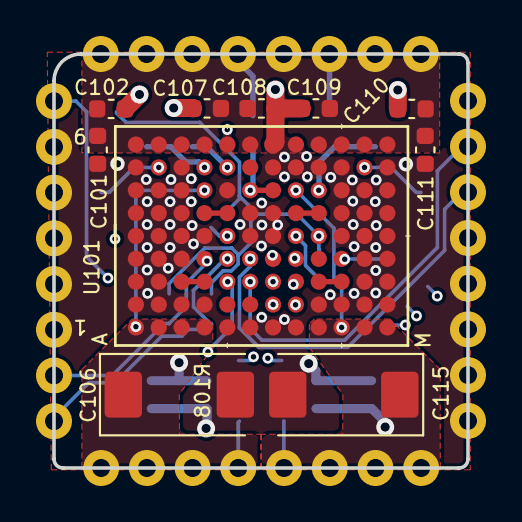
[picture p80: board ltm4675-buck-module.kicad_pcb from above]

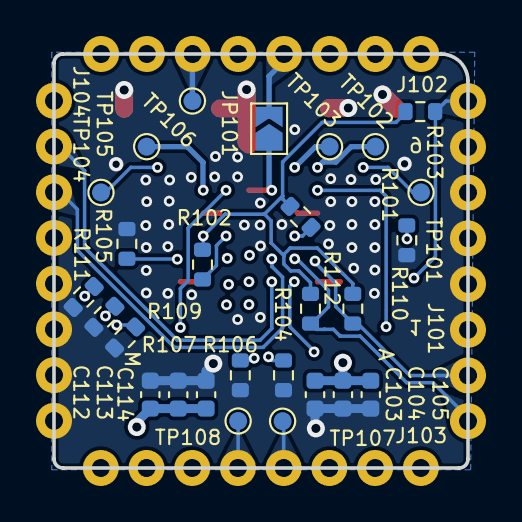
[picture p81: board ltm4675-buck-module.kicad_pcb from below]

Board: 4 copper layers, 23.0 x 23.0 mm, 41 parts (27 on the bottom side), 29 nets.
