Dodokamel2005/EPS-/bac-hardware/sbc/cm5-carrier-board/ecad/bac-sbc-cm5-carrier-board-v1.kicad_pcb

## KiCad design bac-hardware/sbc/cm5-carrier-board/ecad/bac-sbc-cm5-carrier-board-v1.kicad_pcb (2025-06-12)

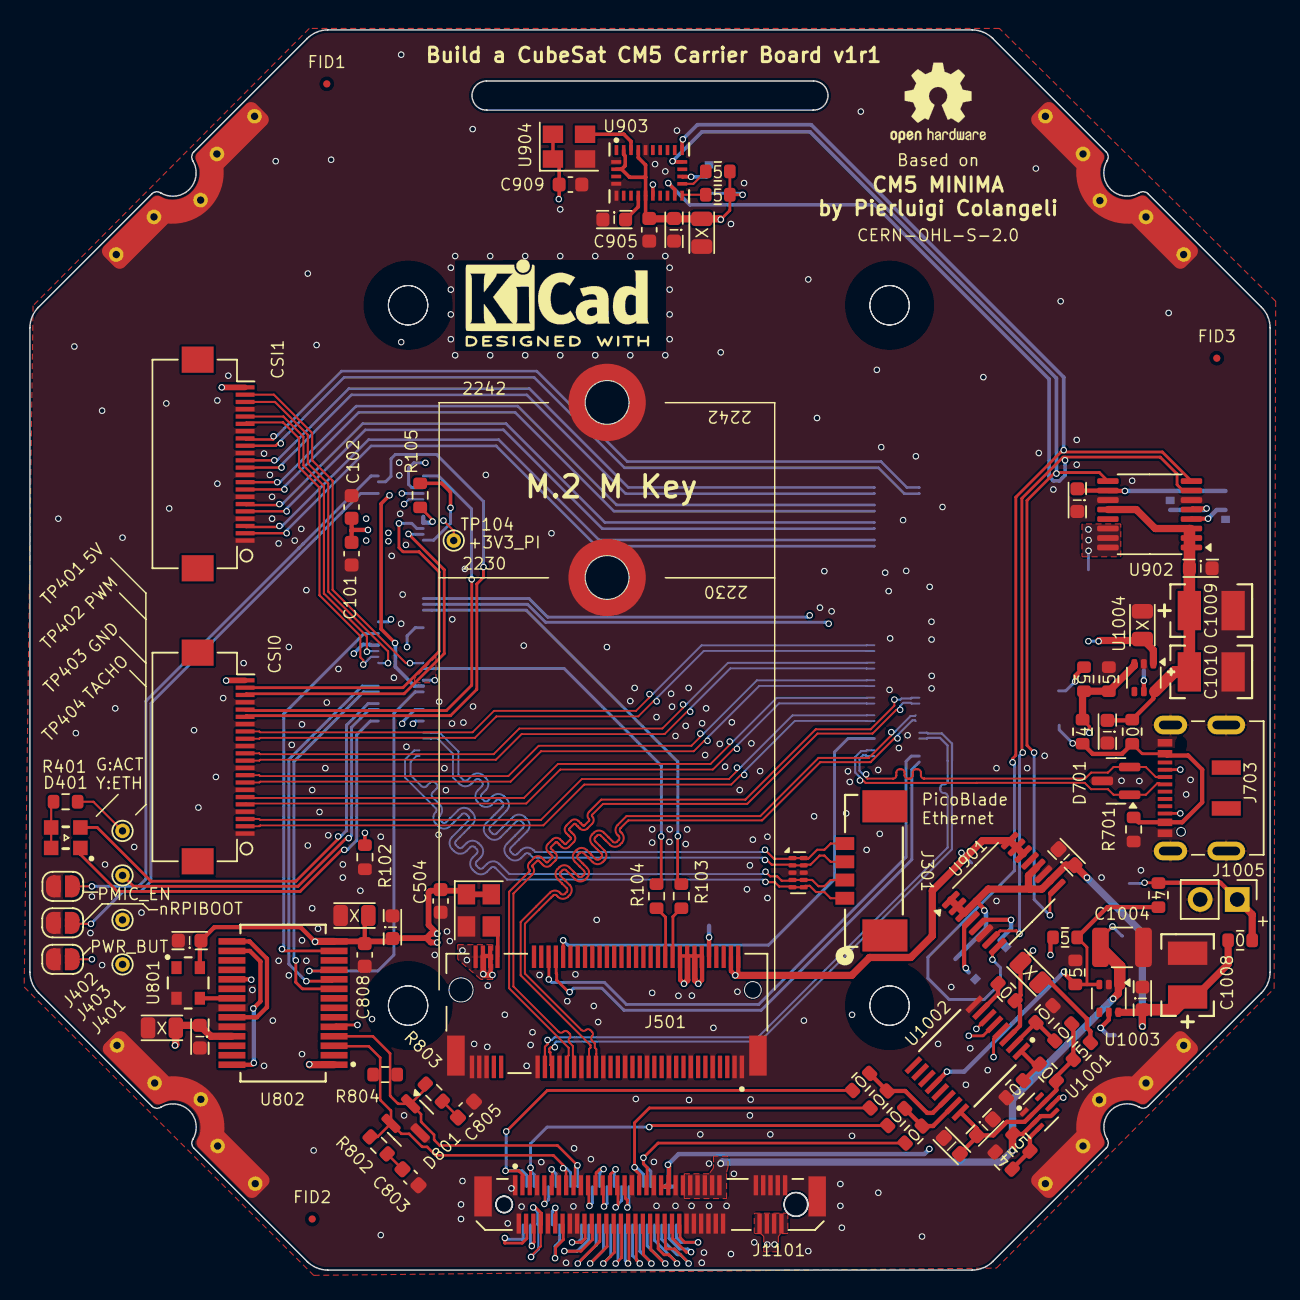
[picture p82: board bac-sbc-cm5-carrier-board-v1.kicad_pcb from above]

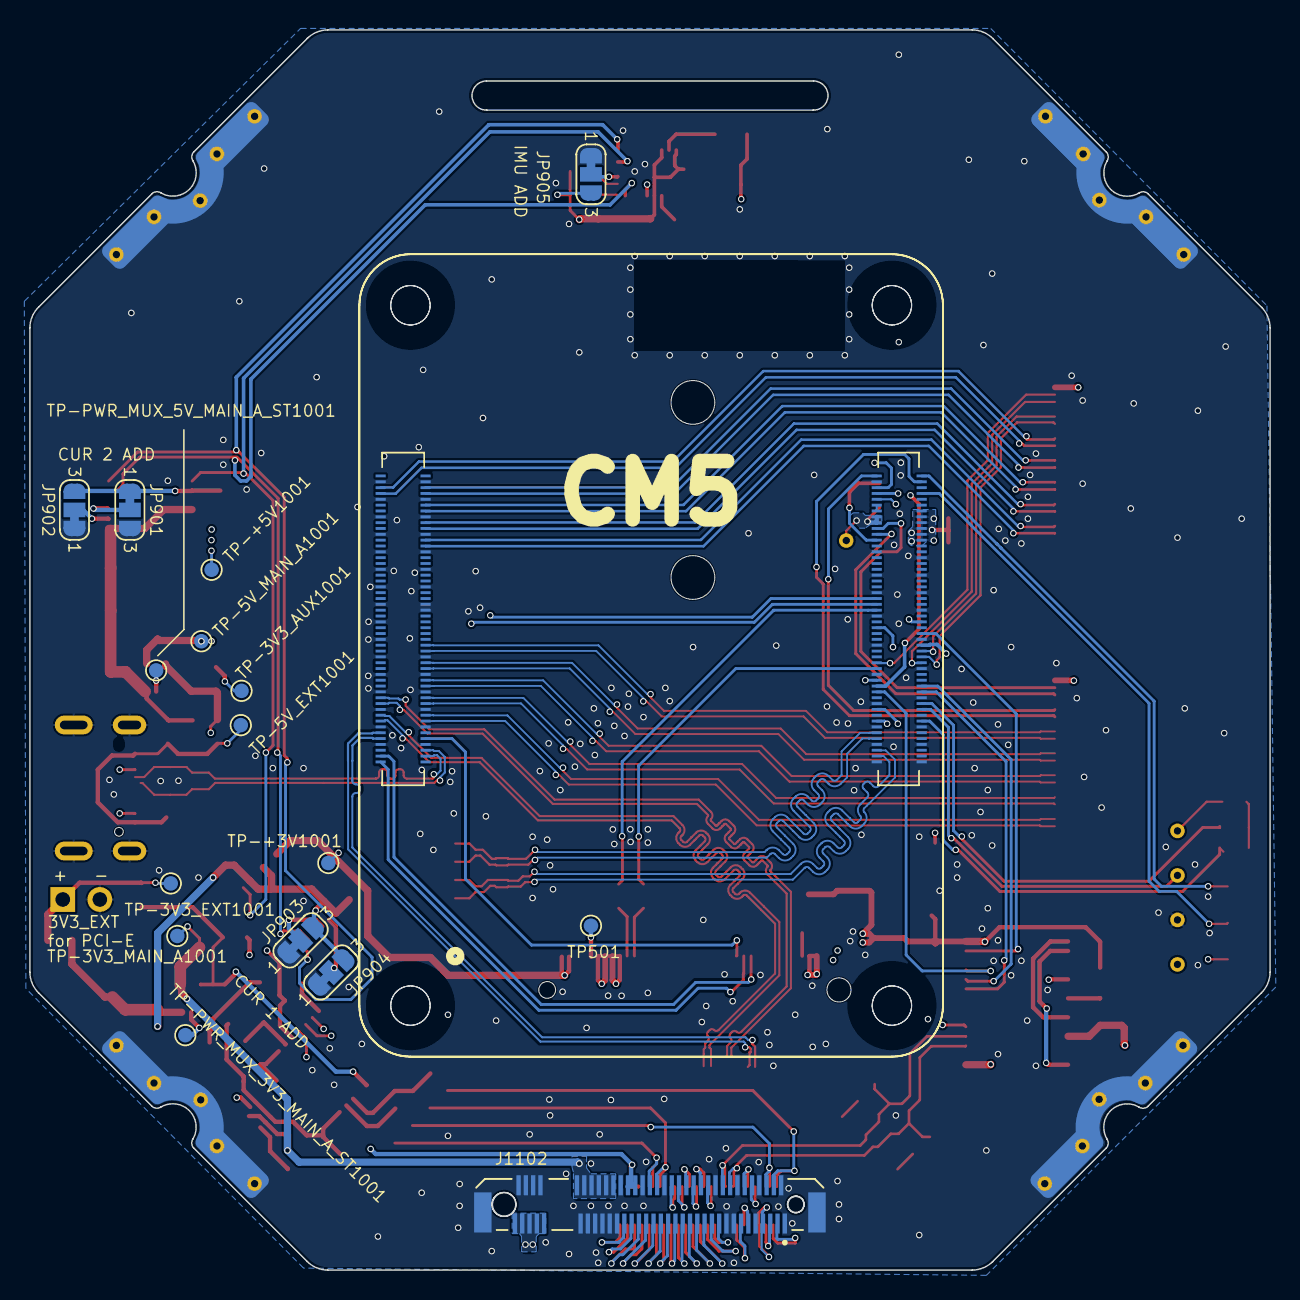
[picture p83: board bac-sbc-cm5-carrier-board-v1.kicad_pcb from below]

Board: 6 copper layers, 85.0 x 85.0 mm, 117 parts (18 on the bottom side), 143 nets.

Parts:
C101, C102, C504, C909: 100n; C_0603_1608Metric
C801, C804, C807, C901, C903, C904, C906, C908, C1003, C1006, C1007: 0.1u; bac-C-0603-0.1u
C802, C806, C907, C1002: 10u; bac-C-0805-10u
C803, C805, C808, C905: 560p; C_0603_1608Metric
C1001: 1u; bac-C-0603-1u
C1004: 22u; C_1210_3225Metric
C1005: 47u; bac-C-0805-10u
C1008, C1009, C1010: 47u; bac-C-1411
D401: WE 150080SG54050; WE-150080XX54050
D701: TI ESD752; SOT-23
D801: ESD752; SOT-23
FID1, FID2, FID3: Fiducial; Fiducial_0.5mm_Mask1mm
H1, H2, H3, H4: MountingHole_Pad; bac-PCB-Rail-Pad
J301: Molex 533984004; Molex-0533984004
J401, J402, J403: SolderJumper_2_Open; SolderJumper-2_P1.3mm_Open_RoundedPad1.0x1.5mm
J501: Bus_M.2_Socket_M; piecol-M.2-M-Key-socket-2230-2242
J601, J602: Conn_01x22_Female; piecol-Hirose-FH12-22S-0.5SH-1x22-1MP-P0.50mm-Horizontal
J703: TYPEC-305-ACP16H458; JAE-DX07S016JA1R1500
J1005: Conn_01x02_Socket; PinHeader_1x02_P2.54mm_Vertical
J1101, J1102: MDT350M01001VT; AMP-MDT350M01001VT
JP901, JP902, JP903, JP904, JP905: SolderJumper_3_Bridged12; SolderJumper-3_P1.3mm_Bridged12_RoundedPad1.0x1.5mm_NumberL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
M501: M2.5 Solder Nut 2230; WE-9774025243R
M502: M2.5 Solder Nut 2242; WE-9774025243R
Module201: ComputeModule5-CM5; piecol-Raspberry-Pi-5-Compute-Module-GPIO
Module202: ComputeModule5-CM5; piecol-Raspberry-Pi-5-Compute-Module-HSS
R102, R701: 10k; R_0603_1608Metric
R103, R104, R105: 0R; R_0603_1608Metric
R401: 2k2; R_0603_1608Metric
R802, R803, R804: 120; R_0603_1608Metric
R901, R902, R1001, R1013, R1015, R1016, R1017, R1018: 100k; bac-R-0603-100k
R1002, R1019, R1020: 10k; bac-R-0603-10k
R1003, R1004, R1005, R1006, R1007, R1008, R1010, R1011, R1014, R1021, R1022: 0; bac-R-0603-0
TP104: +3V3_PI; TestPoint_THTPad_D1.0mm_Drill0.5mm
TP401, TP402, TP403, TP404: GND; TestPoint_THTPad_D1.0mm_Drill0.5mm
TP501: GND; TestPoint_Pad_D1.0mm
TP-3V3_AUX1001: 3V3_AUX; TestPoint_Pad_D1.0mm
TP-3V3_EXT1001: 3V3_EXT; TestPoint_Pad_D1.0mm
TP-3V3_MAIN_A1001: 3V3_MAIN_A; TestPoint_Pad_D1.0mm
TP-5V_EXT1001: 5V_EXT; TestPoint_Pad_D1.0mm
TP-5V_MAIN_A1001: 5V_MAIN_A; TestPoint_Pad_D1.0mm
TP-+3V1001: +3V3; TestPoint_Pad_D1.0mm
TP-+5V1001: +5V; TestPoint_Pad_D1.0mm
TP-PWR_MUX_3V3_MAIN_A_ST1001: PWR_MUX_3V3_MAIN_A_ST; TestPoint_Pad_D1.0mm
TP-PWR_MUX_5V_MAIN_A_ST1001: PWR_MUX_5V_MAIN_A_ST; TestPoint_Pad_D1.0mm
U301: TPD4EUSB30; USON-10_2.5x1.0mm_P0.5mm
U503, U904: ASEK-32.768KHZ-L-R-T; Crystal_SMD_3225-4Pin_3.2x2.5mm
U801: SIT5000AI-2E-33N0-40.000000X; SIT-SIT5000AI-2E-33N0
U802: MCP251863T-H-SS; MT-MCP251863T-H-SS
U901, U902: INA260; TSSOP-16_4.4x5mm_P0.65mm
U903: BNO086; CEVA-BNO086
U1001: TPS2116DRL; TI-TPS2116DRL
U1002: TCAL9538PWR; TI-TCAL9538PWR
U1003, U1004: LM66100DCK; SOT-363_SC-70-6

Connections:
+1V8: Module201.88 (+1.8v_(Output)), Module201.90 (+1.8v_(Output))
+3V3: C504.1, C801.1, C806.1, C807.1, C808.1, J501.2 (3.3V), J501.4 (3.3V), J501.12 (3.3V), J501.14 (3.3V), J501.16 (3.3V), J501.18 (3.3V), J501.70 (3.3V), J501.72 (3.3V), J501.74 (3.3V), TP-+3V1001.1, U503.1 (EN), U503.4 (VDD), U801.4 (VDD), U802.1 (VIO), U802.14 (VDD), U901.14 (IN-), U901.15 (IN-), U901.16 (IN-)
+3V3_EXT: J1005.1, R1019.1, R1021.2, TP-3V3_EXT1001.1
+3V3_IN: C901.1, C903.1, C1006.1, C1008.1, JP901.1 (A), JP902.3 (B), JP903.3 (B), JP904.3 (B), R1021.1, U901.1 (IN+), U901.2 (IN+), U901.3 (IN+), U901.10 (VS), U901.12 (VBUS), U902.10 (VS), U1003.6 (VOUT)
+3V3_PI: C905.1, C906.1, C907.1, C909.1, J601.22, J602.22, JP905.3 (B), Module201.84 (+3.3v_(Output)), Module201.86 (+3.3v_(Output)), R105.1, R901.2, R902.2, TP104.1, U903.3 (VDD), U903.10 (CLKSEL0), U903.26 (XOUT32/CLKSEL1), U903.28 (VDDIO), U904.1 (EN), U904.4 (VDD)
+5V: C101.1, C102.1, C802.1, C804.1, Module201.77 (+5v_(Input)), Module201.79 (+5v_(Input)), Module201.81 (+5v_(Input)), Module201.83 (+5v_(Input)), Module201.85 (+5v_(Input)), Module201.87 (+5v_(Input)), R401.1, TP401.1, TP-+5V1001.1, U802.25 (VCC), U902.14 (IN-), U902.15 (IN-), U902.16 (IN-)
+5V_EXT: J703.A4 (VBUS), J703.A9 (VBUS), J703.B4 (VBUS), J703.B9 (VBUS), R701.1, R1020.1, R1022.2, TP-5V_EXT1001.1
+5V_IN: C904.1, C1007.1, C1009.1, C1010.1, R1022.1, U902.1 (IN+), U902.2 (IN+), U902.3 (IN+), U902.12 (VBUS), U1004.6 (VOUT)
/+3V3_AUX: J1101.41, J1101.43, J1102.42, J1102.44, R1015.1, R1017.1, TP-3V3_AUX1001.1, U1001.6 (VIN2)
/+3V3_MAIN_A: C1004.1, J1101.47, J1101.49, J1101.51, J1101.53, J1101.55, J1101.57, J1102.48, J1102.50, J1102.52, J1102.54, J1102.56, J1102.58, R1001.1, TP-3V3_MAIN_A1001.1, U1001.3 (VIN1), U1001.5 (MODE), U1003.1 (VIN)
/+5V_MAIN_A: C1005.1, J1101.68, J1101.70, J1101.72, J1101.74, J1102.67, J1102.69, J1102.71, J1102.73, J1102.75, TP-5V_MAIN_A1001.1, U1004.1 (VIN)
/BACBUS_A_CAN_1_N: D801.2 (K), J1101.15, J1102.16, R802.1, R804.2, U802.3 (CANL)
/BACBUS_A_CAN_1_P: D801.1 (K), J1101.17, J1102.18, R803.1, R804.1, U802.4 (CANH)
/BACBUS_A_I2C_1_SCL: J1101.3, J1102.4, R1008.1
/BACBUS_A_I2C_1_SDA: J1101.5, J1102.6, R1007.1
/BACBUS_A_I2C_2_SCL: J1101.35, J1102.36, R1011.2
/BACBUS_A_I2C_2_SDA: J1101.37, J1102.38, R1010.2
/CAN_1_CS: Module201.45 (GPIO24), U802.13 (~CS)
/CAN_1_INT: Module201.49 (GPIO18), U802.19 (~INT)
/CAN_1_PICO: Module201.27 (GPIO20), U802.10 (SDI)
/CAN_1_POCI: Module201.26 (GPIO19), U802.11 (SDO)
/CAN_1_SCL: Module201.25 (GPIO21), U802.9 (SCK)
/CAN_1_SHDN: Module201.48 (GPIO27), U802.5 (STBY)
/CM5/CAM0_GPIO0: J601.17, Module201.97 (CAM_GPIO0)
/CM5/CAM0_GPIO1: J601.18, Module201.100 (CAM_GPIO1)
/CM5/CC1: J703.A5 (CC1), Module201.94 (CC1)
/CM5/CC2: J703.B5 (CC2), Module201.96 (CC2)
/CM5/DPHY0_P.C_N: J601.8, Module202.127 (MIPI0_C_N)
/CM5/DPHY0_P.C_P: J601.9, Module202.129 (MIPI0_C_P)
/CM5/DPHY0_P.D0_N: J601.2, Module202.115 (MIPI0_D0_N)
/CM5/DPHY0_P.D0_P: J601.3, Module202.117 (MIPI0_D0_P)
/CM5/DPHY0_P.D1_N: J601.5, Module202.121 (MIPI0_D1_N)
/CM5/DPHY0_P.D1_P: J601.6, Module202.123 (MIPI0_D1_P)
/CM5/DPHY0_P.D2_N: J601.11, Module202.133 (MIPI0_D2_N)
/CM5/DPHY0_P.D2_P: J601.12, Module202.135 (MIPI0_D2_P)
/CM5/DPHY0_P.D3_N: J601.14, Module202.139 (MIPI0_D3_N)
/CM5/DPHY0_P.D3_P: J601.15, Module202.141 (MIPI0_D3_P)
/CM5/DPHY1_P.C_N: J602.8, Module202.187 (MIPI1_C_N)
/CM5/DPHY1_P.C_P: J602.9, Module202.189 (MIPI1_C_P)
/CM5/DPHY1_P.D0_N: J602.2, Module202.175 (MIPI1_D0_N)
/CM5/DPHY1_P.D0_P: J602.3, Module202.177 (MIPI1_D0_P)
/CM5/DPHY1_P.D1_N: J602.5, Module202.181 (MIPI1_D1_N)
/CM5/DPHY1_P.D1_P: J602.6, Module202.183 (MIPI1_D1_P)
/CM5/DPHY1_P.D2_N: J602.11, Module202.193 (MIPI1_D2_N)
/CM5/DPHY1_P.D2_P: J602.12, Module202.195 (MIPI1_D2_P)
/CM5/DPHY1_P.D3_N: J602.14, Module202.194 (MIPI1_D3_N)
/CM5/DPHY1_P.D3_P: J602.15, Module202.196 (MIPI1_D3_P)
/CM5/EEPROM_nWP: Module201.20 (EEPROM_nWP), R102.2
/CM5/ETH_PI.TRD0_N: J301.3, Module201.10 (Ethernet_Pair0_N), U301.2 (D1-), U301.9
/CM5/ETH_PI.TRD0_P: J301.4, Module201.12 (Ethernet_Pair0_P), U301.1 (D1+), U301.10
/CM5/ETH_PI.TRD1_N: J301.1, Module201.6 (Ethernet_Pair1_N), U301.5 (D2-), U301.6
/CM5/ETH_PI.TRD1_P: J301.2, Module201.4 (Ethernet_Pair1_P), U301.4 (D2+), U301.7
/CM5/ETH_nLED_ACTIVITY: D401.1, Module201.15 (Ethernet_nLED3(3.3v))
/CM5/GPIO4: Module201.54 (GPIO4), R103.2
/CM5/GPIO5: Module201.34 (GPIO5), R104.2
/CM5/GPIO7: J602.17, Module201.37 (GPIO7)
/CM5/GPIO8: J602.18, Module201.39 (GPIO8)
/CM5/GPIO_VREF: Module201.78 (GPIO_VREF(1.8v/3.3v_Input)), R105.2
/CM5/ID_SC: J602.20, Module201.35 (ID_SC)
/CM5/ID_SD: J602.21, Module201.36 (ID_SD)
/CM5/PCIE_PI.CLK_N: J501.53 (REFCLKn), Module202.112 (PCIe_CLK_N)
/CM5/PCIE_PI.CLK_P: J501.55 (REFCLKp), Module202.110 (PCIe_CLK_P)
/CM5/PCIE_PI.RX_N: J501.43 (PETp0), Module202.118 (PCIe_RX_N)
/CM5/PCIE_PI.RX_P: J501.41 (PETn0), Module202.116 (PCIe_RX_P)
/CM5/PCIE_PI.TX_N: J501.49 (PERp0), Module202.124 (PCIe_TX_N)
/CM5/PCIE_PI.TX_P: J501.47 (PERn0), Module202.122 (PCIe_TX_P)
/CM5/PCIE_PI.nCLKREQ: J501.52 (~CLKREQ), Module202.102 (PCIe_nCLKREQ)
/CM5/PCIE_PI.nRST: J501.50 (~PERST), Module202.109 (PCIe_nRST)
/CM5/PCIE_PI.nWAKE: J501.54 (~PEWAKE), Module202.104 (PCIE_nWAKE)
/CM5/PI_nLED_ACTIVITY: D401.2, Module201.21 (LED_nACT)
/CM5/PWM: Module201.19 (FAN_PWM), TP402.1
/CM5/SCL0: J601.20, Module201.80 (SCL0)
/CM5/SDA0: J601.21, Module201.82 (SDA0)
/CM5/TACHO: Module201.16 (FAN_TACHO), TP404.1
/CM5/USB_PI.D_N: D701.2 (K), J703.A7 (D-), Module202.103 (USB2_N)
/CM5/USB_PI.D_P: D701.1 (K), J703.B6 (D+), Module202.105 (USB2_P)
/CM5/nRPIBOOT: J402.2 (B), Module201.93 (nRPIBOOT)
/I2C_MUX_~RESET: C1002.2, Module201.41 (GPIO25), R1014.1, U1002.3 (~RESET)
/IMU_~RESET: Module201.28 (GPIO13), U903.11 (NRST)
/PCIe-M2/RX: J501.22 (NC), R104.1
/PCIe-M2/TX: J501.20 (NC), R103.1
/PMIC_EN: J403.1 (A), Module201.99 (PMIC_ENABLE), U1002.5 (P1)
/PWR_BUT: J401.1 (A), Module201.92 (PWR_BUT), U1002.6 (P2)
/Power Multiplexers/A_3V3_MAIN_~EN: R1015.2, R1016.1, R1019.2, U1002.12 (P7), U1003.3 (~CE)
/Power Multiplexers/A_5V_MAIN_~EN: R1017.2, R1018.1, R1020.2, U1002.4 (P8), U1004.3 (~CE)
/Power Multiplexers/A_ADD0: R1003.2, R1004.1, U1002.1 (A0)
/Power Multiplexers/A_ADD1: R1005.2, R1006.1, U1002.2 (A1)
/Power Multiplexers/A_P03: R1014.2, U1002.7 (P3)
/Power Multiplexers/A_SCL: R1008.2, R1011.1, U1002.14 (SCL)
/Power Multiplexers/A_SDA: R1007.2, R1010.1, U1002.15 (SDA)
/Power Multiplexers/A_VCC: C1001.1, C1003.1, R1003.1, R1005.1, R1013.1, U1001.2 (VOUT), U1001.7 (VOUT), U1002.16 (VCC)
/SCL: Module201.56 (GPIO3), U901.9 (SCL), U902.9 (SCL), U903.19 (H_SCL/SCK/RX)
/SDA: Module201.58 (GPIO2), U901.8 (SDA), U902.8 (SDA), U903.20 (H_SDA/H_POCI/TX)
/Sensors/CUR_1_ADD0: JP903.2 (C), U901.5 (A0)
/Sensors/CUR_1_ADD1: JP904.2 (C), U901.4 (A1)
/Sensors/CUR_2_ADD0: JP901.2 (C), U902.5 (A0)
/Sensors/CUR_2_ADD1: JP902.2 (C), U902.4 (A1)
/Sensors/ENV_SCL: R902.1, U903.15 (ENV_SCL)
/Sensors/ENV_SDA: R901.1, U903.16 (ENV_SDA)
/Sensors/IMU_32kHz: U903.27 (XIN32), U904.3 (Out)
/Sensors/IMU_ADD: JP905.2 (C), U903.17 (SA0/H_PICO)
/bacBus Connectors/3A: J1101.4, J1102.3
/bacBus Connectors/5A: J1101.6, J1102.5
/bacBus Connectors/7A: J1101.8, J1102.7
/bacBus Connectors/10A: J1101.9, J1102.10
/bacBus Connectors/11A: J1101.12, J1102.11
/bacBus Connectors/12A: J1101.11, J1102.12
/bacBus Connectors/13A: J1101.14, J1102.13
/bacBus Connectors/19A: J1101.20, J1102.19
/bacBus Connectors/21A: J1101.22, J1102.21
/bacBus Connectors/22A: J1101.21, J1102.22
/bacBus Connectors/23A: J1101.24, J1102.23
/bacBus Connectors/24A: J1101.23, J1102.24
/bacBus Connectors/25A: J1101.26, J1102.25
/bacBus Connectors/26A: J1101.25, J1102.26
/bacBus Connectors/27A: J1101.28, J1102.27
/bacBus Connectors/28A: J1101.27, J1102.28
/bacBus Connectors/29A: J1101.30, J1102.29
/bacBus Connectors/30A: J1101.29, J1102.30
/bacBus Connectors/31A: J1101.32, J1102.31
/bacBus Connectors/32A: J1101.31, J1102.32
/bacBus Connectors/33A: J1101.34, J1102.33
/bacBus Connectors/35A: J1101.36, J1102.35
/bacBus Connectors/37A: J1101.38, J1102.37
/bacBus Connectors/39A: J1101.40, J1102.39
/bacBus Connectors/41A: J1101.42, J1102.41
/bacBus Connectors/43A: J1101.44, J1102.43
/bacBus Connectors/45A: J1101.46, J1102.45
/~INT: Module201.30 (GPIO6), U901.7 (ALERT), U902.7 (ALERT), U903.14 (H_INTN)
GND: C101.2, C102.2, C504.2, C801.2, C802.2, C803.2, C804.2, C805.2, C806.2, C807.2, C808.2, C901.2, C903.2, C904.2, C905.2, C906.2, C907.2, C908.1, C909.2, C1001.2, C1003.2, C1004.2, C1005.2, C1006.2, C1007.2, C1008.2, C1009.2, C1010.2, D701.3 (A), D801.3 (A), H1.1, H2.1, H3.1, H4.1, J401.2 (B), J402.1 (A), J403.2 (B), J501.1 (GND), J501.3 (GND), J501.9 (GND), J501.15 (GND), J501.21 (GND), J501.27 (GND), J501.33 (GND), J501.39 (GND), J501.45 (GND), J501.51 (GND), J501.57 (GND), J501.71 (GND), J501.73 (GND), J501.75 (GND), J501.S1, J501.S2, J601.1, J601.4, J601.7, J601.10, J601.13, J601.16, J601.19, J602.1, J602.4, J602.7, J602.10, J602.13, J602.16, J602.19, J703.A1 (GND), J703.A12 (GND), J703.B1 (GND), J703.B12 (GND), J703.S1 (SHIELD), J1005.2, J1101.1, J1101.2, J1101.7, J1101.10, J1101.13, J1101.16, J1101.18, J1101.19, J1101.33, J1101.39, J1101.45, J1101.48, J1101.50, J1101.52, J1101.54, J1101.56, J1101.58, J1101.67, J1101.69, J1101.71, J1101.73, J1101.75, J1101.S1 (SHIELD), J1101.S2 (SHIELD__1), J1102.1, J1102.2, J1102.8, J1102.9, J1102.14, J1102.15, J1102.17, J1102.20, J1102.34, J1102.40, J1102.46, J1102.47, J1102.49, J1102.51, J1102.53, J1102.55, J1102.57, J1102.68, J1102.70, J1102.72, J1102.74, J1102.S1 (SHIELD), J1102.S2 (SHIELD__1), JP901.3 (B), JP902.1 (A), JP903.1 (A), JP904.1 (A), JP905.1 (A), M501.1, M502.1, Module201.1 (GND), Module201.2 (GND), Module201.7 (GND), Module201.8 (GND), Module201.13 (GND), Module201.14 (GND), Module201.22 (GND), Module201.23 (GND), Module201.32 (GND), Module201.33 (GND), Module201.42 (GND), Module201.43 (GND), Module201.52 (GND), Module201.53 (GND), Module201.59 (GND), Module201.60 (GND), Module201.65 (GND), Module201.66 (GND), Module201.71 (GND), Module201.74 (GND), Module201.98 (GND), Module202.107 (GND), Module202.108 (GND), Module202.113 (GND), Module202.114 (GND), Module202.119 (GND), Module202.120 (GND), Module202.125 (GND), Module202.126 (GND), Module202.131 (GND), Module202.132 (GND), Module202.137 (GND), Module202.138 (GND), Module202.144 (GND), Module202.150 (GND), Module202.153 (HDMI0_HOTPLUG), Module202.155 (GND), Module202.156 (GND), Module202.161 (GND), Module202.162 (GND), Module202.167 (GND), Module202.168 (GND), Module202.173 (GND), Module202.174 (GND), Module202.179 (GND), Module202.180 (GND), Module202.185 (GND), Module202.186 (GND), Module202.191 (GND), Module202.192 (GND), Module202.197 (GND), Module202.198 (GND), R102.1, R701.2, R1002.2, R1004.2, R1006.2, R1016.2, R1018.2, TP403.1, U301.3 (GND), U301.8 (GND), U503.2 (GND), U801.2 (GND), U802.22 (VSS), U802.24 (GND), U901.6 (GND), U901.11 (GND), U902.6 (GND), U902.11 (GND), U903.2 (GND), U903.5 (PS1), U903.6 (PS0/WAKE), U903.25 (GND), U904.2 (GND), U1001.1 (GND), U1002.8 (GND), U1003.2 (GND), U1004.2 (GND)
unnamed: C803.1, R802.2
unnamed: C805.1, R803.2
unnamed: C1002.1, R1013.2
unnamed: D401.3, D401.4, R401.2
unnamed: J501.10 (DAS/~DSS/~LED1), TP501.1
unnamed: J501.68 (SUSCLK), U503.3 (Out)
unnamed: U801.3 (OUT), U802.21 (OSC1)
unnamed: U802.16 (RXCAN), U802.28 (RXD)
unnamed: U802.15 (TXCAN), U802.23 (TXD)
unnamed: C908.2, U903.9 (CAP)
unnamed: R1001.2, R1002.1, U1001.4 (PR1)
unnamed: TP-PWR_MUX_3V3_MAIN_A_ST1001.1, U1003.5 (ST)
unnamed: TP-PWR_MUX_5V_MAIN_A_ST1001.1, U1004.5 (ST)
