Dodokamel2005/EPS-/bac-hardware/mcu/micromod-main-board/usb-adapter/design/bac-mcu-micromod-main-board-usb-adapter-v1.kicad_pcb

## KiCad design bac-hardware/mcu/micromod-main-board/usb-adapter/design/bac-mcu-micromod-main-board-usb-adapter-v1.kicad_pcb (2025-06-12)

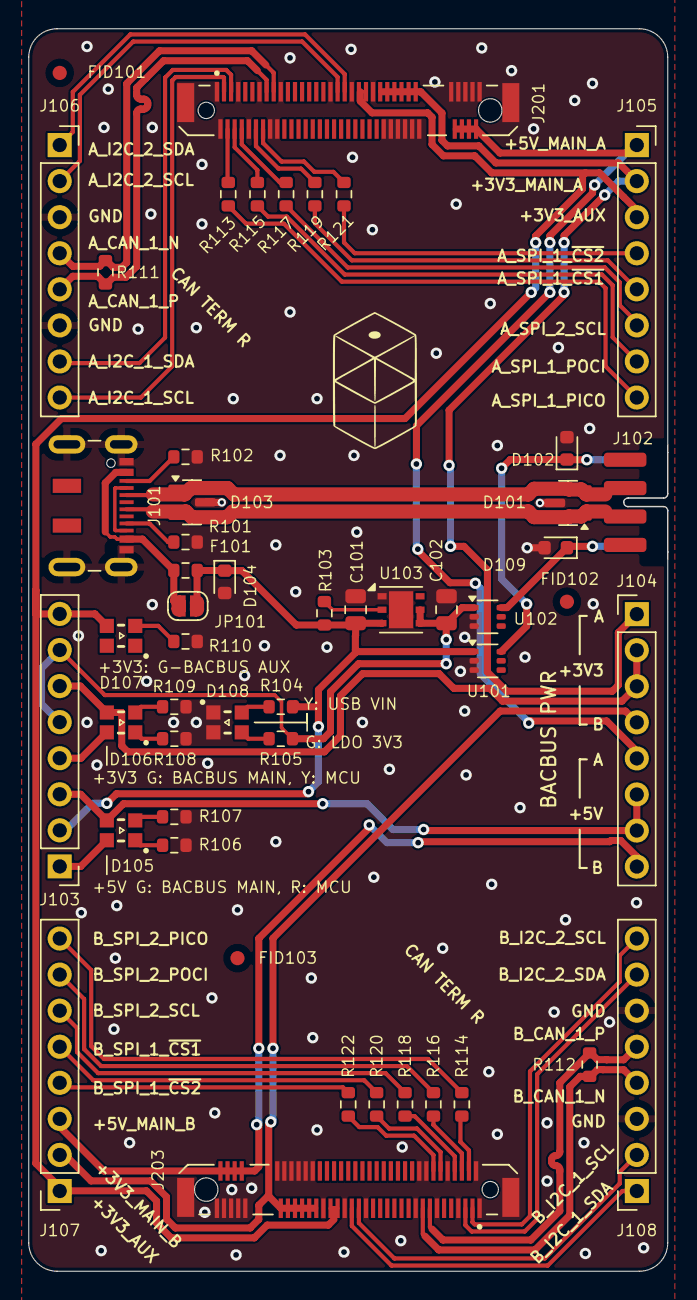
[picture p84: board bac-mcu-micromod-main-board-usb-adapter-v1.kicad_pcb from above]

Board: 2 copper layers, 45.0 x 87.5 mm, 51 parts (0 on the bottom side), 59 nets.

Parts:
C101, C102: 10u; C_0805_2012Metric
D101, D103: TI ESD752; SOT-23
D102, D104, D109: ESD751; D_0603_1608Metric
D105, D106, D107, D108: WE 150080SG54050; WE-150080XX54050
F101: 0603L200SL-VYR; R_0603_1608Metric
FID101, FID102, FID103: Fiducial; Fiducial_1mm_Mask2mm
J101: USB_C_Receptacle_USB2.0_14P; JAE-DX07S016JA1R1500
J102: Conn_02x04_Top_Bottom; bac-KYO-00-9159-BTB
J103, J104: Conn_01x08_Pin; PinHeader_1x08_P2.54mm_Vertical
J105, J106, J107, J108: Conn_01x08_Socket; PinSocket_1x08_P2.54mm_Vertical
J201: AMP MDT350M01001VT; AMP-MDT350M01001VT
J203: BMP MDT350M01001VT; AMP-MDT350M01001VT
JP101: SolderJumper_2_Open; SolderJumper-2_P1.3mm_Open_RoundedPad1.0x1.5mm
R101, R102, R103: 5k1; R_0603_1608Metric
R104, R105, R106, R107, R108, R109, R110, R111, R112: 120; R_0603_1608Metric
R113, R114, R117, R118, R119, R120, R121, R122: R0; R_0603_1608Metric
R115, R116: 10; R_0603_1608Metric
U101, U102: LM66100DCK; SOT-363_SC-70-6
U103: LDO40LPU33RY; DFN-6-1EP_3x3mm_P0.95mm_EP1.7x2.6mm

Connections:
+3V3: C102.1, J103.5, J103.7, R105.1, U102.1 (VIN), U103.4 (VOUT), U103.5 (SENSE)
/3V3_OUT: D109.1 (K), J102.8, U102.6 (VOUT)
/5V_OUT: D102.1 (K), J102.5, U101.6 (VOUT)
/D+: D101.1 (K), D103.2 (K), J101.B6 (D+), J102.3
/D-: D101.2 (K), D103.1 (K), J101.B7 (D-), J102.2
/MAMOD_+3V3_AUX: D107.3, J103.8, J105.3, J107.1, J201.41, J201.43, J203.41, J203.43
/MAMOD_+3V3_MAIN: D106.3, J103.6, J104.2, J104.3
/MAMOD_+3V3_MAIN_A: J104.1, J105.2, J201.47, J201.49, J201.51, J201.53, J201.55, J201.57
/MAMOD_+3V3_MAIN_B: J104.4, J107.2, J203.47, J203.49, J203.51, J203.53, J203.55, J203.57
/MAMOD_+5V_MAIN: D105.3, J103.3, J104.6, J104.7
/MAMOD_+5V_MAIN_A: J104.5, J105.1, J201.68, J201.70, J201.72, J201.74
/MAMOD_+5V_MAIN_B: J104.8, J107.3, J203.68, J203.70, J203.72, J203.74
/MAMOD_A_CAN_1_N: J106.4, J201.17, R111.2
/MAMOD_A_CAN_1_P: J106.5, J201.15, R111.1
/MAMOD_A_I2C_1_SCL: J106.8, J201.3
/MAMOD_A_I2C_1_SDA: J106.7, J201.5
/MAMOD_A_I2C_2_SCL: J106.2, J201.35
/MAMOD_A_I2C_2_SDA: J106.1, J201.37
/MAMOD_A_SPI_1_~CS_1: J105.5, R119.1
/MAMOD_A_SPI_1_~CS_2: J105.4, R121.1
/MAMOD_B_CAN_1_N: J108.4, J203.17, R112.2
/MAMOD_B_CAN_1_P: J108.5, J203.15, R112.1
/MAMOD_B_I2C_1_SCL: J108.8, J203.3
/MAMOD_B_I2C_1_SDA: J108.7, J203.5
/MAMOD_B_I2C_2_SCL: J108.2, J203.35
/MAMOD_B_I2C_2_SDA: J108.1, J203.37
/MAMOD_B_SPI_1_~CS_1: J107.5, R120.1
/MAMOD_B_SPI_1_~CS_2: J107.4, R122.1
/MCU_+3V3: D106.4, J103.4
/MCU_+5V: D105.4, J103.1
/SPI_1_PICO: J105.8, R113.1
/SPI_1_POCI: J105.7, R115.1
/SPI_1_SCL: J105.6, R117.1
/SPI_2_PICO: J107.8, R114.1
/SPI_2_POCI: J107.7, R116.1
/SPI_2_SCL: J107.6, R118.1
/bacBus Connectors/3A: J201.4, R113.2
/bacBus Connectors/3B: J203.4, R114.2
/bacBus Connectors/5A: J201.6, R115.2
/bacBus Connectors/5B: J203.6, R116.2
/bacBus Connectors/7A: J201.8, R117.2
/bacBus Connectors/7B: J203.8, R118.2
/bacBus Connectors/11A: J201.12, R119.2
/bacBus Connectors/11B: J203.12, R120.2
/bacBus Connectors/13A: J201.14, R121.2
/bacBus Connectors/13B: J203.14, R122.2
GND: C101.2, C102.2, D101.3 (A), D102.2 (A), D103.3 (A), D104.2 (A), D108.1, D108.2, D109.2 (A), J101.A1 (GND), J101.A12 (GND), J101.B1 (GND), J101.B12 (GND), J101.S1 (SHIELD), J102.6, J102.7, J106.3, J106.6, J108.3, J108.6, J201.1, J201.2, J201.7, J201.10, J201.13, J201.16, J201.18, J201.19, J201.33, J201.39, J201.45, J201.48, J201.50, J201.52, J201.54, J201.56, J201.58, J201.67, J201.69, J201.71, J201.73, J201.75, J201.S1 (SHIELD), J201.S2 (SHIELD__1), J203.1, J203.2, J203.7, J203.10, J203.13, J203.16, J203.18, J203.19, J203.33, J203.39, J203.45, J203.48, J203.50, J203.52, J203.54, J203.56, J203.58, J203.67, J203.69, J203.71, J203.73, J203.75, J203.S1 (SHIELD), J203.S2 (SHIELD__1), R101.2, R102.2, R106.2, R107.2, R108.2, R109.2, R110.2, U101.2 (GND), U101.3 (~CE), U102.2 (GND), U102.3 (~CE), U103.1 (GND), U103.7 (EPAD)
unnamed: D105.1, R106.1
unnamed: D105.2, R107.1
unnamed: D106.1, R108.1
unnamed: D106.2, R109.1
unnamed: D107.2, R110.1
unnamed: D108.3, R105.2
unnamed: D108.4, R104.2
unnamed: J101.A5 (CC1), R102.1
unnamed: J101.B5 (CC2), R101.1
unnamed: R103.1, U103.2 (EN)
USB_VIN: C101.1, D104.1 (K), F101.2, J103.2, JP101.2 (B), R103.2, R104.1, U101.1 (VIN), U103.3 (VIN)
VBUS: F101.1, J101.A4 (VBUS), J101.A9 (VBUS), J101.B4 (VBUS), J101.B9 (VBUS), JP101.1 (A)
