Dodokamel2005/EPS-/bac-hardware/mcu/micromod-main-board/dual-function-single-bacbus/ecad/bac-mcu-micromod-main-board-dual-function-single-bacbus-v1.kicad_sch

## KiCad design bac-hardware/mcu/micromod-main-board/dual-function-single-bacbus/ecad/bac-mcu-micromod-main-board-dual-function-single-bacbus-v1.kicad_sch (2025-06-12)

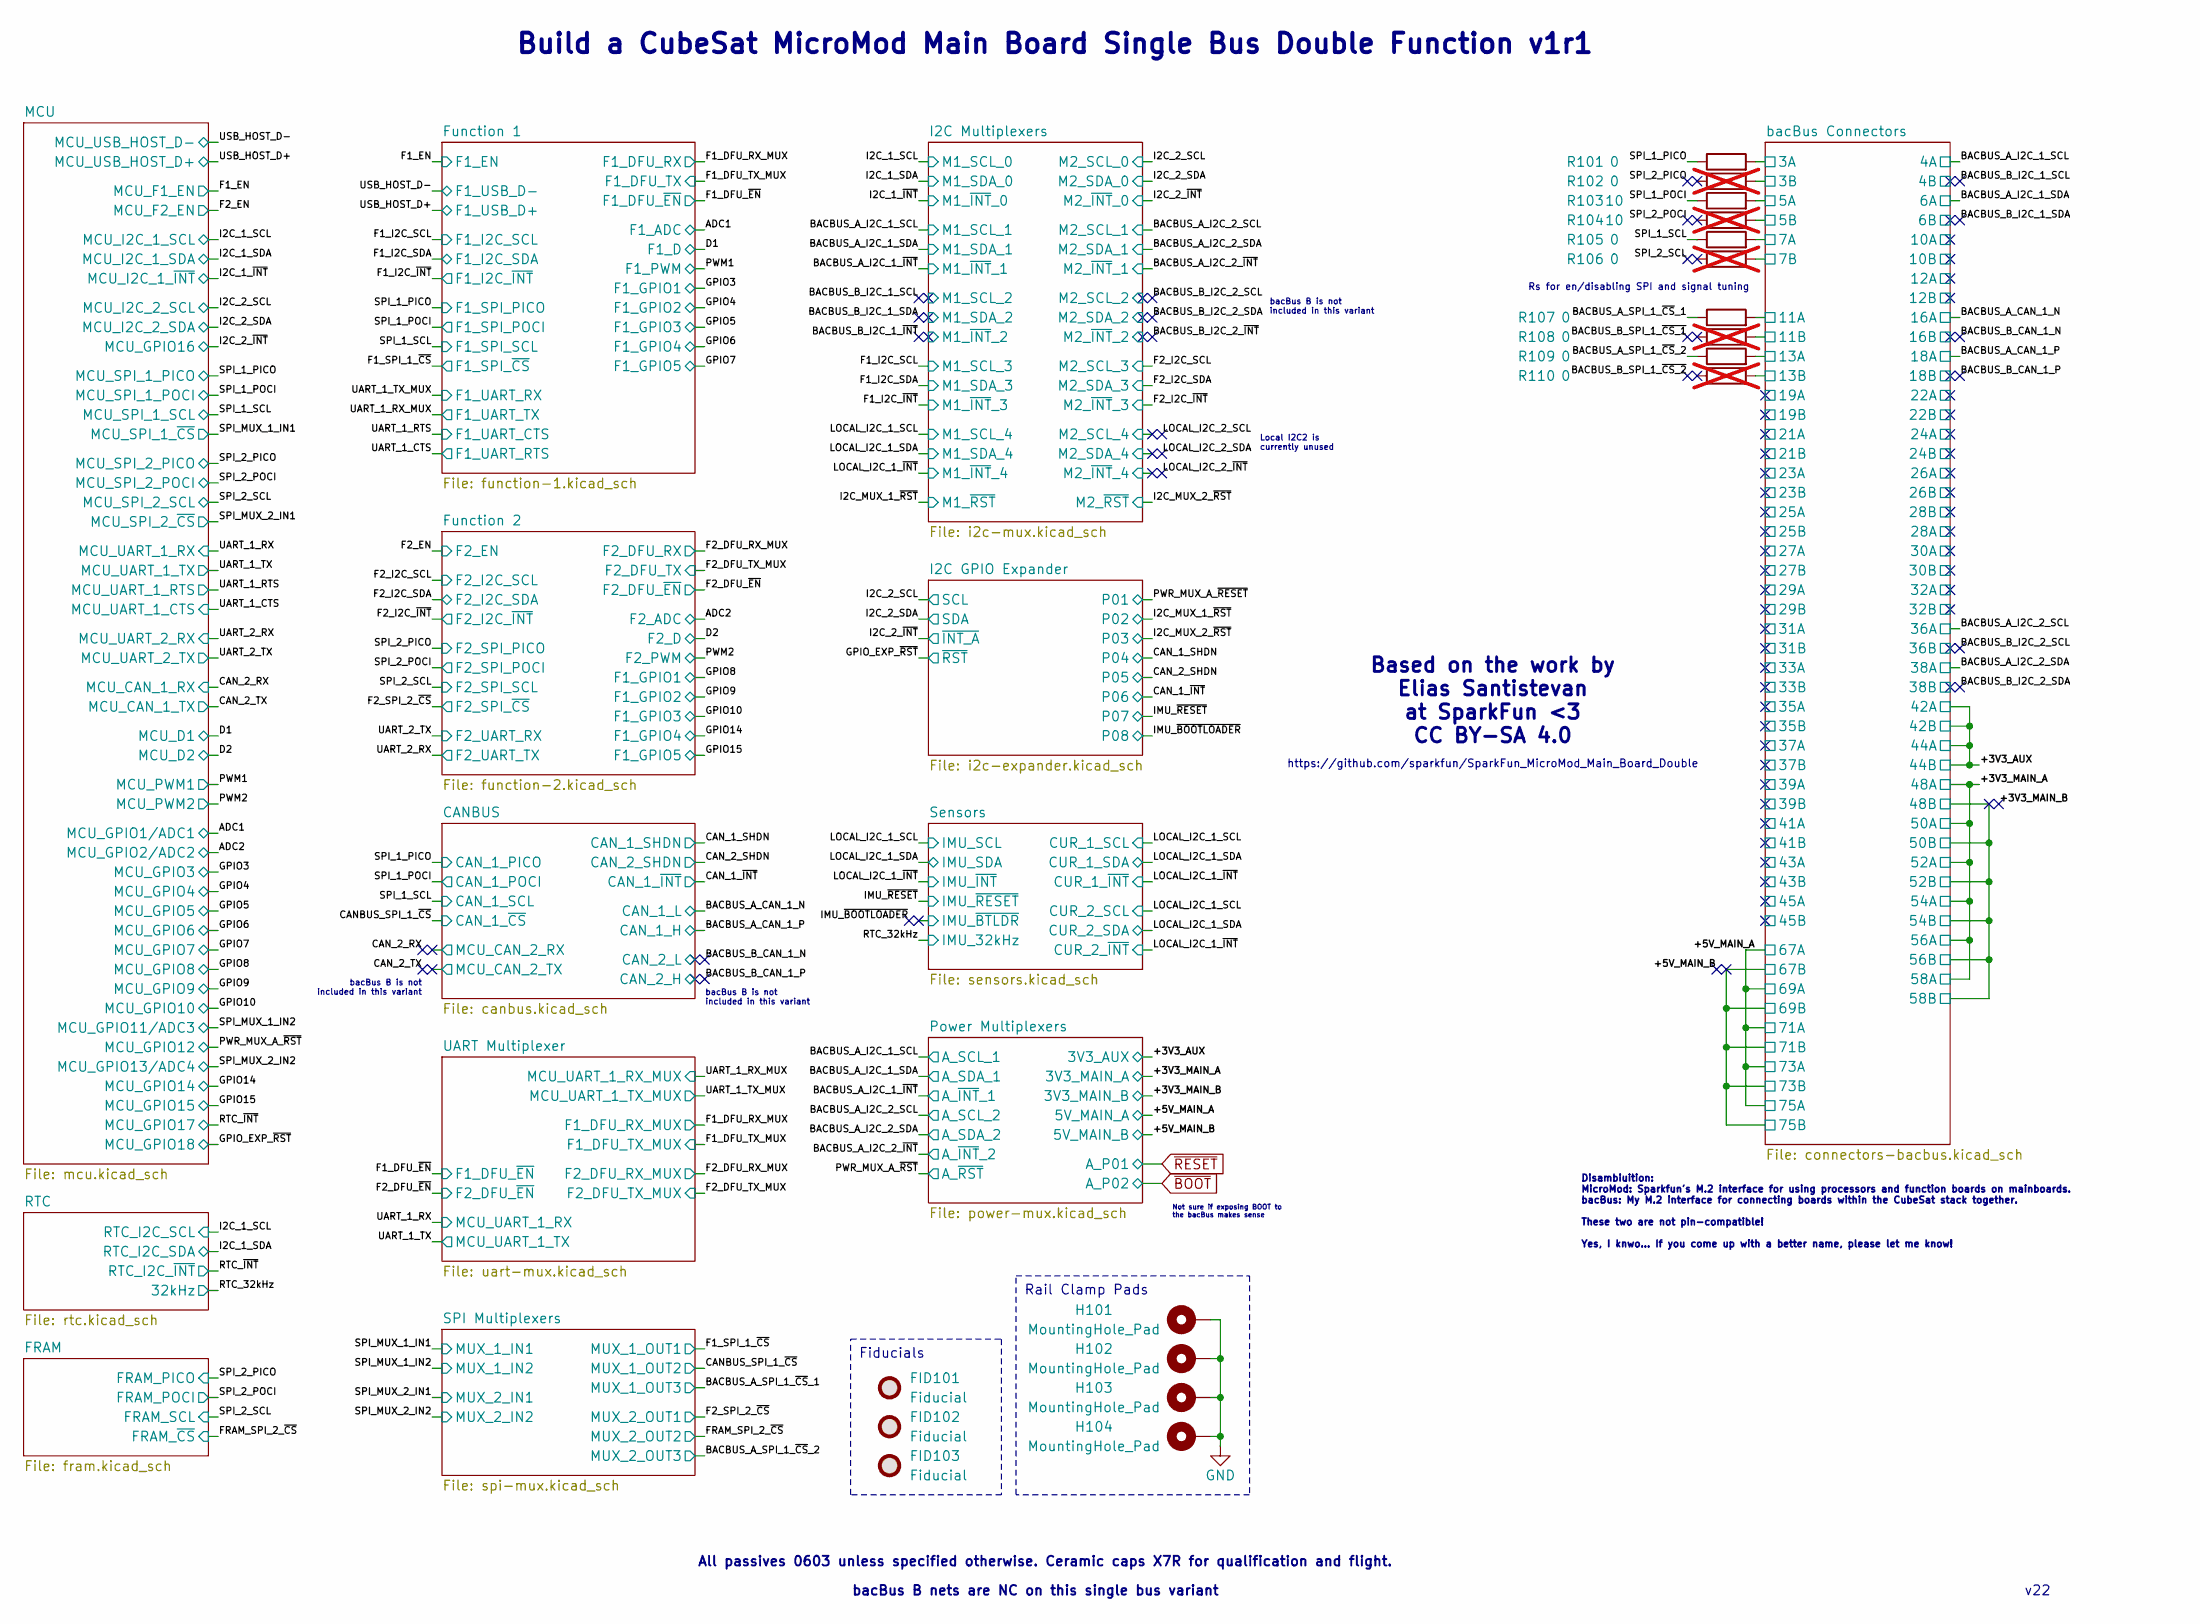
[picture p85: schematic bac-mcu-micromod-main-board-dual-function-single-bacbus-v1.kicad_sch]

Parts:
FID101, FID102, FID103: Fiducial; Fiducial_0.5mm_Mask1mm
H101, H102, H103, H104: MountingHole_Pad; bac-PCB-Rail-Pad
R101, R105, R107, R109: 0; bac-R-0603-0
R102, R106, R108, R110: 0; bac-R-0603-0; not fitted
R103: 10; bac-R-0603-10
R104: 10; bac-R-0603-10; not fitted

Connections:
3A: R101.2
3B: R102.2
5A: R103.2
5B: R104.2
7A: R105.2
7B: R106.2
11A: R107.2
11B: R108.2
13A: R109.2
13B: R110.2
BACBUS_A_SPI_1_~CS_1: R107.1
BACBUS_A_SPI_1_~CS_2: R109.1
GND: H101.1, H102.1, H103.1, H104.1
SPI_1_PICO: R101.1
SPI_1_POCI: R103.1
SPI_1_SCL: R105.1

Notes on the sheet:
Rail Clamp Pads
Fiducials
bacBus B nets are NC on this single bus variant
bacBus B is not included in this variant
All passives 0603 unless specified otherwise. Ceramic caps X7R for qualification and flight.
Rs for en/disabling SPI and signal tuning
v22
Build a CubeSat MicroMod Main Board Single Bus Double Function v1r${REVISION}
Disambiuition: MicroMod: Sparkfun's M.2 interface for using processors and function boards on mainboards. bacBus: My M.2 interface for connecting boards within the CubeSat stack together. These two are not pin-compatible! Yes, I knwo... If you come up with a better name, please let me know!
Based on the work by Elias Santistevan at SparkFun <3 CC BY-SA 4.0
Not sure if exposing BOOT to the bacBus makes sense
https://github.com/sparkfun/SparkFun_MicroMod_Main_Board_Double
Local I2C2 is currently unused
