Dodokamel2005/EPS-/bac-hardware/mcu/micromod-main-board/dual-function-single-bacbus/ecad/canbus.kicad_sch

## KiCad design bac-hardware/mcu/micromod-main-board/dual-function-single-bacbus/ecad/canbus.kicad_sch (2025-06-12)

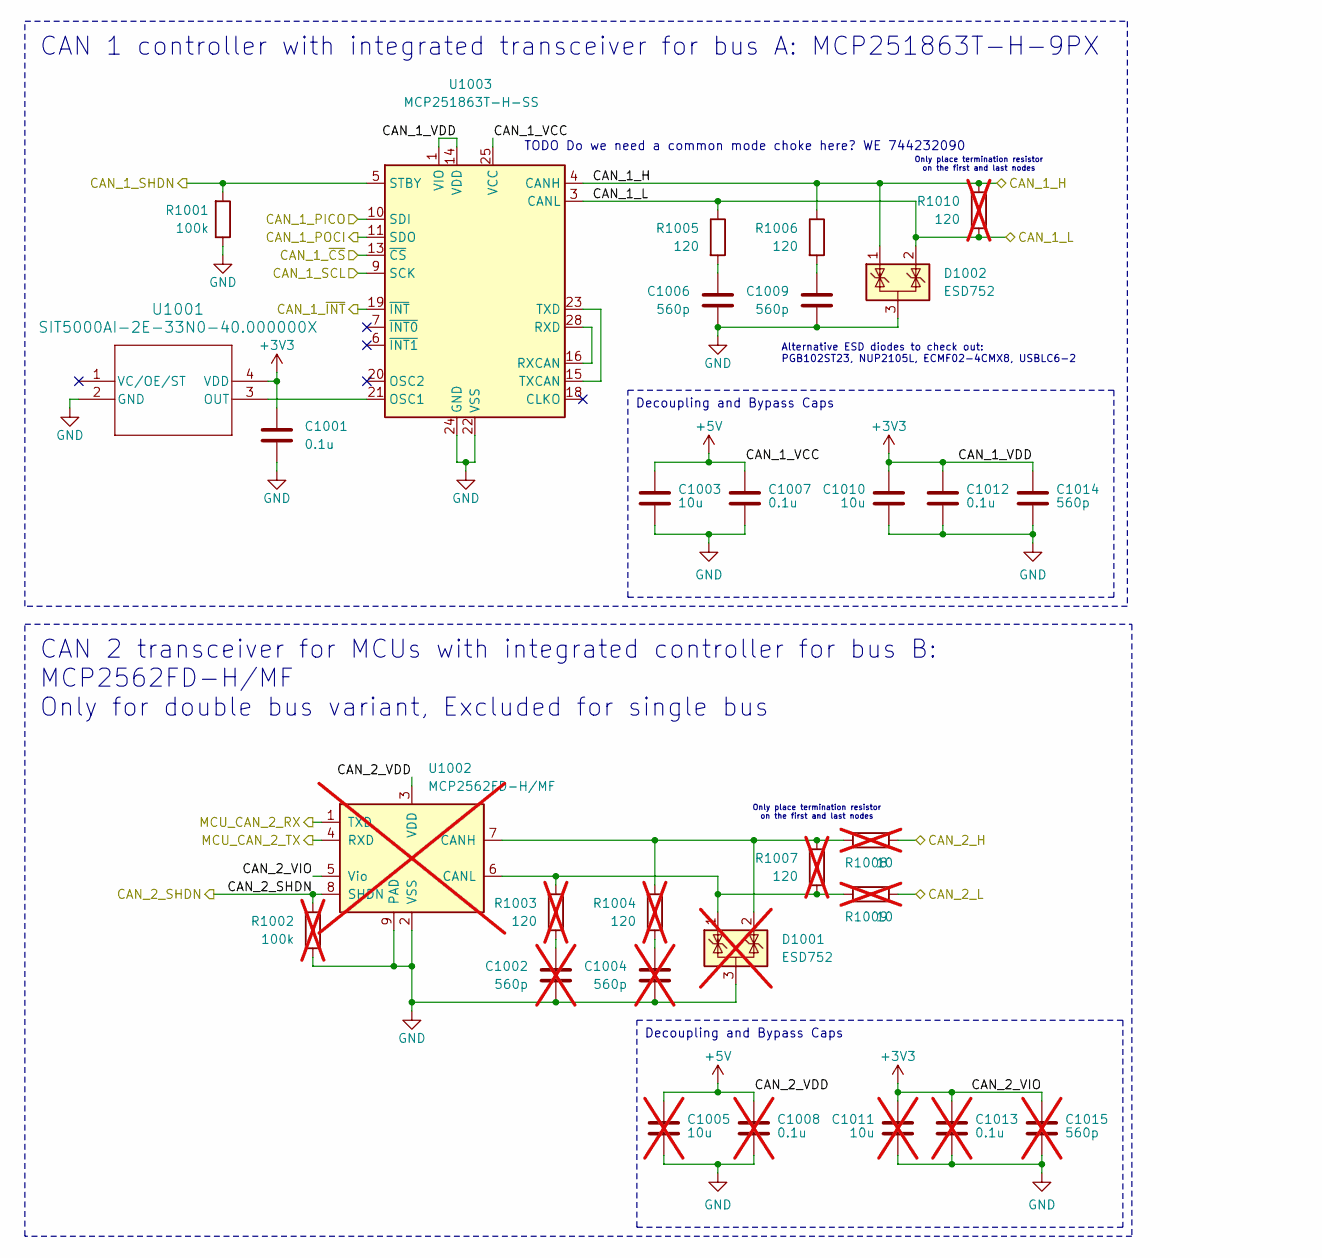
[picture p86: schematic canbus.kicad_sch]

Parts:
C1001, C1007, C1012: 0.1u; bac-C-0603-0.1u; Rated Voltage 50V
C1002, C1004, C1015: 560p; C_0603_1608Metric; Rated Voltage 50V; not fitted
C1003, C1010: 10u; bac-C-0805-10u; Rated Voltage 35V
C1005, C1011: 10u; bac-C-0805-10u; Rated Voltage 35V; not fitted
C1006, C1009, C1014: 560p; C_0603_1608Metric; Rated Voltage 50V
C1008, C1013: 0.1u; bac-C-0603-0.1u; Rated Voltage 50V; not fitted
D1001: ESD752; SOT-23; not fitted
D1002: ESD752; SOT-23
R1001: 100k; bac-R-0603-100k
R1002: 100k; bac-R-0603-100k; not fitted
R1003, R1004, R1007, R1010: 120; R_0603_1608Metric; not fitted
R1005, R1006: 120; R_0603_1608Metric
R1008, R1009: 10; bac-R-0603-10; not fitted
U1001: SIT5000AI-2E-33N0-40.000000X; SIT-SIT5000AI-2E-33N0
U1002: MCP2562FD-H/MF; DFN-8-1EP_3x3mm_P0.65mm_EP1.55x2.4mm; not fitted
U1003: MCP251863T-H-SS; MT-MCP251863T-H-SS

Connections:
+3V3: C1001.1, C1010.1, C1011.1, C1012.1, C1013.1, C1014.1, C1015.1, U1001.4 (VDD), U1002.5 (Vio), U1003.1 (VIO), U1003.14 (VDD)
+5V: C1003.1, C1005.1, C1007.1, C1008.1, U1002.3 (VDD), U1003.25 (VCC)
CAN_1_H: D1002.1 (K), R1006.1, R1010.1, U1003.4 (CANH)
CAN_1_L: D1002.2 (K), R1005.1, R1010.2, U1003.3 (CANL)
CAN_1_PICO: U1003.10 (SDI)
CAN_1_POCI: U1003.11 (SDO)
CAN_1_SCL: U1003.9 (SCK)
CAN_1_SHDN: R1001.2, U1003.5 (STBY)
CAN_1_~CS: U1003.13 (~CS)
CAN_1_~INT: U1003.19 (~INT)
CAN_2_H: R1008.2
CAN_2_L: R1009.2
CAN_2_SHDN: R1002.1, U1002.8 (SHDN)
GND: C1001.2, C1002.2, C1003.2, C1004.2, C1005.2, C1006.2, C1007.2, C1008.2, C1009.2, C1010.2, C1011.2, C1012.2, C1013.2, C1014.2, C1015.2, D1001.3 (A), D1002.3 (A), R1001.1, R1002.2, U1001.2 (GND), U1002.2 (VSS), U1002.9 (PAD), U1003.22 (VSS), U1003.24 (GND)
MCU_CAN_2_RX: U1002.1 (TXD)
MCU_CAN_2_TX: U1002.4 (RXD)
unnamed: C1002.1, R1003.2
unnamed: C1004.1, R1004.2
unnamed: C1006.1, R1005.2
unnamed: C1009.1, R1006.2
unnamed: D1001.1 (K), R1003.1, R1007.2, R1009.1, U1002.6 (CANL)
unnamed: D1001.2 (K), R1004.1, R1007.1, R1008.1, U1002.7 (CANH)
unnamed: U1001.3 (OUT), U1003.21 (OSC1)
unnamed: U1003.15 (TXCAN), U1003.23 (TXD)
unnamed: U1003.16 (RXCAN), U1003.28 (RXD)

Notes on the sheet:
CAN 1 controller with integrated transceiver for bus A: MCP251863T-H-9PX
Decoupling and Bypass Caps
CAN 2 transceiver for MCUs with integrated controller for bus B: MCP2562FD-H/MF Only for double bus variant, Excluded for single bus
Only place termination resistor on the first and last nodes
TODO Do we need a common mode choke here? WE 744232090
Alternative ESD diodes to check out: PGB102ST23, NUP2105L, ECMF02-4CMX8, USBLC6-2
