Dodokamel2005/EPS-/bac-hardware/mcu/micromod-main-board/dual-function-single-bacbus/ecad/connectors-bacbus.kicad_sch

## KiCad design bac-hardware/mcu/micromod-main-board/dual-function-single-bacbus/ecad/connectors-bacbus.kicad_sch (2025-06-12)

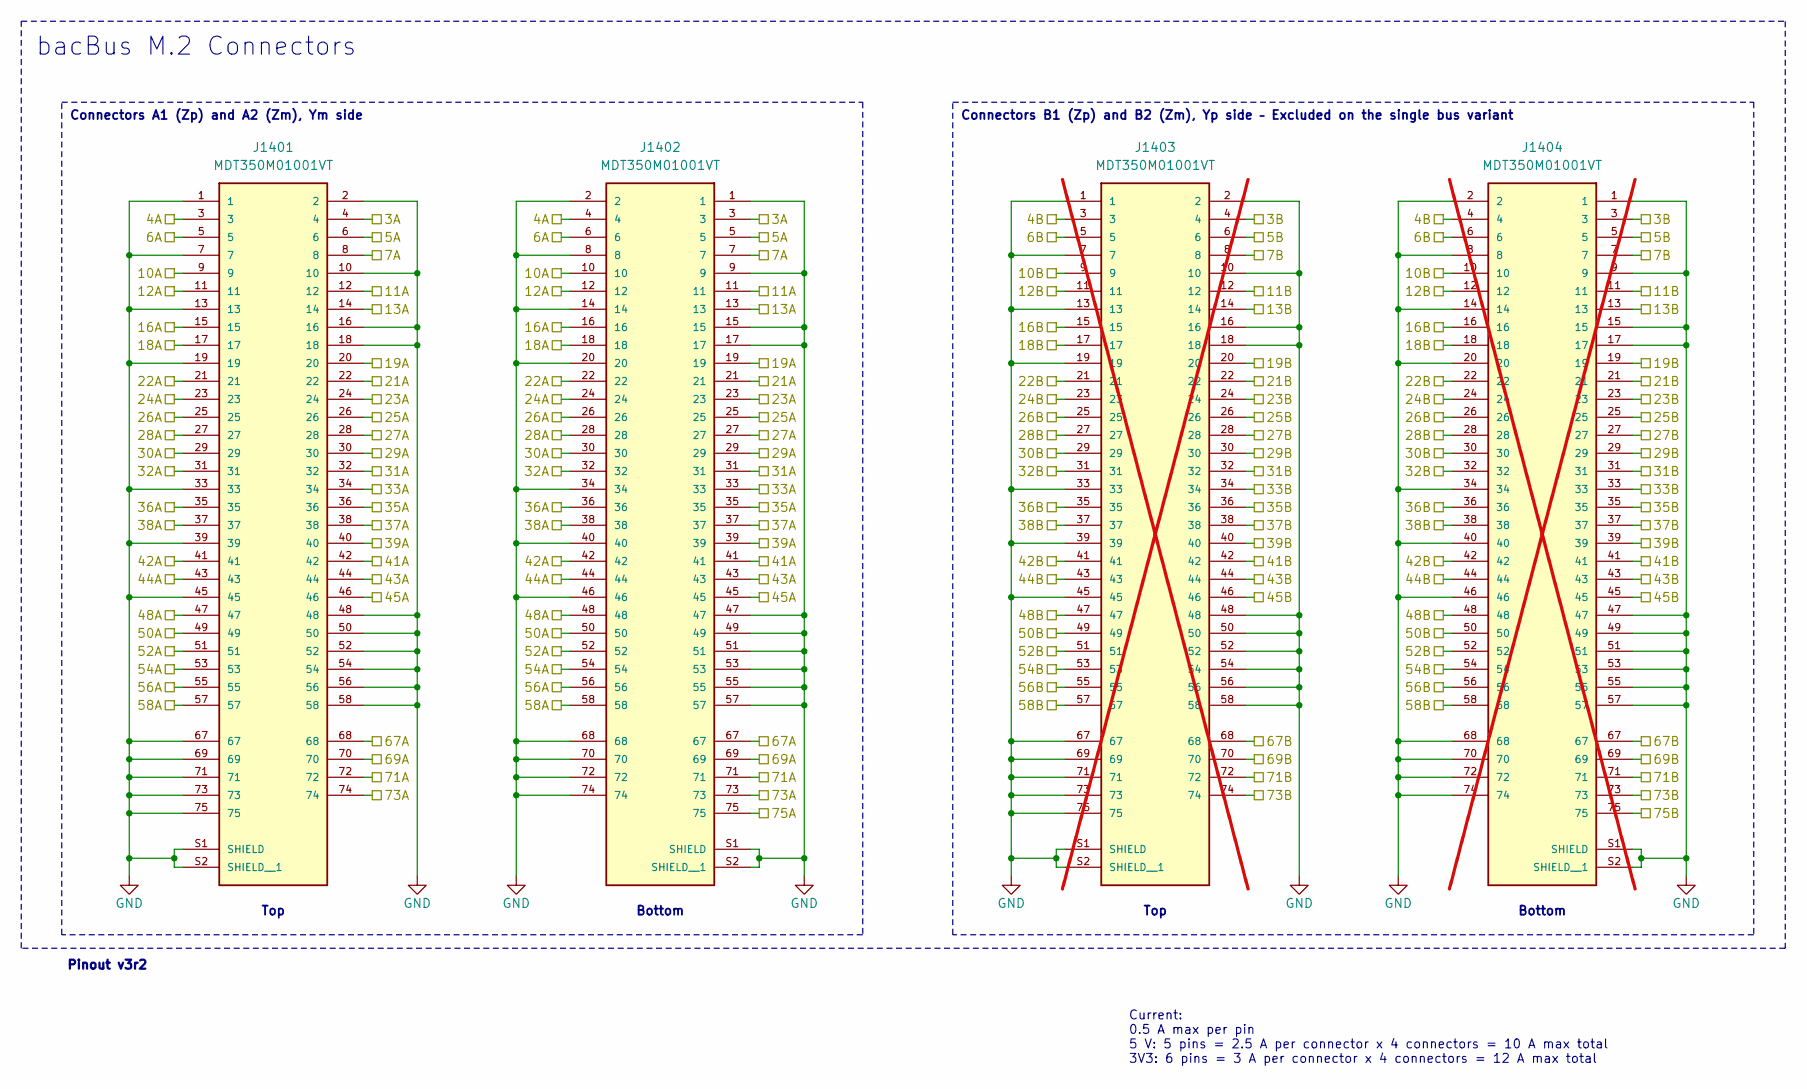
[picture p87: schematic connectors-bacbus.kicad_sch]

Parts:
J1401, J1402: MDT350M01001VT; AMP-MDT350M01001VT
J1403, J1404: MDT350M01001VT; AMP-MDT350M01001VT; not fitted

Connections:
3A: J1401.4, J1402.3
3B: J1403.4, J1404.3
4A: J1401.3, J1402.4
4B: J1403.3, J1404.4
5A: J1401.6, J1402.5
5B: J1403.6, J1404.5
6A: J1401.5, J1402.6
6B: J1403.5, J1404.6
7A: J1401.8, J1402.7
7B: J1403.8, J1404.7
10A: J1401.9, J1402.10
10B: J1403.9, J1404.10
11A: J1401.12, J1402.11
11B: J1403.12, J1404.11
12A: J1401.11, J1402.12
12B: J1403.11, J1404.12
13A: J1401.14, J1402.13
13B: J1403.14, J1404.13
16A: J1401.15, J1402.16
16B: J1403.15, J1404.16
18A: J1401.17, J1402.18
18B: J1403.17, J1404.18
19A: J1401.20, J1402.19
19B: J1403.20, J1404.19
21A: J1401.22, J1402.21
21B: J1403.22, J1404.21
22A: J1401.21, J1402.22
22B: J1403.21, J1404.22
23A: J1401.24, J1402.23
23B: J1403.24, J1404.23
24A: J1401.23, J1402.24
24B: J1403.23, J1404.24
25A: J1401.26, J1402.25
25B: J1403.26, J1404.25
26A: J1401.25, J1402.26
26B: J1403.25, J1404.26
27A: J1401.28, J1402.27
27B: J1403.28, J1404.27
28A: J1401.27, J1402.28
28B: J1403.27, J1404.28
29A: J1401.30, J1402.29
29B: J1403.30, J1404.29
30A: J1401.29, J1402.30
30B: J1403.29, J1404.30
31A: J1401.32, J1402.31
31B: J1403.32, J1404.31
32A: J1401.31, J1402.32
32B: J1403.31, J1404.32
33A: J1401.34, J1402.33
33B: J1403.34, J1404.33
35A: J1401.36, J1402.35
35B: J1403.36, J1404.35
36A: J1401.35, J1402.36
36B: J1403.35, J1404.36
37A: J1401.38, J1402.37
37B: J1403.38, J1404.37
38A: J1401.37, J1402.38
38B: J1403.37, J1404.38
39A: J1401.40, J1402.39
39B: J1403.40, J1404.39
41A: J1401.42, J1402.41
41B: J1403.42, J1404.41
42A: J1401.41, J1402.42
42B: J1403.41, J1404.42
43A: J1401.44, J1402.43
43B: J1403.44, J1404.43
44A: J1401.43, J1402.44
44B: J1403.43, J1404.44
45A: J1401.46, J1402.45
45B: J1403.46, J1404.45
48A: J1401.47, J1402.48
48B: J1403.47, J1404.48
50A: J1401.49, J1402.50
50B: J1403.49, J1404.50
52A: J1401.51, J1402.52
52B: J1403.51, J1404.52
54A: J1401.53, J1402.54
54B: J1403.53, J1404.54
56A: J1401.55, J1402.56
56B: J1403.55, J1404.56
58A: J1401.57, J1402.58
58B: J1403.57, J1404.58
67A: J1401.68, J1402.67
67B: J1403.68, J1404.67
69A: J1401.70, J1402.69
69B: J1403.70, J1404.69
71A: J1401.72, J1402.71
71B: J1403.72, J1404.71
73A: J1401.74, J1402.73
73B: J1403.74, J1404.73
75A: J1402.75
75B: J1404.75
GND: J1401.1, J1401.2, J1401.7, J1401.10, J1401.13, J1401.16, J1401.18, J1401.19, J1401.33, J1401.39, J1401.45, J1401.48, J1401.50, J1401.52, J1401.54, J1401.56, J1401.58, J1401.67, J1401.69, J1401.71, J1401.73, J1401.75, J1401.S1 (SHIELD), J1401.S2 (SHIELD__1), J1402.1, J1402.2, J1402.8, J1402.9, J1402.14, J1402.15, J1402.17, J1402.20, J1402.34, J1402.40, J1402.46, J1402.47, J1402.49, J1402.51, J1402.53, J1402.55, J1402.57, J1402.68, J1402.70, J1402.72, J1402.74, J1402.S1 (SHIELD), J1402.S2 (SHIELD__1), J1403.1, J1403.2, J1403.7, J1403.10, J1403.13, J1403.16, J1403.18, J1403.19, J1403.33, J1403.39, J1403.45, J1403.48, J1403.50, J1403.52, J1403.54, J1403.56, J1403.58, J1403.67, J1403.69, J1403.71, J1403.73, J1403.75, J1403.S1 (SHIELD), J1403.S2 (SHIELD__1), J1404.1, J1404.2, J1404.8, J1404.9, J1404.14, J1404.15, J1404.17, J1404.20, J1404.34, J1404.40, J1404.46, J1404.47, J1404.49, J1404.51, J1404.53, J1404.55, J1404.57, J1404.68, J1404.70, J1404.72, J1404.74, J1404.S1 (SHIELD), J1404.S2 (SHIELD__1)

Notes on the sheet:
Connectors A1 (Zp) and A2 (Zm), Ym side
Connectors B1 (Zp) and B2 (Zm), Yp side – Excluded on the single bus variant
bacBus M.2 Connectors
Top
Bottom
Current: 0.5 A max per pin 5 V: 5 pins = 2.5 A per connector x 4 connectors = 10 A max total 3V3: 6 pins = 3 A per connector x 4 connectors = 12 A max total
Pinout v3r2
