Dodokamel2005/EPS-/bac-hardware/mcu/micromod-main-board/dual-function-single-bacbus/ecad/fram.kicad_sch

## KiCad design bac-hardware/mcu/micromod-main-board/dual-function-single-bacbus/ecad/fram.kicad_sch (2025-06-12)

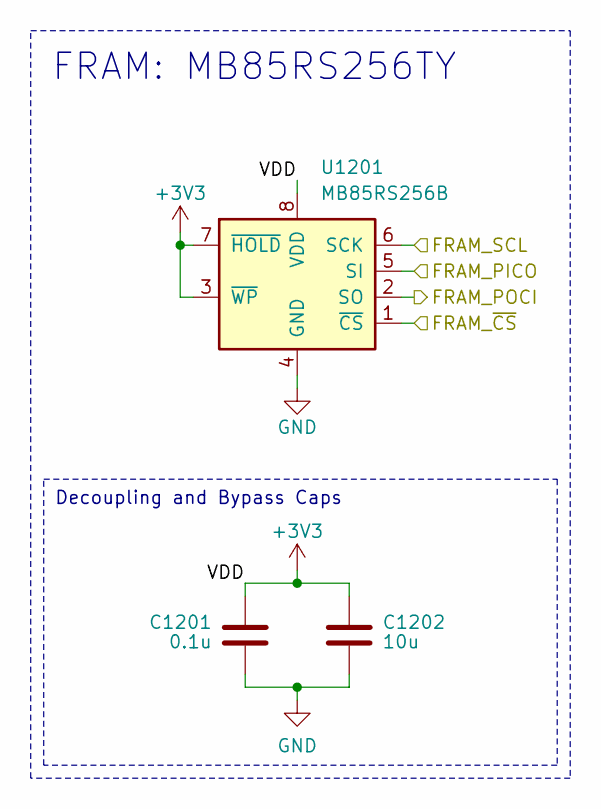
[picture p88: schematic fram.kicad_sch]

Parts:
C1201: 0.1u; bac-C-0603-0.1u; Rated Voltage 50V
C1202: 10u; bac-C-0805-10u; Rated Voltage 25V
U1201: MB85RS256B; FU-MB85RS256B

Connections:
+3V3: C1201.1, C1202.1, U1201.3 (~WP), U1201.7 (~HOLD), U1201.8 (VDD)
FRAM_PICO: U1201.5 (SI)
FRAM_POCI: U1201.2 (SO)
FRAM_SCL: U1201.6 (SCK)
FRAM_~CS: U1201.1 (~CS)
GND: C1201.2, C1202.2, U1201.4 (GND)

Notes on the sheet:
Decoupling and Bypass Caps
FRAM: MB85RS256TY
