Dodokamel2005/EPS-/bac-hardware/mcu/micromod-main-board/dual-function-single-bacbus/ecad/function-1.kicad_sch

## KiCad design bac-hardware/mcu/micromod-main-board/dual-function-single-bacbus/ecad/function-1.kicad_sch (2025-06-12)

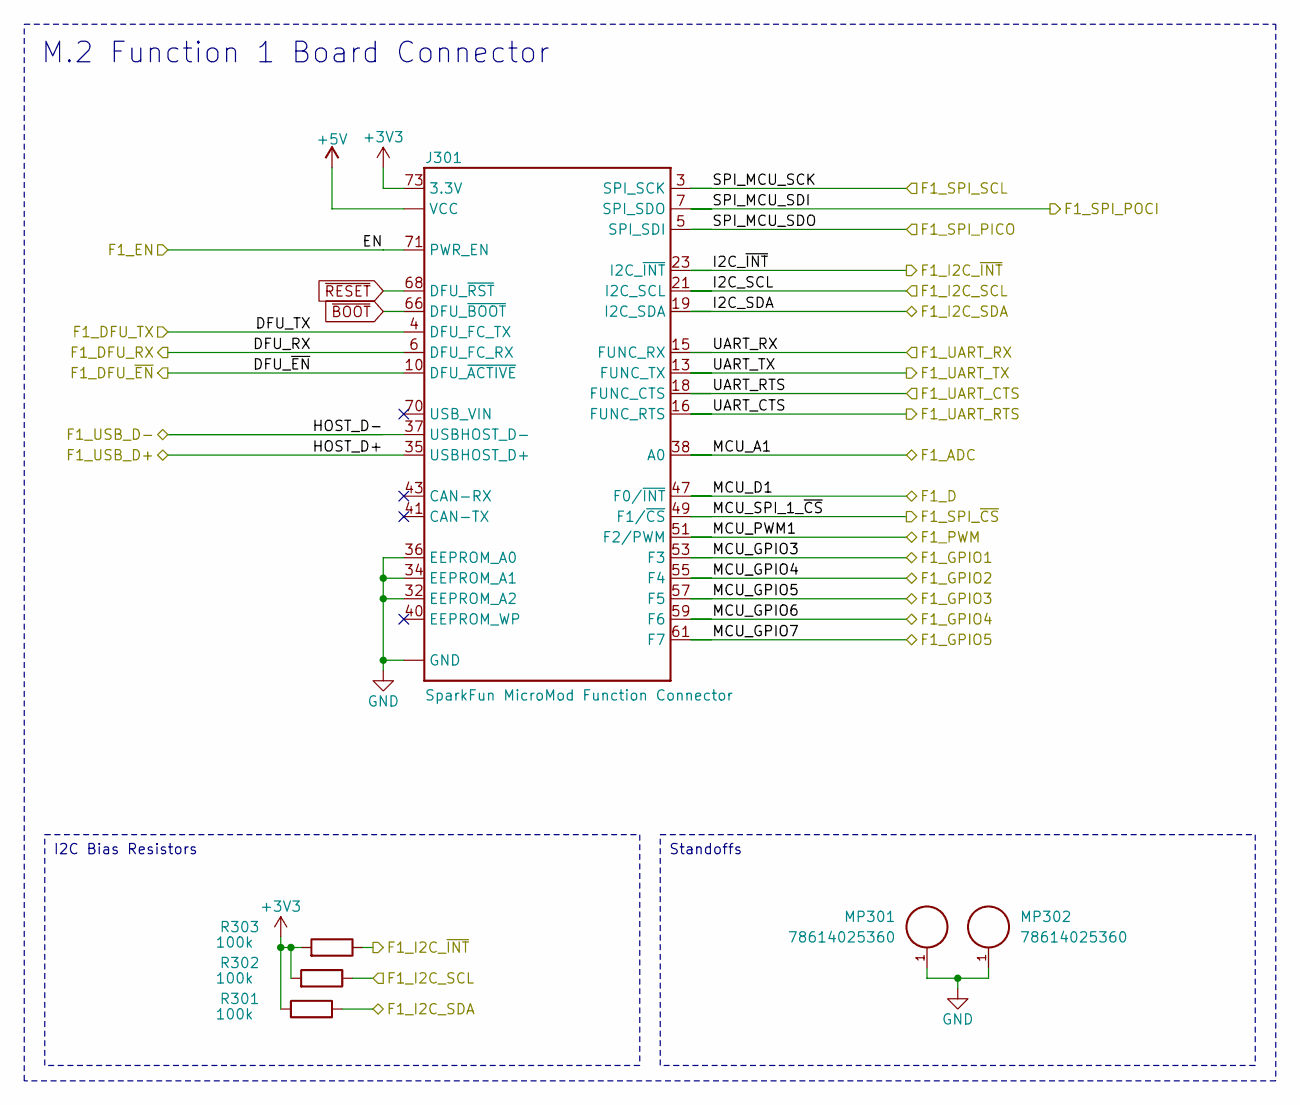
[picture p89: schematic function-1.kicad_sch]

Parts:
J301: SparkFun MicroMod Function Connector; bac-M.2-Key-E-MicroMod-Function
MP301, MP302: 78614025360; WE-9774025243R
R301, R302, R303: 100k; bac-R-0603-100k

Connections:
+3V3: J301.73 (3.3V), R301.2, R302.2, R303.2
+5V: J301.72 (VCC), J301.74 (VCC)
DFU_RX: J301.6 (DFU_FC_RX)
DFU_TX: J301.4 (DFU_FC_TX)
DFU_~EN: J301.10 (DFU_~ACTIVE)
EN: J301.71 (PWR_EN)
F1_ADC: J301.38 (A0)
F1_D: J301.47 (F0/~INT)
F1_GPIO1: J301.53 (F3)
F1_GPIO2: J301.55 (F4)
F1_GPIO3: J301.57 (F5)
F1_GPIO4: J301.59 (F6)
F1_GPIO5: J301.61 (F7)
F1_I2C_SCL: J301.21 (I2C_SCL), R302.1
F1_I2C_SDA: J301.19 (I2C_SDA), R301.1
F1_I2C_~INT: J301.23 (I2C_~INT), R303.1
F1_PWM: J301.51 (F2/PWM)
F1_SPI_PICO: J301.5 (SPI_SDI)
F1_SPI_POCI: J301.7 (SPI_SDO)
F1_SPI_SCL: J301.3 (SPI_SCK)
F1_SPI_~CS: J301.49 (F1/~CS)
F1_UART_CTS: J301.18 (FUNC_CTS)
F1_UART_RTS: J301.16 (FUNC_RTS)
F1_UART_RX: J301.15 (FUNC_RX)
F1_UART_TX: J301.13 (FUNC_TX)
F1_USB_D+: J301.35 (USBHOST_D+)
F1_USB_D-: J301.37 (USBHOST_D-)
GND: J301.1 (GND), J301.2 (GND), J301.8 (GND), J301.32 (EEPROM_A2), J301.33 (GND), J301.34 (EEPROM_A1), J301.36 (EEPROM_A0), J301.39 (GND), J301.45 (GND), J301.75 (GND), MP301.1, MP302.1
~BOOT: J301.66 (DFU_~BOOT)
~RESET: J301.68 (DFU_~RST)

Notes on the sheet:
M.2 Function 1 Board Connector
Standoffs
I2C Bias Resistors
