Dodokamel2005/EPS-/bac-hardware/mcu/micromod-main-board/dual-function-single-bacbus/ecad/function-2.kicad_sch

## KiCad design bac-hardware/mcu/micromod-main-board/dual-function-single-bacbus/ecad/function-2.kicad_sch (2025-06-12)

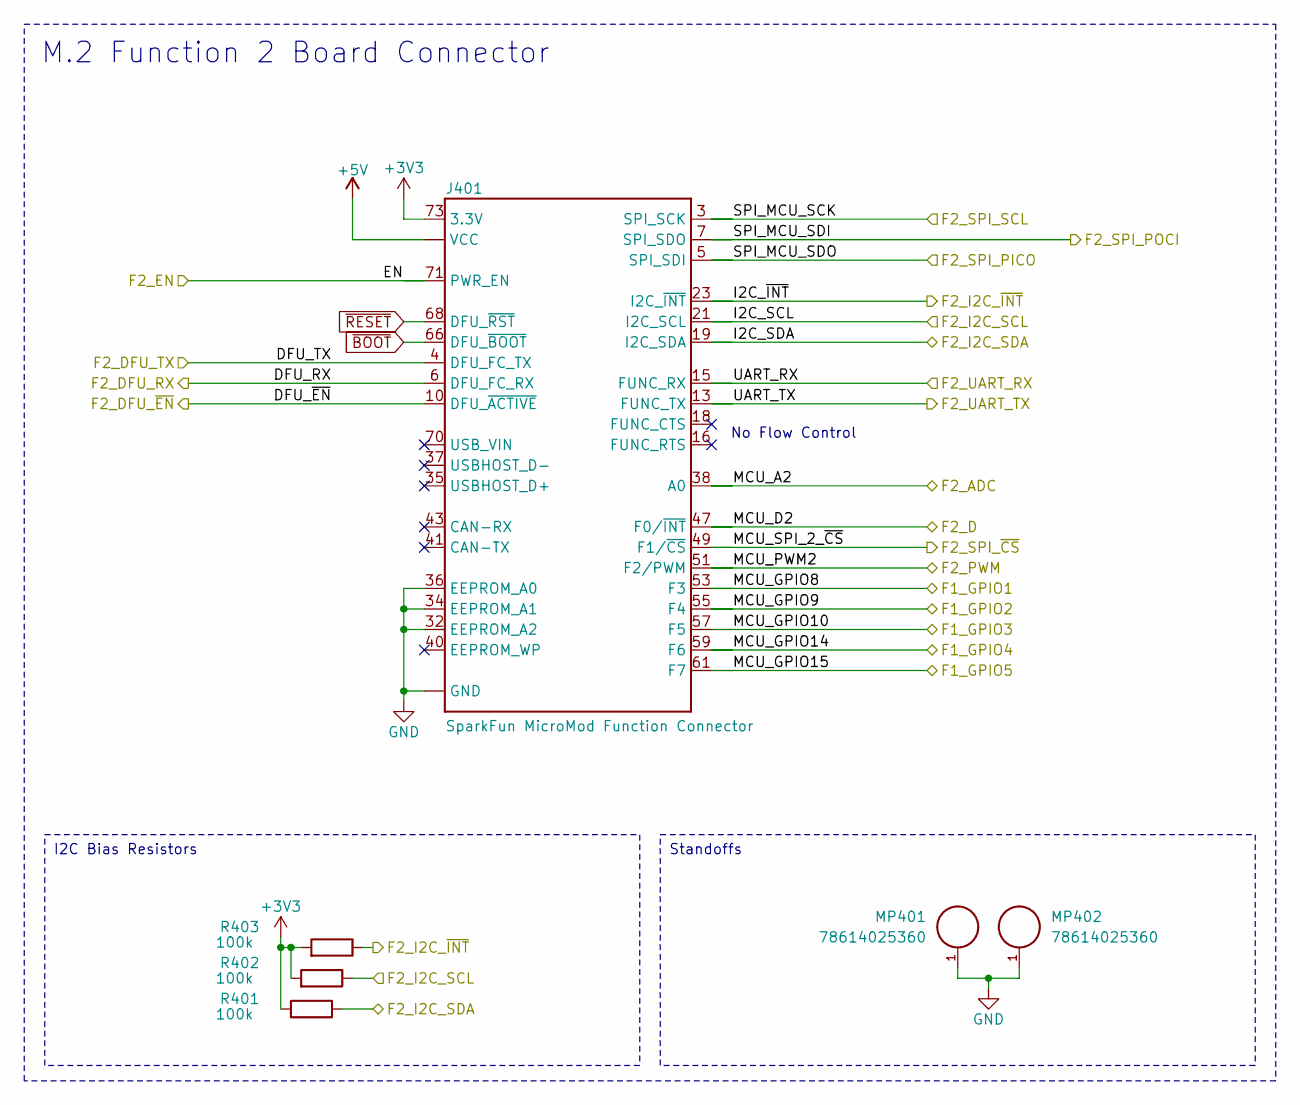
[picture p90: schematic function-2.kicad_sch]

Parts:
J401: SparkFun MicroMod Function Connector; bac-M.2-Key-E-MicroMod-Function
MP401, MP402: 78614025360; WE-9774025243R
R401, R402, R403: 100k; bac-R-0603-100k

Connections:
+3V3: J401.73 (3.3V), R401.2, R402.2, R403.2
+5V: J401.72 (VCC), J401.74 (VCC)
DFU_RX: J401.6 (DFU_FC_RX)
DFU_TX: J401.4 (DFU_FC_TX)
DFU_~EN: J401.10 (DFU_~ACTIVE)
EN: J401.71 (PWR_EN)
F1_GPIO1: J401.53 (F3)
F1_GPIO2: J401.55 (F4)
F1_GPIO3: J401.57 (F5)
F1_GPIO4: J401.59 (F6)
F1_GPIO5: J401.61 (F7)
F2_ADC: J401.38 (A0)
F2_D: J401.47 (F0/~INT)
F2_I2C_SCL: J401.21 (I2C_SCL), R402.1
F2_I2C_SDA: J401.19 (I2C_SDA), R401.1
F2_I2C_~INT: J401.23 (I2C_~INT), R403.1
F2_PWM: J401.51 (F2/PWM)
F2_SPI_PICO: J401.5 (SPI_SDI)
F2_SPI_POCI: J401.7 (SPI_SDO)
F2_SPI_SCL: J401.3 (SPI_SCK)
F2_SPI_~CS: J401.49 (F1/~CS)
F2_UART_RX: J401.15 (FUNC_RX)
F2_UART_TX: J401.13 (FUNC_TX)
GND: J401.1 (GND), J401.2 (GND), J401.8 (GND), J401.32 (EEPROM_A2), J401.33 (GND), J401.34 (EEPROM_A1), J401.36 (EEPROM_A0), J401.39 (GND), J401.45 (GND), J401.75 (GND), MP401.1, MP402.1
~BOOT: J401.66 (DFU_~BOOT)
~RESET: J401.68 (DFU_~RST)

Notes on the sheet:
M.2 Function 2 Board Connector
I2C Bias Resistors
Standoffs
No Flow Control
