Dodokamel2005/EPS-/bac-hardware/mcu/micromod-main-board/dual-function-single-bacbus/ecad/i2c-expander.kicad_sch

## KiCad design bac-hardware/mcu/micromod-main-board/dual-function-single-bacbus/ecad/i2c-expander.kicad_sch (2025-06-12)

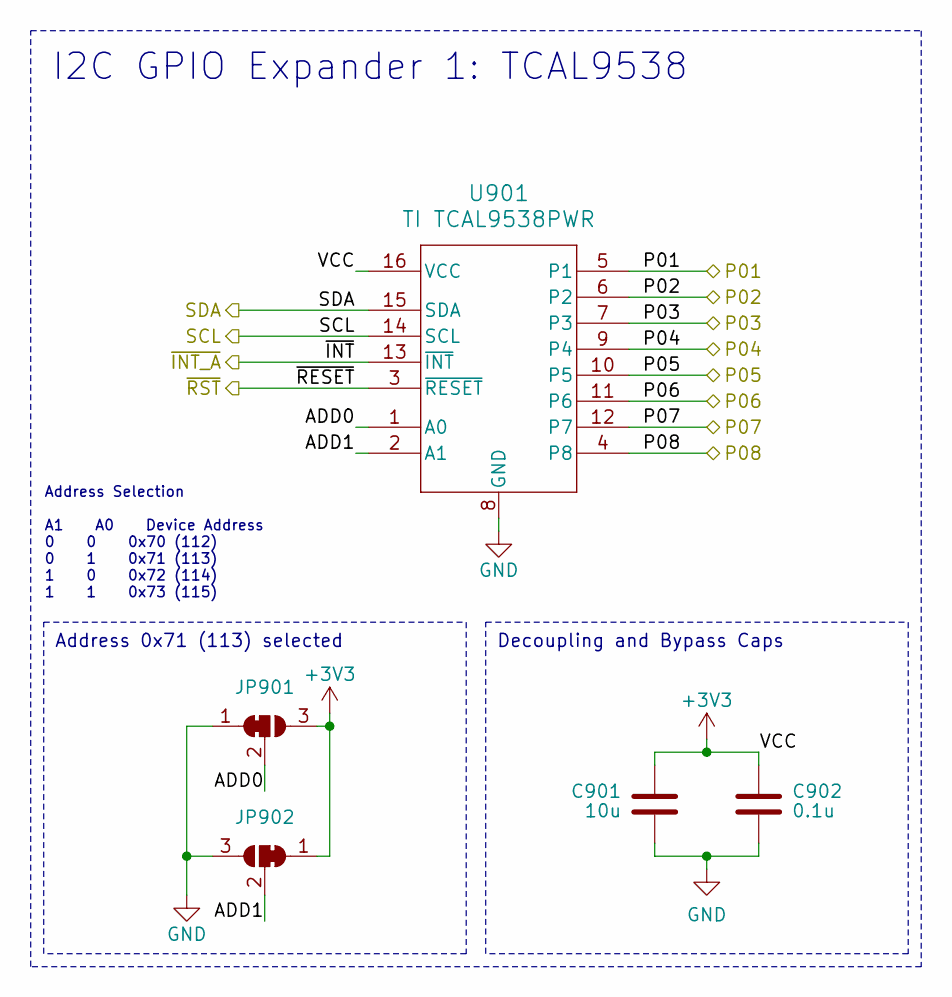
[picture p91: schematic i2c-expander.kicad_sch]

Parts:
C901: 10u; bac-C-0805-10u; Rated Voltage 35V
C902: 0.1u; bac-C-0603-0.1u; Rated Voltage 50V
JP901, JP902: SolderJumper_3_Bridged12; SolderJumper-3_P1.3mm_Bridged12_RoundedPad1.0x1.5mm_NumberL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
U901: TI TCAL9538PWR; TI-TCAL9538PWR

Connections:
+3V3: C901.1, C902.1, JP901.3 (B), JP902.1 (A), U901.16 (VCC)
ADD0: JP901.2 (C), U901.1 (A0)
ADD1: JP902.2 (C), U901.2 (A1)
GND: C901.2, C902.2, JP901.1 (A), JP902.3 (B), U901.8 (GND)
P01: U901.5 (P1)
P02: U901.6 (P2)
P03: U901.7 (P3)
P04: U901.9 (P4)
P05: U901.10 (P5)
P06: U901.11 (P6)
P07: U901.12 (P7)
P08: U901.4 (P8)
SCL: U901.14 (SCL)
SDA: U901.15 (SDA)
~INT_A: U901.13 (~INT)
~RESET: U901.3 (~RESET)

Notes on the sheet:
I2C GPIO Expander 1: TCAL9538
Address 0x71 (113) selected
Decoupling and Bypass Caps
Address Selection A1 A0 Device Address 0 0 0x70 (112) 0 1 0x71 (113) 1 0 0x72 (114) 1 1 0x73 (115)
