Dodokamel2005/EPS-/bac-hardware/mcu/micromod-main-board/dual-function-single-bacbus/ecad/i2c-mux.kicad_sch

## KiCad design bac-hardware/mcu/micromod-main-board/dual-function-single-bacbus/ecad/i2c-mux.kicad_sch (2025-06-12)

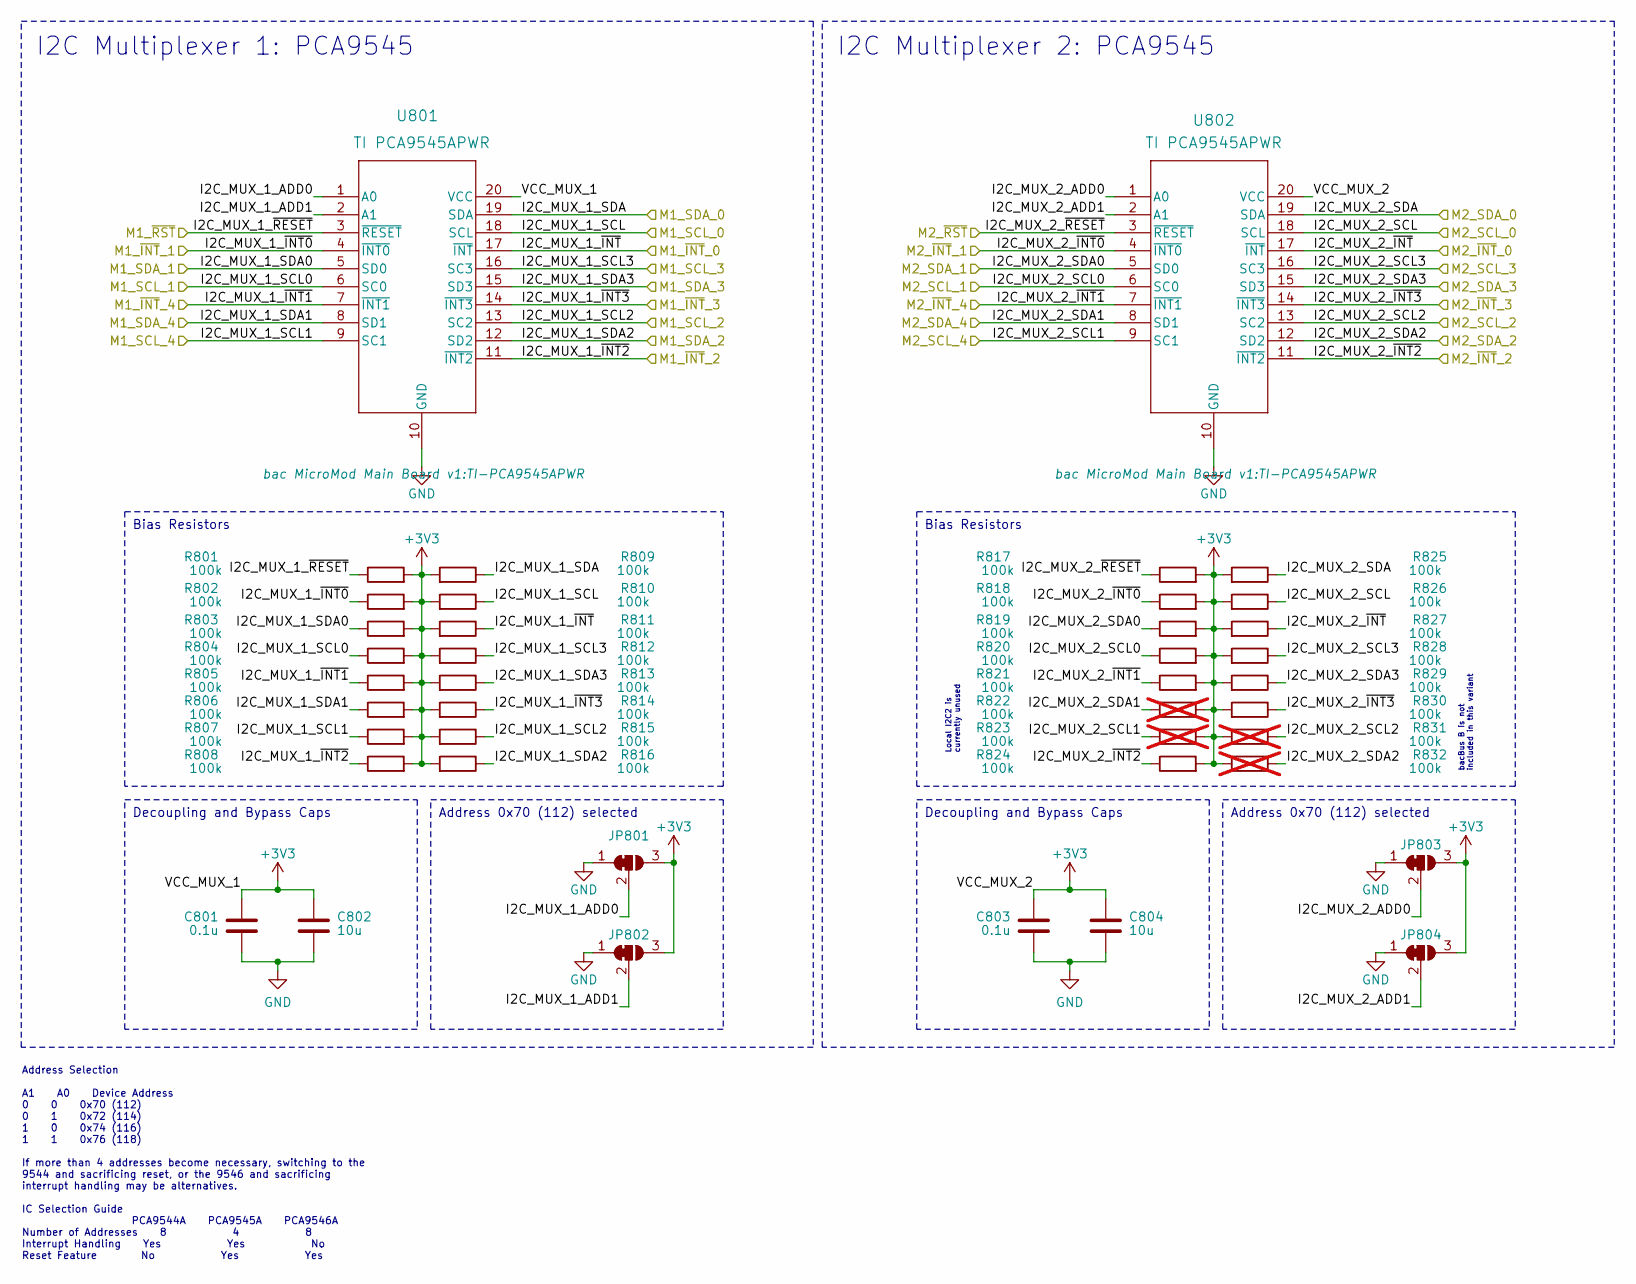
[picture p92: schematic i2c-mux.kicad_sch]

Parts:
C801, C803: 0.1u; bac-C-0603-0.1u; Rated Voltage 50V
C802, C804: 10u; bac-C-0805-10u; Rated Voltage 35V
JP801, JP802, JP803, JP804: SolderJumper_3_Bridged12; SolderJumper-3_P1.3mm_Bridged12_RoundedPad1.0x1.5mm_NumberL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
R801, R802, R803, R804, R805, R806, R807, R808, R809, R810, R811, R812, R813, R814, R815, R816, R817, R818, R819, R820, R821, R824, R825, R826, R827, R828, R829, R830: 100k; bac-R-0603-100k
R822, R823, R831, R832: 100k; bac-R-0603-100k; not fitted
U801, U802: TI PCA9545APWR; TI-PCA9545APWR

Connections:
+3V3: C801.1, C802.1, C803.1, C804.1, JP801.3 (B), JP802.3 (B), JP803.3 (B), JP804.3 (B), R801.2, R802.2, R803.2, R804.2, R805.2, R806.2, R807.2, R808.2, R809.2, R810.2, R811.2, R812.2, R813.2, R814.2, R815.2, R816.2, R817.2, R818.2, R819.2, R820.2, R821.2, R822.2, R823.2, R824.2, R825.2, R826.2, R827.2, R828.2, R829.2, R830.2, R831.2, R832.2, U801.20 (VCC), U802.20 (VCC)
GND: C801.2, C802.2, C803.2, C804.2, JP801.1 (A), JP802.1 (A), JP803.1 (A), JP804.1 (A), U801.10 (GND), U802.10 (GND)
I2C_MUX_1_ADD0: JP801.2 (C), U801.1 (A0)
I2C_MUX_1_ADD1: JP802.2 (C), U801.2 (A1)
I2C_MUX_1_SCL: R810.1, U801.18 (SCL)
I2C_MUX_1_SCL0: R804.1, U801.6 (SC0)
I2C_MUX_1_SCL1: R807.1, U801.9 (SC1)
I2C_MUX_1_SCL2: R815.1, U801.13 (SC2)
I2C_MUX_1_SCL3: R812.1, U801.16 (SC3)
I2C_MUX_1_SDA: R809.1, U801.19 (SDA)
I2C_MUX_1_SDA0: R803.1, U801.5 (SD0)
I2C_MUX_1_SDA1: R806.1, U801.8 (SD1)
I2C_MUX_1_SDA2: R816.1, U801.12 (SD2)
I2C_MUX_1_SDA3: R813.1, U801.15 (SD3)
I2C_MUX_1_~INT0: R802.1, U801.4 (~INT0)
I2C_MUX_1_~INT1: R805.1, U801.7 (~INT1)
I2C_MUX_1_~INT2: R808.1, U801.11 (~INT2)
I2C_MUX_1_~INT3: R814.1, U801.14 (~INT3)
I2C_MUX_1_~INT: R811.1, U801.17 (~INT)
I2C_MUX_1_~RESET: R801.1, U801.3 (~RESET)
I2C_MUX_2_ADD0: JP803.2 (C), U802.1 (A0)
I2C_MUX_2_ADD1: JP804.2 (C), U802.2 (A1)
I2C_MUX_2_SCL: R826.1, U802.18 (SCL)
I2C_MUX_2_SCL0: R820.1, U802.6 (SC0)
I2C_MUX_2_SCL1: R823.1, U802.9 (SC1)
I2C_MUX_2_SCL2: R831.1, U802.13 (SC2)
I2C_MUX_2_SCL3: R828.1, U802.16 (SC3)
I2C_MUX_2_SDA: R825.1, U802.19 (SDA)
I2C_MUX_2_SDA0: R819.1, U802.5 (SD0)
I2C_MUX_2_SDA1: R822.1, U802.8 (SD1)
I2C_MUX_2_SDA2: R832.1, U802.12 (SD2)
I2C_MUX_2_SDA3: R829.1, U802.15 (SD3)
I2C_MUX_2_~INT0: R818.1, U802.4 (~INT0)
I2C_MUX_2_~INT1: R821.1, U802.7 (~INT1)
I2C_MUX_2_~INT2: R824.1, U802.11 (~INT2)
I2C_MUX_2_~INT3: R830.1, U802.14 (~INT3)
I2C_MUX_2_~INT: R827.1, U802.17 (~INT)
I2C_MUX_2_~RESET: R817.1, U802.3 (~RESET)

Notes on the sheet:
I2C Multiplexer 1: PCA9545
I2C Multiplexer 2: PCA9545
Bias Resistors
Decoupling and Bypass Caps
Address 0x70 (112) selected
Address Selection A1 A0 Device Address 0 0 0x70 (112) 0 1 0x72 (114) 1 0 0x74 (116) 1 1 0x76 (118) If more than 4 addresses become necessary, switching to the 9544 and sacrificing reset, or the 9546 and sacrificing interrupt handling may be alternatives. IC Selection Guide PCA9544A PCA9545A PCA9546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
bacBus B is not included in this variant
Local I2C2 is currently unused
