Dodokamel2005/EPS-/bac-hardware/mcu/micromod-main-board/dual-function-single-bacbus/ecad/mcu.kicad_sch

## KiCad design bac-hardware/mcu/micromod-main-board/dual-function-single-bacbus/ecad/mcu.kicad_sch (2025-06-12)

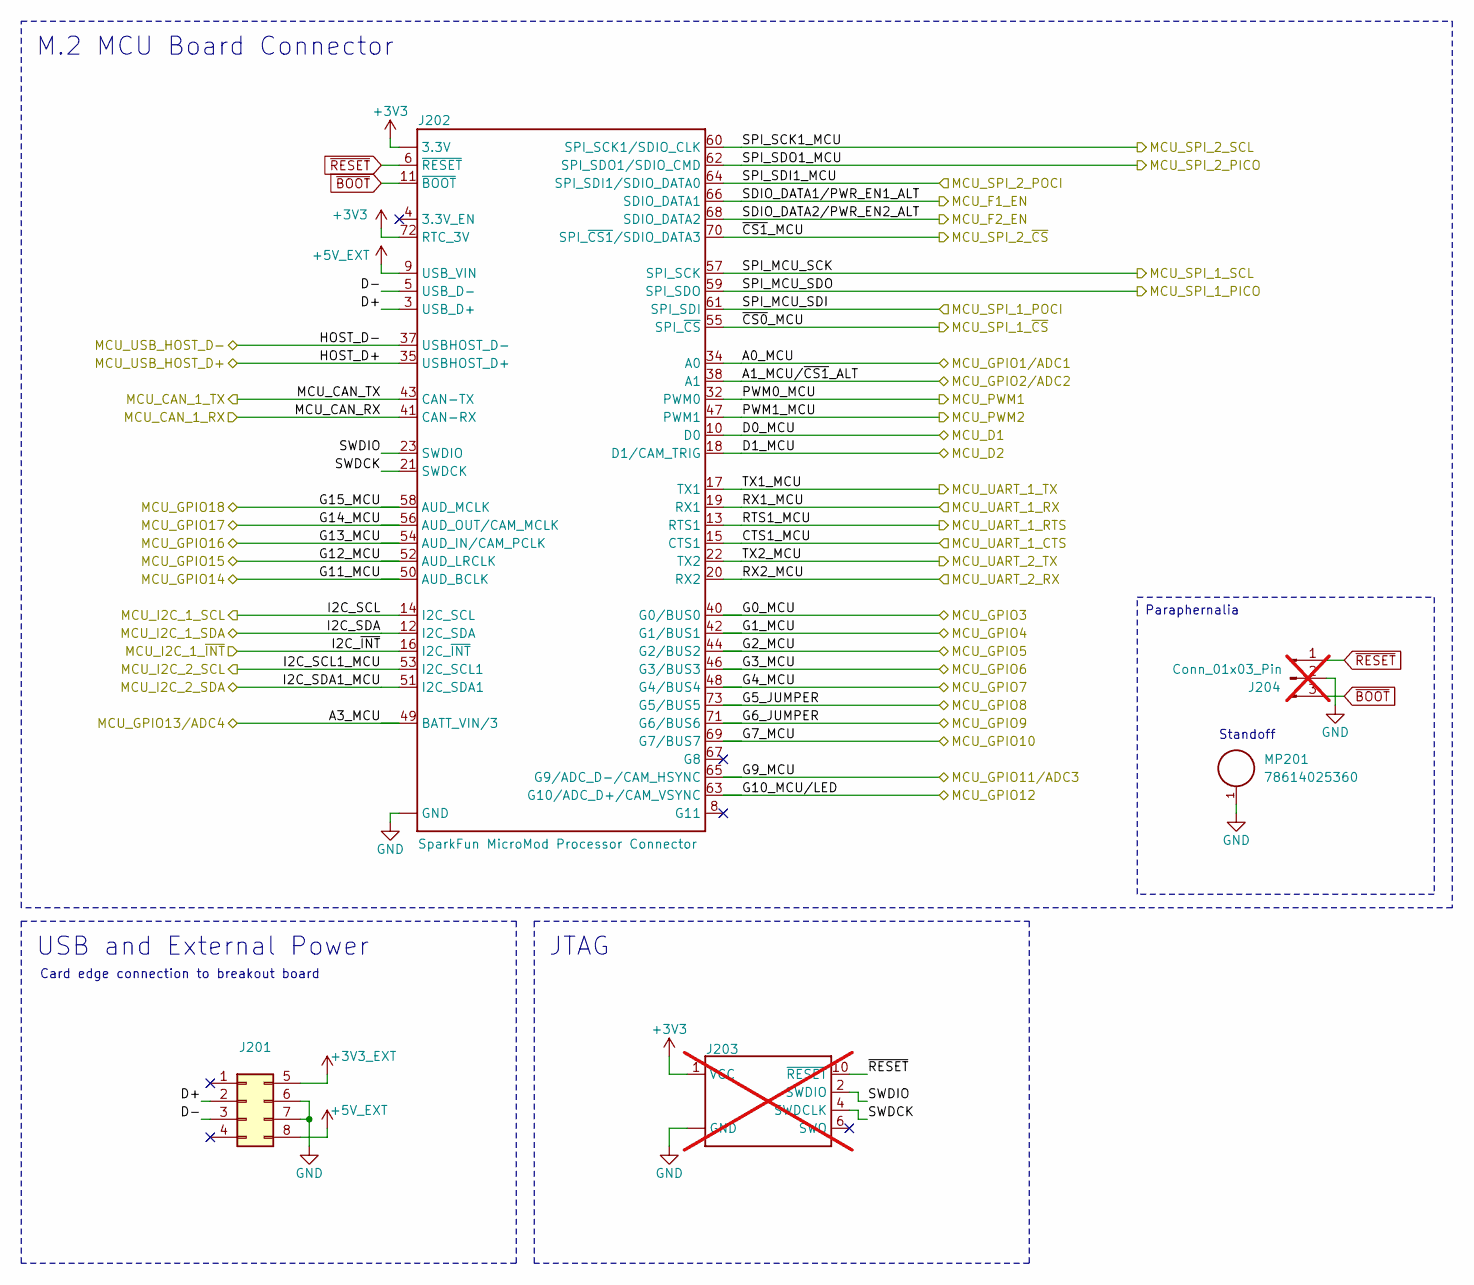
[picture p93: schematic mcu.kicad_sch]

Parts:
J201: Conn_02x04_Top_Bottom; bac-KYO-00-9159-BTB
J202: SparkFun MicroMod Processor Connector; bac-M.2-Key-E-MicroMod-Processor
J203: SparkFun JTAG; PinHeader_2x05_P1.27mm_Vertical; not fitted
J204: Conn_01x03_Pin; PinHeader_1x03_P2.54mm_Vertical_SMD_Pin1Left; not fitted
MP201: 78614025360; WE-9774025243R

Connections:
+3V3: J202.2 (3.3V), J202.72 (RTC_3V), J202.74 (3.3V), J203.1 (VCC)
+3V3_EXT: J201.5
+5V_EXT: J201.8, J202.9 (USB_VIN)
A0_MCU: J202.34 (A0)
A1_MCU/~CS1_ALT: J202.38 (A1)
A3_MCU: J202.49 (BATT_VIN/3)
CTS1_MCU: J202.15 (CTS1)
D0_MCU: J202.10 (D0)
D1_MCU: J202.18 (D1/CAM_TRIG)
D+: J201.2, J202.3 (USB_D+)
D-: J201.3, J202.5 (USB_D-)
G0_MCU: J202.40 (G0/BUS0)
G1_MCU: J202.42 (G1/BUS1)
G2_MCU: J202.44 (G2/BUS2)
G3_MCU: J202.46 (G3/BUS3)
G4_MCU: J202.48 (G4/BUS4)
G5_JUMPER: J202.73 (G5/BUS5)
G6_JUMPER: J202.71 (G6/BUS6)
G7_MCU: J202.69 (G7/BUS7)
G9_MCU: J202.65 (G9/ADC_D-/CAM_HSYNC)
G10_MCU/LED: J202.63 (G10/ADC_D+/CAM_VSYNC)
G11_MCU: J202.50 (AUD_BCLK)
G12_MCU: J202.52 (AUD_LRCLK)
G13_MCU: J202.54 (AUD_IN/CAM_PCLK)
G14_MCU: J202.56 (AUD_OUT/CAM_MCLK)
G15_MCU: J202.58 (AUD_MCLK)
GND: J201.6, J201.7, J202.1 (GND), J202.7 (GND), J202.33 (GND), J202.36 (GND), J202.39 (GND), J202.45 (GND), J202.75 (GND), J203.3 (GND), J203.5 (GND), J203.9 (GND), J204.2, MP201.1
HOST_D+: J202.35 (USBHOST_D+)
HOST_D-: J202.37 (USBHOST_D-)
I2C_SCL: J202.14 (I2C_SCL)
I2C_SCL1_MCU: J202.53 (I2C_SCL1)
I2C_SDA: J202.12 (I2C_SDA)
I2C_SDA1_MCU: J202.51 (I2C_SDA1)
I2C_~INT: J202.16 (I2C_~INT)
MCU_CAN_1_RX: J202.41 (CAN-RX)
MCU_CAN_1_TX: J202.43 (CAN-TX)
MCU_F1_EN: J202.66 (SDIO_DATA1)
MCU_F2_EN: J202.68 (SDIO_DATA2)
MCU_PWM1: J202.32 (PWM0)
MCU_PWM2: J202.47 (PWM1)
MCU_SPI_1_PICO: J202.59 (SPI_SDO)
MCU_SPI_1_POCI: J202.61 (SPI_SDI)
MCU_SPI_1_SCL: J202.57 (SPI_SCK)
MCU_SPI_1_~CS: J202.55 (SPI_~CS)
MCU_SPI_2_PICO: J202.62 (SPI_SDO1/SDIO_CMD)
MCU_SPI_2_POCI: J202.64 (SPI_SDI1/SDIO_DATA0)
MCU_SPI_2_SCL: J202.60 (SPI_SCK1/SDIO_CLK)
MCU_SPI_2_~CS: J202.70 (SPI_~CS1/SDIO_DATA3)
MCU_UART_1_RTS: J202.13 (RTS1)
MCU_UART_1_RX: J202.19 (RX1)
MCU_UART_1_TX: J202.17 (TX1)
MCU_UART_2_RX: J202.20 (RX2)
MCU_UART_2_TX: J202.22 (TX2)
SWDCK: J202.21 (SWDCK), J203.4 (SWDCLK)
SWDIO: J202.23 (SWDIO), J203.2 (SWDIO)
~BOOT: J202.11 (~BOOT), J204.3
~RESET: J202.6 (~RESET), J203.10 (~RESET), J204.1

Notes on the sheet:
USB and External Power
JTAG
Paraphernalia
M.2 MCU Board Connector
Standoff
Card edge connection to breakout board
