Dodokamel2005/EPS-/bac-hardware/mcu/micromod-main-board/dual-function-single-bacbus/ecad/power-mux.kicad_sch

## KiCad design bac-hardware/mcu/micromod-main-board/dual-function-single-bacbus/ecad/power-mux.kicad_sch (2025-06-12)

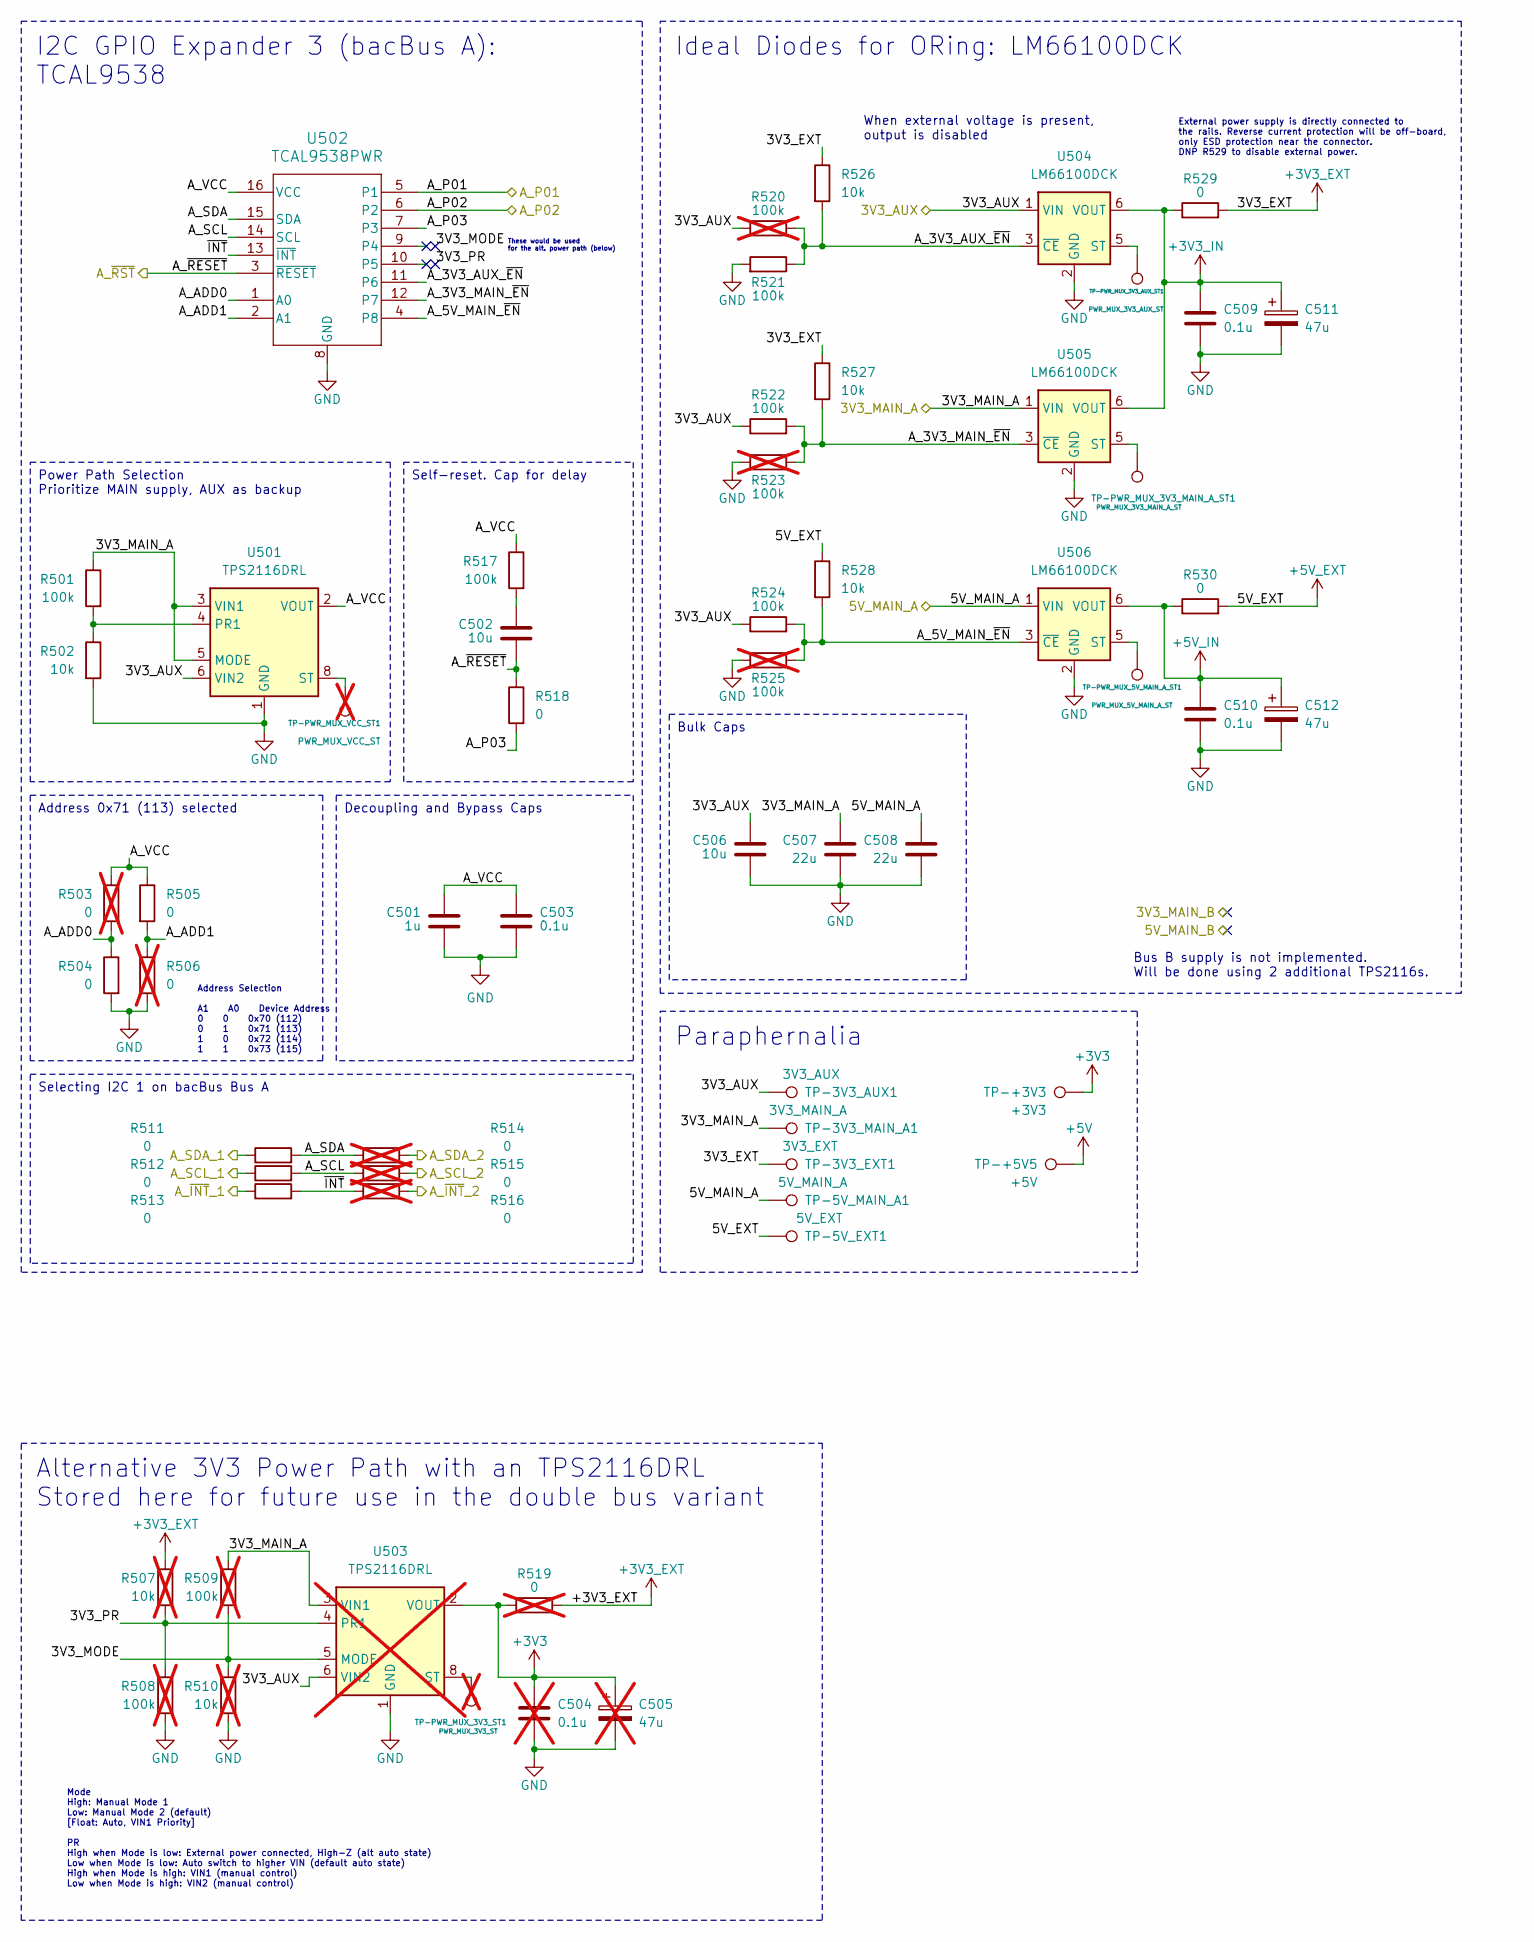
[picture p94: schematic power-mux.kicad_sch]

Parts:
C501: 1u; bac-C-0603-1u; Rated Voltage 35V
C502, C506: 10u; bac-C-0805-10u; Rated Voltage 25V
C503, C509, C510: 0.1u; bac-C-0603-0.1u; Rated Voltage 50V
C504: 0.1u; bac-C-0603-0.1u; Rated Voltage 50V; not fitted
C505: 47u; bac-C-1411; Rated Voltage 25V; not fitted
C507, C508: 22u; C_1210_3225Metric; Rated Voltage 25V
C511: 47u; bac-C-1411; Rated Voltage 25V
C512: 47u; bac-C-1411; Rated Voltage 16V
R501, R517, R521, R522, R524: 100k; bac-R-0603-100k
R502, R526, R527, R528: 10k; bac-R-0603-10k
R503, R506, R514, R515, R516, R519: 0; bac-R-0603-0; not fitted
R504, R505, R511, R512, R513, R518, R529, R530: 0; bac-R-0603-0
R507, R510: 10k; bac-R-0603-10k; not fitted
R508, R509, R520, R523, R525: 100k; bac-R-0603-100k; not fitted
TP-3V3_AUX1: 3V3_AUX; TestPoint_Pad_D1.0mm
TP-3V3_EXT1: 3V3_EXT; TestPoint_Pad_D1.0mm
TP-3V3_MAIN_A1: 3V3_MAIN_A; TestPoint_Pad_D1.0mm
TP-5V_EXT1: 5V_EXT; TestPoint_Pad_D1.0mm
TP-5V_MAIN_A1: 5V_MAIN_A; TestPoint_Pad_D1.0mm
TP-+3V3: +3V3; TestPoint_Pad_D1.0mm
TP-+5V5: +5V; TestPoint_Pad_D1.0mm
TP-PWR_MUX_3V3_AUX_ST1: PWR_MUX_3V3_AUX_ST; TestPoint_Pad_D1.0mm
TP-PWR_MUX_3V3_MAIN_A_ST1: PWR_MUX_3V3_MAIN_A_ST; TestPoint_Pad_D1.0mm
TP-PWR_MUX_3V3_ST1: PWR_MUX_3V3_ST; TestPoint_Pad_D1.0mm; not fitted
TP-PWR_MUX_5V_MAIN_A_ST1: PWR_MUX_5V_MAIN_A_ST; TestPoint_Pad_D1.0mm
TP-PWR_MUX_VCC_ST1: PWR_MUX_VCC_ST; TestPoint_Pad_D1.0mm; not fitted
U501: TPS2116DRL; TI-TPS2116DRL
U502: TCAL9538PWR; TI-TCAL9538PWR
U503: TPS2116DRL; TI-TPS2116DRL; not fitted
U504, U505, U506: LM66100DCK; SOT-363_SC-70-6

Connections:
3V3_AUX: C506.1, R520.1, R522.1, R524.1, TP-3V3_AUX1.1, U501.6 (VIN2), U503.6 (VIN2), U504.1 (VIN)
3V3_MAIN_A: C507.1, R501.1, R509.1, TP-3V3_MAIN_A1.1, U501.3 (VIN1), U501.5 (MODE), U503.3 (VIN1), U505.1 (VIN)
3V3_MODE: R509.2, R510.1, U503.5 (MODE)
3V3_PR: R507.2, R508.1, U503.4 (PR1)
5V_MAIN_A: C508.1, TP-5V_MAIN_A1.1, U506.1 (VIN)
+3V3: C504.1, C505.1, R519.1, TP-+3V3.1, U503.2 (VOUT), U503.7 (VOUT)
+3V3_EXT: R507.1, R519.2, R526.1, R527.1, R529.2, TP-3V3_EXT1.1
+3V3_IN: C509.1, C511.1, R529.1, U504.6 (VOUT), U505.6 (VOUT)
+5V: TP-+5V5.1
+5V_EXT: R528.1, R530.2, TP-5V_EXT1.1
+5V_IN: C510.1, C512.1, R530.1, U506.6 (VOUT)
A_3V3_AUX_~EN: R520.2, R521.1, R526.2, U502.11 (P6), U504.3 (~CE)
A_3V3_MAIN_~EN: R522.2, R523.1, R527.2, U502.12 (P7), U505.3 (~CE)
A_5V_MAIN_~EN: R524.2, R525.1, R528.2, U502.4 (P8), U506.3 (~CE)
A_ADD0: R503.2, R504.1, U502.1 (A0)
A_ADD1: R505.2, R506.1, U502.2 (A1)
A_P01: U502.5 (P1)
A_P02: U502.6 (P2)
A_P03: R518.2, U502.7 (P3)
A_SCL: R512.2, R515.1, U502.14 (SCL)
A_SCL_1: R512.1
A_SCL_2: R515.2
A_SDA: R511.2, R514.1, U502.15 (SDA)
A_SDA_1: R511.1
A_SDA_2: R514.2
A_VCC: C501.1, C503.1, R503.1, R505.1, R517.1, U501.2 (VOUT), U501.7 (VOUT), U502.16 (VCC)
A_~INT_1: R513.1
A_~INT_2: R516.2
A_~RESET: C502.2, R518.1, U502.3 (~RESET)
GND: C501.2, C503.2, C504.2, C505.2, C506.2, C507.2, C508.2, C509.2, C510.2, C511.2, C512.2, R502.2, R504.2, R506.2, R508.2, R510.2, R521.2, R523.2, R525.2, U501.1 (GND), U502.8 (GND), U503.1 (GND), U504.2 (GND), U505.2 (GND), U506.2 (GND)
unnamed: C502.1, R517.2
unnamed: R501.2, R502.1, U501.4 (PR1)
unnamed: TP-PWR_MUX_3V3_AUX_ST1.1, U504.5 (ST)
unnamed: TP-PWR_MUX_3V3_MAIN_A_ST1.1, U505.5 (ST)
unnamed: TP-PWR_MUX_3V3_ST1.1, U503.8 (ST)
unnamed: TP-PWR_MUX_5V_MAIN_A_ST1.1, U506.5 (ST)
unnamed: TP-PWR_MUX_VCC_ST1.1, U501.8 (ST)
~INT: R513.2, R516.1, U502.13 (~INT)

Notes on the sheet:
Paraphernalia
Power Path Selection Prioritize MAIN supply, AUX as backup
Selecting I2C 1 on bacBus Bus A
I2C GPIO Expander 3 (bacBus A): TCAL9538
Alternative 3V3 Power Path with an TPS2116DRL Stored here for future use in the double bus variant
Ideal Diodes for ORing: LM66100DCK
Self-reset. Cap for delay
Decoupling and Bypass Caps
Address 0x71 (113) selected
Bulk Caps
Address Selection A1 A0 Device Address 0 0 0x70 (112) 0 1 0x71 (113) 1 0 0x72 (114) 1 1 0x73 (115)
When external voltage is present, output is disabled
Mode High: Manual Mode 1 Low: Manual Mode 2 (default) [Float: Auto, VIN1 Priority] PR High when Mode is low: External power connected, High-Z (alt auto state) Low when Mode is low: Auto switch to higher VIN (default auto state) High when Mode is high: VIN1 (manual control) Low when Mode is high: VI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
Bus B supply is not implemented. Will be done using 2 additional TPS2116s.
These would be used for the alt. power path (below)
External power supply is directly connected to the rails. Reverse current protection will be off-board, only ESD protection near the connector. DNP R529 to disable external power.
