Dodokamel2005/EPS-/bac-hardware/mcu/micromod-main-board/dual-function-single-bacbus/ecad/rtc.kicad_sch

## KiCad design bac-hardware/mcu/micromod-main-board/dual-function-single-bacbus/ecad/rtc.kicad_sch (2025-06-12)

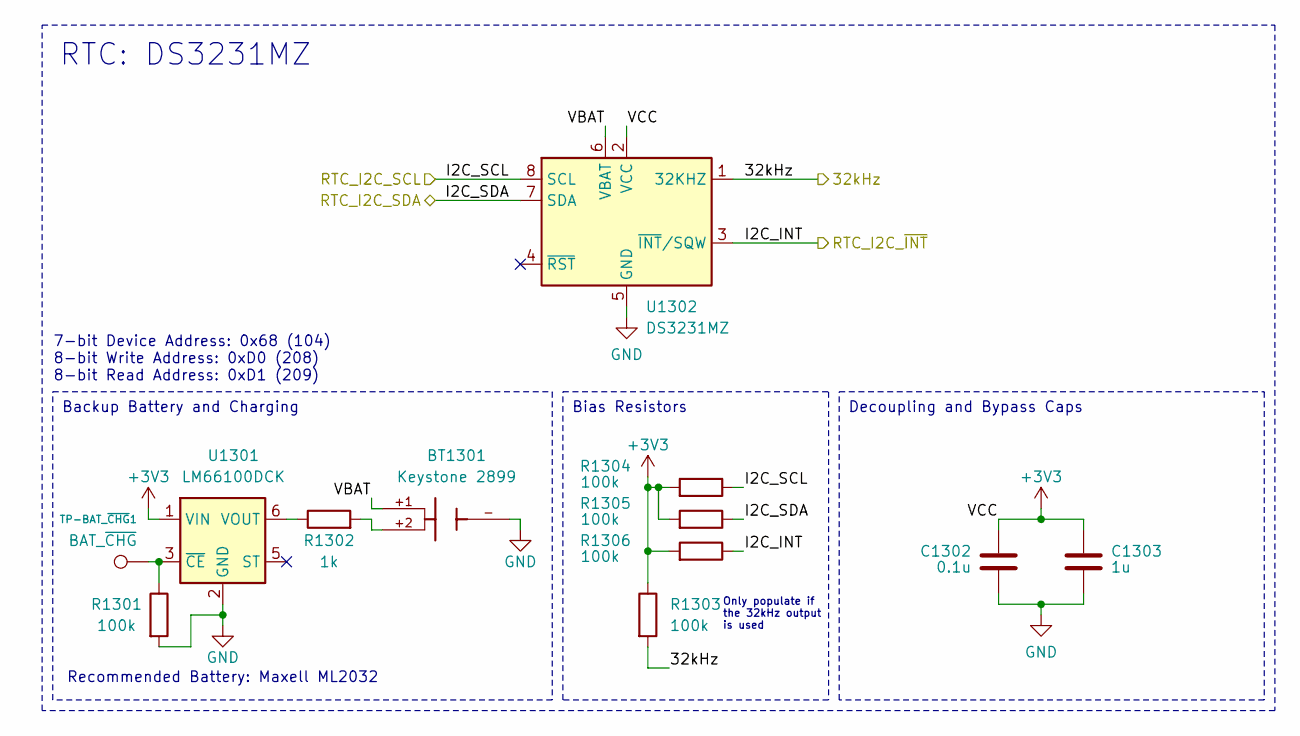
[picture p95: schematic rtc.kicad_sch]

Parts:
BT1301: Keystone 2899; KEY-2899; PARTREV B
C1302: 0.1u; bac-C-0603-0.1u; Rated Voltage 50V
C1303: 1u; bac-C-0603-1u; Rated Voltage 35V
R1301, R1303, R1304, R1305, R1306: 100k; bac-R-0603-100k
R1302: 1k; R_0603_1608Metric
TP-BAT_~{CHG}1: BAT_~{CHG}; TestPoint_Pad_D1.0mm
U1301: LM66100DCK; SOT-363_SC-70-6
U1302: DS3231MZ; SOIC-8_3.9x4.9mm_P1.27mm

Connections:
32kHz: R1303.2, U1302.1 (32KHZ)
+3V3: C1302.1, C1303.1, R1303.1, R1304.2, R1305.2, R1306.2, U1301.1 (VIN), U1302.2 (VCC)
GND: BT1301.-, C1302.2, C1303.2, R1301.2, U1301.2 (GND), U1302.5 (GND)
I2C_INT: R1306.1, U1302.3 (~INT/SQW)
I2C_SCL: R1304.1, U1302.8 (SCL)
I2C_SDA: R1305.1, U1302.7 (SDA)
unnamed: BT1301.+2, R1302.2
unnamed: R1301.1, TP-BAT_~{CHG}1.1, U1301.3 (~CE)
unnamed: R1302.1, U1301.6 (VOUT)
VBAT: BT1301.+1, U1302.6 (VBAT)

Notes on the sheet:
Decoupling and Bypass Caps
Bias Resistors
Backup Battery and Charging
RTC: DS3231MZ
Only populate if the 32kHz output is used
Recommended Battery: Maxell ML2032
7-bit Device Address: 0x68 (104) 8-bit Write Address: 0xD0 (208) 8-bit Read Address: 0xD1 (209)
