Dodokamel2005/EPS-/bac-hardware/mcu/micromod-main-board/dual-function-single-bacbus/ecad/sensors.kicad_sch

## KiCad design bac-hardware/mcu/micromod-main-board/dual-function-single-bacbus/ecad/sensors.kicad_sch (2025-06-12)

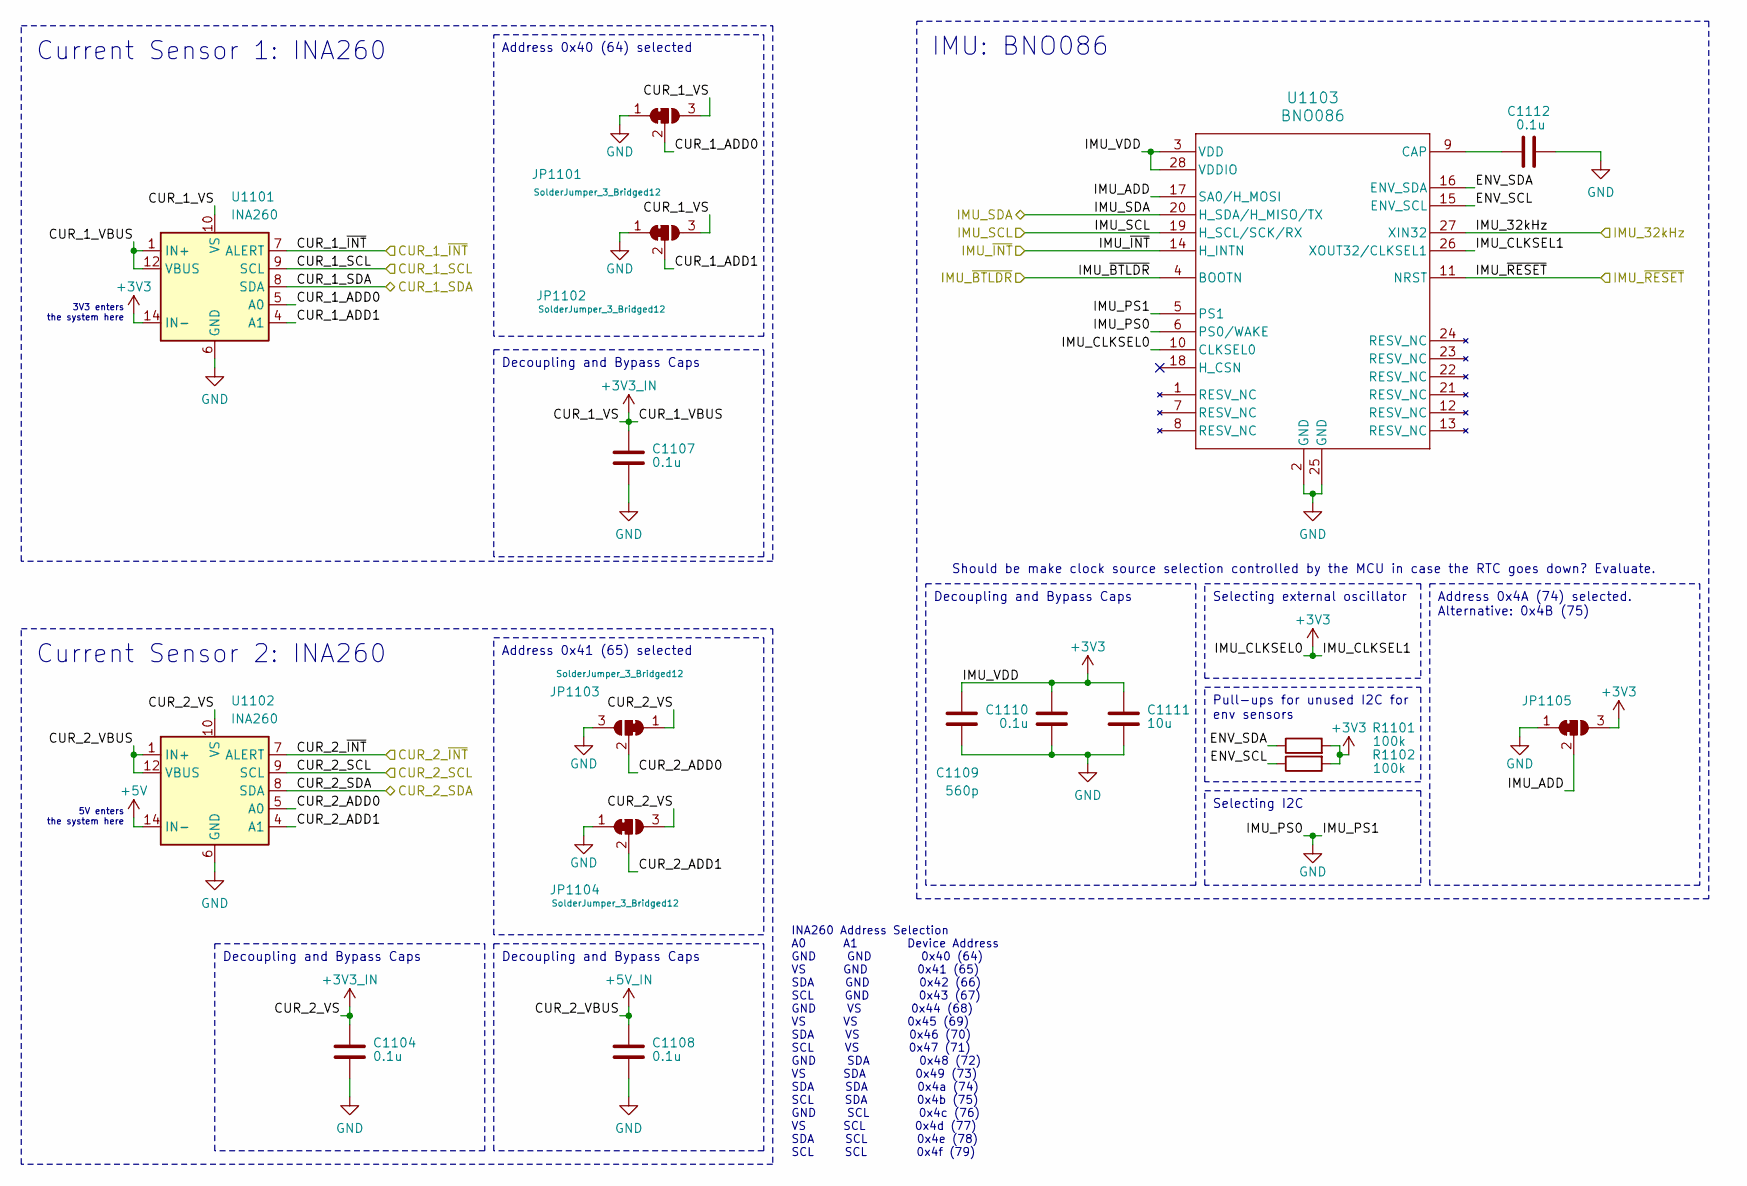
[picture p96: schematic sensors.kicad_sch]

Parts:
C1104, C1107, C1108, C1110, C1112: 0.1u; bac-C-0603-0.1u; Rated Voltage 50V
C1109: 560p; C_0603_1608Metric; Rated Voltage 50V
C1111: 10u; bac-C-0805-10u; Rated Voltage 25V
JP1101, JP1102, JP1103, JP1104, JP1105: SolderJumper_3_Bridged12; SolderJumper-3_P1.3mm_Bridged12_RoundedPad1.0x1.5mm_NumberL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
R1101, R1102: 100k; bac-R-0603-100k
U1101, U1102: INA260; TSSOP-16_4.4x5mm_P0.65mm
U1103: BNO086; CEVA-BNO086

Connections:
+3V3: C1109.1, C1110.1, C1111.1, JP1105.3 (B), R1101.2, R1102.2, U1101.14 (IN-), U1101.15 (IN-), U1101.16 (IN-), U1103.3 (VDD), U1103.10 (CLKSEL0), U1103.26 (XOUT32/CLKSEL1), U1103.28 (VDDIO)
+3V3_IN: C1104.1, C1107.1, JP1101.3 (B), JP1102.3 (B), JP1103.1 (A), JP1104.3 (B), U1101.1 (IN+), U1101.2 (IN+), U1101.3 (IN+), U1101.10 (VS), U1101.12 (VBUS), U1102.10 (VS)
+5V: U1102.14 (IN-), U1102.15 (IN-), U1102.16 (IN-)
+5V_IN: C1108.1, U1102.1 (IN+), U1102.2 (IN+), U1102.3 (IN+), U1102.12 (VBUS)
CUR_1_ADD0: JP1101.2 (C), U1101.5 (A0)
CUR_1_ADD1: JP1102.2 (C), U1101.4 (A1)
CUR_1_SCL: U1101.9 (SCL)
CUR_1_SDA: U1101.8 (SDA)
CUR_1_~INT: U1101.7 (ALERT)
CUR_2_ADD0: JP1103.2 (C), U1102.5 (A0)
CUR_2_ADD1: JP1104.2 (C), U1102.4 (A1)
CUR_2_SCL: U1102.9 (SCL)
CUR_2_SDA: U1102.8 (SDA)
CUR_2_~INT: U1102.7 (ALERT)
ENV_SCL: R1102.1, U1103.15 (ENV_SCL)
ENV_SDA: R1101.1, U1103.16 (ENV_SDA)
GND: C1104.2, C1107.2, C1108.2, C1109.2, C1110.2, C1111.2, C1112.1, JP1101.1 (A), JP1102.1 (A), JP1103.3 (B), JP1104.1 (A), JP1105.1 (A), U1101.6 (GND), U1101.11 (GND), U1102.6 (GND), U1102.11 (GND), U1103.2 (GND), U1103.5 (PS1), U1103.6 (PS0/WAKE), U1103.25 (GND)
IMU_32kHz: U1103.27 (XIN32)
IMU_ADD: JP1105.2 (C), U1103.17 (SA0/H_MOSI)
IMU_SCL: U1103.19 (H_SCL/SCK/RX)
IMU_SDA: U1103.20 (H_SDA/H_MISO/TX)
IMU_~BTLDR: U1103.4 (BOOTN)
IMU_~INT: U1103.14 (H_INTN)
IMU_~RESET: U1103.11 (NRST)
unnamed: C1112.2, U1103.9 (CAP)

Notes on the sheet:
IMU: BNO086
Selecting external oscillator
Pull-ups for unused I2C for env sensors
Decoupling and Bypass Caps
Selecting I2C
Current Sensor 2: INA260
Address 0x41 (65) selected
Address 0x4A (74) selected. Alternative: 0x4B (75)
Address 0x40 (64) selected
Current Sensor 1: INA260
5V enters the system here
3V3 enters the system here
INA260 Address Selection A0 A1 Device Address GND GND 0x40 (64) VS GND 0x41 (65) SDA GND 0x42 (66) SCL GND 0x43 (67) GND VS 0x44 (68) VS VS 0x45 (69) SDA VS 0x46 (70) SCL VS 0x47 (71) GND SDA 0x48 (72) VS SDA 0x49 (73) SDA SDA 0x4a (74) SCL SDA 0x4b (75) GND SCL 0x4c (76) VS SCL 0x4d (77) SDA SCL 0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
Should be make clock source selection controlled by the MCU in case the RTC goes down? Evaluate.
