Dodokamel2005/EPS-/bac-hardware/mcu/micromod-main-board/dual-function-single-bacbus/ecad/spi-mux.kicad_sch

## KiCad design bac-hardware/mcu/micromod-main-board/dual-function-single-bacbus/ecad/spi-mux.kicad_sch (2025-06-12)

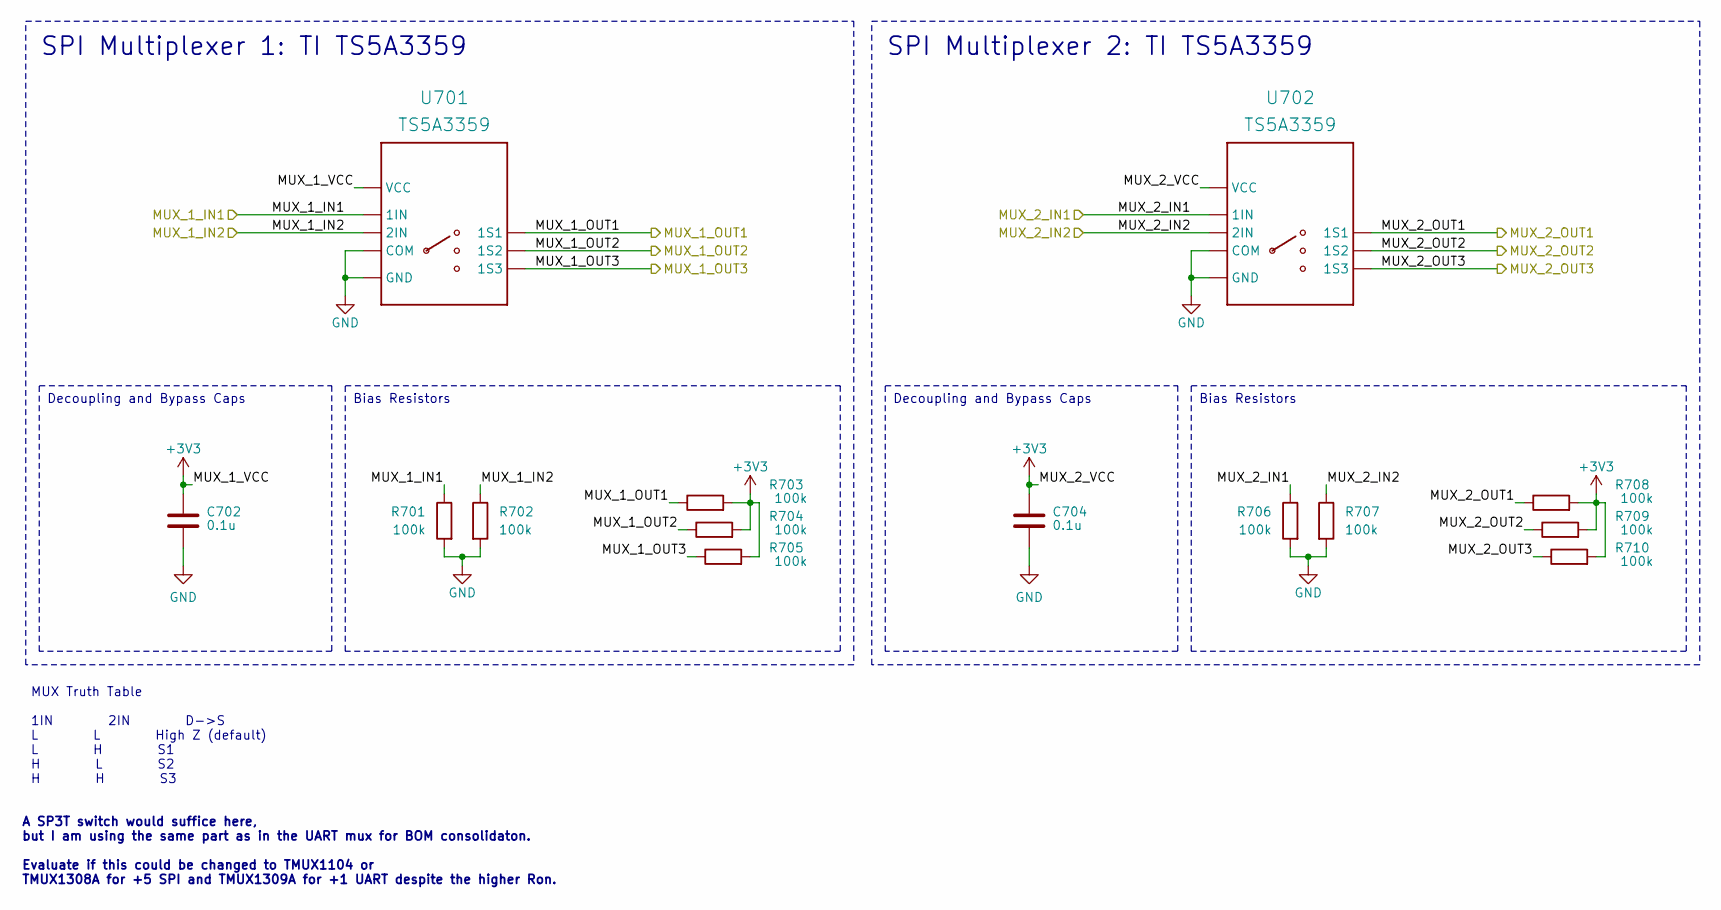
[picture p97: schematic spi-mux.kicad_sch]

Parts:
C702, C704: 0.1u; bac-C-0603-0.1u; Rated Voltage 50V
R701, R702, R703, R704, R705, R706, R707, R708, R709, R710: 100k; bac-R-0603-100k
U701, U702: TS5A3359; TI-TS5A3359DCUR

Connections:
+3V3: C702.1, C704.1, R703.2, R704.2, R705.2, R708.2, R709.2, R710.2, U701.8 (VCC), U702.8 (VCC)
GND: C702.2, C704.2, R701.2, R702.2, R706.2, R707.2, U701.4 (GND), U701.7 (COM), U702.4 (GND), U702.7 (COM)
MUX_1_IN1: R701.1, U701.6 (1IN)
MUX_1_IN2: R702.1, U701.5 (2IN)
MUX_1_OUT1: R703.1, U701.1 (1S1)
MUX_1_OUT2: R704.1, U701.2 (1S2)
MUX_1_OUT3: R705.1, U701.3 (1S3)
MUX_2_IN1: R706.1, U702.6 (1IN)
MUX_2_IN2: R707.1, U702.5 (2IN)
MUX_2_OUT1: R708.1, U702.1 (1S1)
MUX_2_OUT2: R709.1, U702.2 (1S2)
MUX_2_OUT3: R710.1, U702.3 (1S3)

Notes on the sheet:
Bias Resistors
SPI Multiplexer 2: TI TS5A3359
Decoupling and Bypass Caps
SPI Multiplexer 1: TI TS5A3359
MUX Truth Table 1IN 2IN D->S L L High Z (default) L H S1 H L S2 H H S3
A SP3T switch would suffice here, but I am using the same part as in the UART mux for BOM consolidaton. Evaluate if this could be changed to TMUX1104 or TMUX1308A for +5 SPI and TMUX1309A for +1 UART despite the higher Ron.
