Dodokamel2005/EPS-/bac-hardware/mcu/micromod-main-board/dual-function-single-bacbus/ecad/uart-mux.kicad_sch

## KiCad design bac-hardware/mcu/micromod-main-board/dual-function-single-bacbus/ecad/uart-mux.kicad_sch (2025-06-12)

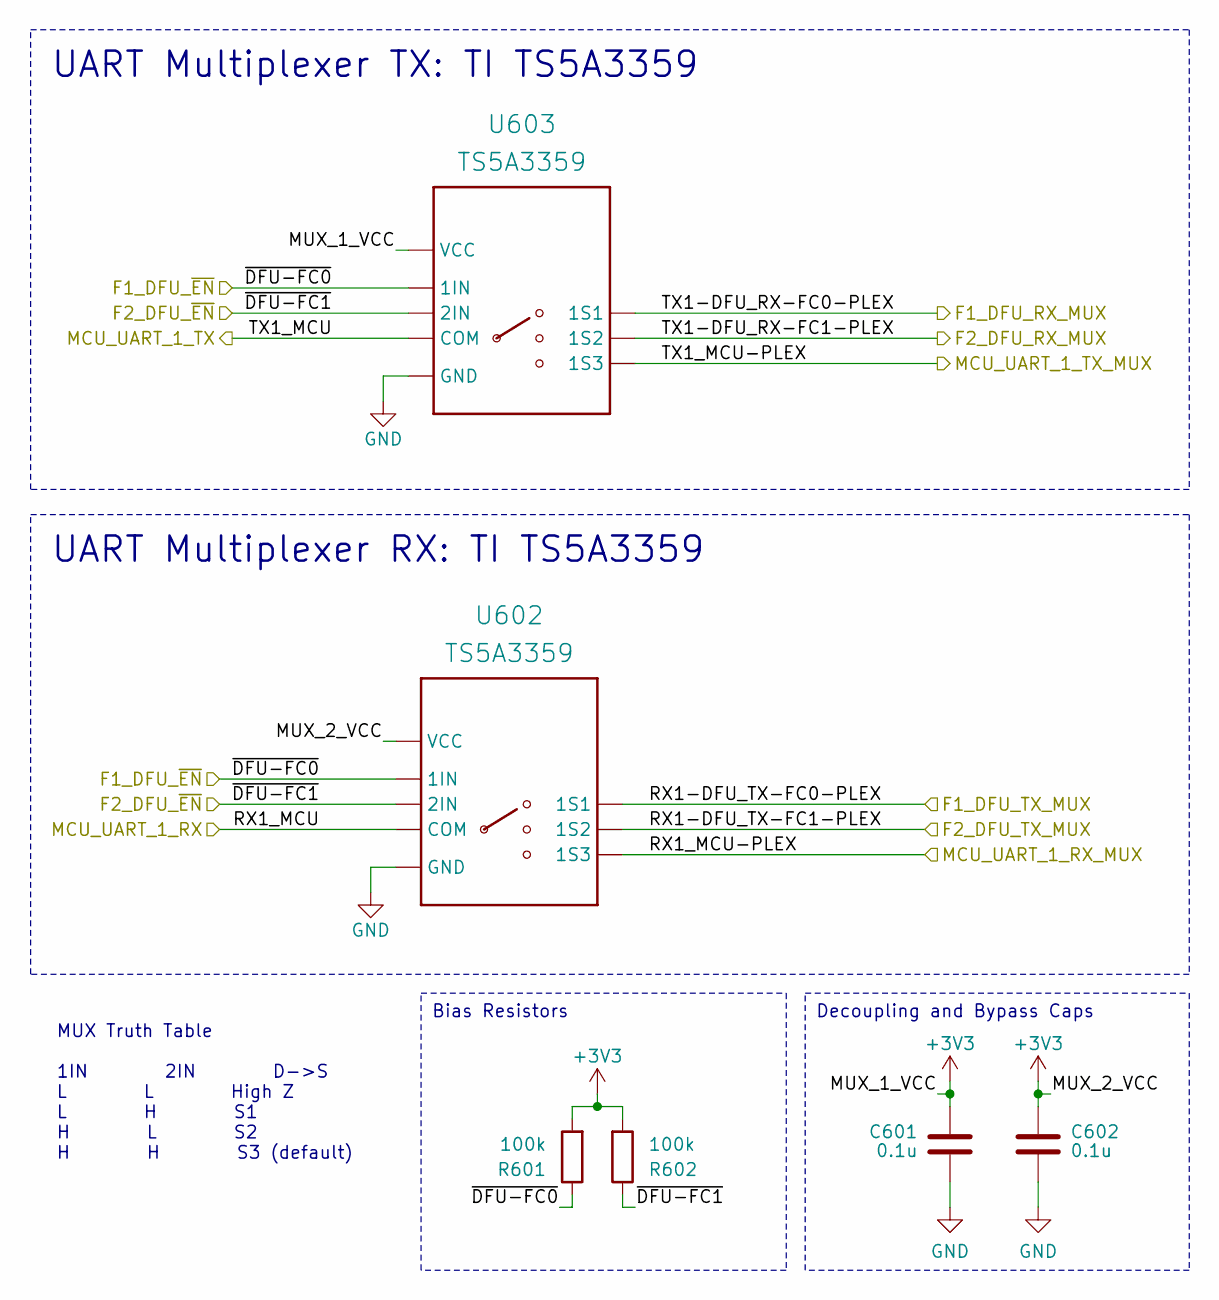
[picture p98: schematic uart-mux.kicad_sch]

Parts:
C601, C602: 0.1u; bac-C-0603-0.1u; Rated Voltage 50V
R601, R602: 100k; bac-R-0603-100k
U602, U603: TS5A3359; TI-TS5A3359DCUR

Connections:
+3V3: C601.1, C602.1, R601.2, R602.2, U602.8 (VCC), U603.8 (VCC)
F1_DFU_RX_MUX: U603.1 (1S1)
F1_DFU_TX_MUX: U602.1 (1S1)
F1_DFU_~EN: R601.1, U602.6 (1IN), U603.6 (1IN)
F2_DFU_RX_MUX: U603.2 (1S2)
F2_DFU_TX_MUX: U602.2 (1S2)
F2_DFU_~EN: R602.1, U602.5 (2IN), U603.5 (2IN)
GND: C601.2, C602.2, U602.4 (GND), U603.4 (GND)
MCU_UART_1_RX: U602.7 (COM)
MCU_UART_1_RX_MUX: U602.3 (1S3)
MCU_UART_1_TX: U603.7 (COM)
MCU_UART_1_TX_MUX: U603.3 (1S3)

Notes on the sheet:
Decoupling and Bypass Caps
UART Multiplexer RX: TI TS5A3359
Bias Resistors
UART Multiplexer TX: TI TS5A3359
MUX Truth Table 1IN 2IN D->S L L High Z L H S1 H L S2 H H S3 (default)
