Dodokamel2005/EPS-/(commit log)

2025-06-11 Battery charge controller
    [${BQ24650 PCB}.csv, BMS.kicad_pcb, BMS.kicad_sch, Battery charge controlller.kicad_pcb, Battery charge controlller.kicad_sch]
2025-06-12 EPS version 1
    [ADI-LT3045HMSE.step, ADI-LTM4675IY.step, ADI-LTM8062AEV.STEP, AL-ACS37612LLUATR-010B3.step, AMP-MDT350M01001VT.step, Battery charge controlller.kicad_pcb, C-2917-100uf-POL.STEP, CEVA-BNO086.step]
