Dodokamel2005/EPS-/(notices)

Notices in the files:
bac-hardware/resources/kicad-libraries/micromod-mainboard-v1/3d/FU-MB85RS256B.step:
Copyright (C) 2018, kicad StepUp
This work is licensed under the [Creative Commons CC-BY-SA 4.0 License](https://creativecommons.org/licenses/by-sa/4.0/legalcode),
with the following exception:
To the extent that the creation of electronic designs that use 'Licensed Material' can be considered to be 'Adapted Material',
You are free to use the library data in your own projects without the obligation to share your project files under this or any other license agreement.
bac-hardware/sbc/cm5-carrier-board/ecad/canbus.kicad_sch:
CERN-OHL-S-2.0
parts and their libraries:
License: Apache-2.0
